aratzps/MCU-C/docs/DECISIONS.md

# MCU-C — Design Decisions

Newest last. Each entry records what was decided, why, and what it constrains.

---

## D001: Fully integrated inverter, not a control board

- **Decision:** Control, gate drive, DC link, precharge and power stage on one assembly.
- **Why:** Project owner's choice, made with the trade-off stated explicitly.
- **Consequence:** DC-link sizing, precharge/discharge, creepage/clearance and thermal become primary constraints on this design rather than the power stage vendor's. This is the harder path — the original project split brain and power stage deliberately.
- **Affects:** Everything. See SPEC.md §1.

## D002: STM32F405VGT6 (LQFP100)

- **Decision:** STM32F405VGT6 in LQFP100.
- **Why:** Same die and firmware target as the VESC reference, so mainline `bldc` firmware applies. 100 pins instead of the 64 on the `RGT6` used by the original PALTA board gives room for all four position-feedback interfaces plus CAN, USB and the supervisor without pin conflicts.
- **Consequence:** No CAN FD is available on any STM32F405 — it has classic bxCAN 2.0B only. VESC's CAN protocol uses classic CAN, so this is not a limitation in practice, but CAN FD must not be specified anywhere.
- **Affects:** SPEC.md §12, firmware target, CAN transceiver selection.

## D003: All four rotor position interfaces supported

- **Decision:** Hall, ABI/quadrature encoder, resolver (AD2S1205) and SinCos/SSI.
- **Why:** Project owner's requirement. Resolver is appropriate at this power level and carries over from the original board.
- **Consequence:** Drives the pin budget and is a main reason for choosing LQFP100 over LQFP64.
- **Note:** Mainline VESC has no resolver driver. The AD2S1205's incremental-encoder emulation outputs (A, B, NM) let the resolver present as a standard ABI encoder that VESC already supports — so no firmware work is needed for basic operation.
- **Affects:** SPEC.md §8.4, MCU package choice, `pcb_design/resolver.sch` reuse.

## D004: 1200 V switch class, six-pack module

- **Decision:** 1200 V devices, in a single six-pack power module rather than discretes.
- **Why:** 450 V bus with switching overshoot and regenerative transients rules out 650 V. A module gives one thermal interface, vendor-controlled stray inductance, an integrated NTC, and removes the paralleling/current-sharing problem entirely.
- **Open:** Si IGBT vs SiC not yet decided — see SPEC.md §14 item 2.
- **Affects:** Gate drive, thermal design, cost, efficiency.

## D005: Current limits are fixed; power scales with bus voltage

- **Decision:** The board enforces current limits, not power limits. 15 kW / 35 kW are defined at 250 V nominal only.
- **Why:** Project owner's clarification. Physically correct — the hardware limits are thermal and current, not power.
- **Consequence:** 2.9 kW / 6.7 kW at 48 V; 27 kW / 49 kW at 450 V by current limit alone. **The board is not rated for 49 kW** — switching losses scale with bus voltage and the thermal design is sized at 250 V. Derating above 250 V is an open item.
- **Affects:** SPEC.md §2.1, §3, thermal design.

## D006: Phase current sized 1.5× above the value at rated power

- **Decision:** 75 A rms continuous, 175 A rms peak, ±300 A sense range.
- **Why:** Phase current at rated power (50 A / 117 A rms) occurs at full modulation, i.e. high speed. At low speed the motor draws the same current for the same torque at much lower voltage, so phase current rather than power is binding. 1.5× allows full torque at low speed.
- **Caveat:** The 1.5× factor is a judgement call made without knowledge of the target motor or duty cycle. It directly sets device count and cost and should be revisited once those are known.
- **Affects:** SPEC.md §3.3, module selection, current sensing, thermal.

## D007: Three isolated phase-current measurements

- **Decision:** Per-phase current sensing, not a single DC-link shunt.
- **Why:** VESC FOC reconstructs the current vector from per-phase samples. A single bus-level shunt cannot provide this.
- **Affects:** SPEC.md §8.1, ADC allocation, isolation count.

## D008: Firmware-independent hardware interlocks, carried over from PALTA

- **Decision:** Overcurrent latch and shoot-through/PWM-overlap elimination in discrete logic, with the aggregated fault driving TIM1_BKIN.
- **Why:** The most valuable feature of the original board (`pcb_design/supervisor.sch`). Routing the fault to the timer break input means an MCU lockup, firmware bug or bad configuration cannot leave the bridge conducting.
- **Affects:** SPEC.md §9.2, pin assignment (PB12), supervisor schematic reuse.

## D009: HV-derived auxiliary supply plus external 12–24 V input

- **Decision:** Isolated flyback from the 48–450 V bus (≥ 900 V primary switch), and a separate 12–24 V auxiliary input.
- **Why:** Control electronics must power up before the DC bus is live in order to sequence precharge, and to permit safe bench work on a de-energised bus. The 9.4:1 input range is the hard part of the flyback design.
- **Affects:** SPEC.md §11, precharge sequencing, bench bring-up.

## D010: Liquid cooling as baseline

- **Decision:** Cold plate. Forced air only at a reduced, characterised continuous rating.
- **Why:** 300–525 W continuous dissipation at 15 kW depending on Si vs SiC. This is a physical consequence of realistic device losses, not a preference.
- **Affects:** SPEC.md §11.4, mechanical concept, enclosure.

## D011: Target motor — EMRAX 188, High Voltage winding

- **Decision:** EMRAX 188 (or similar class), HV winding assumed. Figures verified against EMRAX 188 datasheet v1.6 (2026-07-31): peak 190 A rms / 100 Nm (S2 2 min), continuous 100 A rms, Kt 0.54 Nm/A, Kv 13.61 rpm/V at nominal load, 10 pole pairs, 8000 rpm max, KTY 81/210 stator temperature sensor, resolver/encoder feedback.
- **Why:** Owner's choice of motor. HV winding is the engineering recommendation: at 250 V nominal the HV envelope (100 Nm at ≈ 3400 rpm ≈ 35.6 kW) lands on the board's 35 kW rated point, and its 190/100 A rms currents match a sensible power stage. MV needs 310 A rms peak, LV 390–900 A — both oversize the inverter. The motor's full 60 kW at 6500 rpm needs 660 V and is unreachable on a 450 V bus; accepted.
- **Consequence:** §3.3 re-derived from motor ratings, superseding the 1.5× guess (D006): 100 A rms continuous, 190 A rms peak (10 s), 270 A instantaneous, ±325 A sense, 300 A hardware trip. Module criteria rise to ≥ 150 A continuous / ≥ 270 A peak. DC-link ripple rises to 60/114 A rms. A motor temperature input (KTY 81/210) is added to §8.3.
- **Open:** Winding variant must be confirmed at motor order time; if it changes, §3.3 is re-derived. Duty cycle still unstated — 10 s board peak vs motor's 2 min S2 rating noted in §3.3.
- **Affects:** SPEC.md §2.2, §3.3, §3.4, §4.3, §6, §8.1, §8.3, §9.1, module selection, thermal.

## D012: Peak duration 120 s, matched to the motor's S2 rating

- **Decision:** t_peak = 120 s (was 10 s [SEL]). Owner directive: match the inverter peak time to the motor's S2 2 min rating.
- **Why:** The motor sustains 190 A rms / 100 Nm for 2 min; a 10 s board limit would waste that capability.
- **Consequence:** 120 s is quasi-steady-state for the module baseplate, cold plate and coolant loop (thermal τ of tens of seconds). Cooling must therefore be sized for peak-condition losses — ~700 W (SiC) to ~1225 W (Si) at 35 kW — not the 300–525 W continuous figures. Module continuous-class criterion raised to ≥ 200 A. DC-link ripple duty (114 A rms) must be held for the full 120 s, which drives the capacitor bank rating.
- **Affects:** SPEC.md §2, §3.3, §4.3, §6, §11.4. Strengthens the SiC side of open item 2.

## D013: DC-link capacitance confirmed conditionally on switching frequency

- **Decision:** 400 µF stands **if** f_sw ≥ ~23 kHz (SiC path, 25 kHz baseline). If Si IGBT at ~12 kHz, capacitance must rise to ≥ 750 µF for the same 1.5 % bus ripple.
- **Why:** Derivation in SPEC.md §6.1 — C ≥ I_ph,pk/(8·f_sw·ΔV_pp) with 270 A instantaneous peak and 3.75 V pp permitted at 250 V.
- **Consequence:** Capacitor voltage-ripple sizing is settled; the binding constraint is ripple *current* — a bank rated ≥ 80 A rms @ 70 °C with the 114 A / 120 s repetitive duty verified against the manufacturer's thermal model. Si path also carries a capacitor cost/volume penalty, which enters the Si-vs-SiC comparison.
- **Affects:** SPEC.md §6, §7.1 (precharge energy scales with C), open item 2.

## D014: Auxiliary supply controller — InnoSwitch3-AQ (candidate level)

- **Decision:** Power Integrations InnoSwitch3-AQ INN3990CQ (900 V PowiGaN, integrated FET) as primary candidate; INN3999CQ as alternate; discrete UCC28C42 + 1200 V SiC FET as fallback.
- **Why:** Only family found with a datasheet-guaranteed 30 V DC start covering the full 48–450 V (9.4:1) range at 20–30 W. Every other candidate fails on hard numbers: InnoSwitch3-EP min DC input 90 V and UV/OV pin ratio 4.4:1; LinkSwitch-XT2 11 W ceiling; InnoSwitch4 tops at 750 V; ST VIPer 800 V; onsemi NCP107x 700 V; MPS HFC0500 brown-in ≥ 95 V. Verified in stock (DigiKey, 2026-07-31).
- **Open:** Transformer design; 48 V full-load power is interpolated from the 30/60 V datasheet columns and must be confirmed; 650 V max recommended rail vs our 500 V transient is fine but noted.
- **Affects:** SPEC.md §11.2, §14 item 7, aux_power schematic sheet.

## D015: GaN ruled out for the power stage

- **Decision:** No GaN in the main power stage. GaN stays where it already is: the aux flyback's 900 V PowiGaN InnoSwitch3-AQ (D014).
- **Why:** Verified against shipping products (2026-07-31): no GaN device ≥ 900 V at ≥ 50 A exists in distribution (Transphorm's 900 V line is obsolete, was 34 A max); no GaN six-pack/half-bridge module suits a 450 V bus at 190 A rms; lateral GaN has no avalanche capability, which matters for regen transients; and a 25 kHz FOC drive gains nothing from GaN's switching speed while its dv/dt stresses motor insulation and bearings. The only >400 V-bus GaN path (650 V devices, 3-level topology) doubles switch count for no benefit here.
- **Re-evaluate if:** avalanche-rated vertical GaN or ≥ 900 V / ≥ 200 A-class GaN modules reach distribution.
- **Affects:** SPEC.md §4 (unchanged — Si vs SiC remains the open choice), docs/SI_VS_SIC.md §6.

## D016: SiC power stage

- **Decision:** SiC MOSFET module. Baseline part: Infineon FS02MR12A8MA2B (HybridPACK Drive G2, CoolSiC, 1.9 mΩ, 390 A class, $767 stocked). Right-sized alternative if stock appears: Microchip MSCSM120TAM11CTPAG.
- **Why:** Owner decision, informed by `docs/SI_VS_SIC.md`: at qty 1 SiC costs ~$635 more (~$280 net after DC-link/cooling/battery offsets); at 10 k/yr the net premium falls to ~$70–200/unit. SiC buys inaudible 25 kHz switching, ~½ the peak-condition heat (700 W vs 1225 W for the 120 s peak, which sizes the cold plate per D012), less mass, and better 450 V-bus behaviour.
- **Consequence:** f_sw baseline 25 kHz → DC-link stays 400 µF (D013). Gate drive becomes SiC-class: +15 V / 0…−5 V (per module datasheet, TBV), CMTI ≥ 100 V/ns, SiC-tuned desat. Module overtemp threshold 150 °C. Thermal design point: 300 W continuous / 700 W for 120 s. The HybridPACK G2's pin-fin baseplate means the "cold plate" is a coolant jacket sealing against the module, not a flat plate — this shapes the whole mechanical concept (§14 item 8). The 2SP0115T2A IGBT driver data stays as reference only.
- **Sourcing note:** 51 pcs stocked, 39-week factory lead behind them — buy prototype modules at design commit, not at layout completion.
- **Affects:** SPEC.md §4, §5, §6, §9.1, §11.2, §11.4; gate_drive and power_stage sheets; cold plate concept.

## D017: Gate driver — Infineon 1ED3491MC12M (candidate level); gate levels +18/−5 V

- **Decision:** 1ED3491MC12M (EiceDRIVER X3 Analog) as primary gate driver, six channels. Alternates: TI UCC21755-Q1 (SiC-tuned DESAT, AEC-Q) and UCC21750. Gate levels +18 V / −5 V. Isolated per-channel supplies: discrete push-pull (SN6505B + transformer) baseline, Murata MGJ2 preferred if lead time allows.
- **Why:** Verified against the FS02MR12A8MA2B datasheet: recommended VGS(on) 15–18 V with R_DS,on 1.90 mΩ at 18 V vs 2.40 mΩ at 15 V (+26 % conduction loss — hence +18 V), VGS(off) −5…0 V, Q_G 1.19 µC. The 1ED3491 is reinforced per IEC 60747-17, 200 V/ns CMTI (module dv/dt ≈ 14 V/ns), adjustable DESAT, Miller clamp pre-driver, current-source soft-off, per-channel fault, $6.31 with 2,670 in stock. Infineon's own automotive pairing (1EDI3035AS, used on their EV GB HPD2 SIC board for this exact module) has zero distribution stock — kept as the reference design to copy.
- **Ruled out on verified grounds:** Skyworks Si828x (no VDE 0884 VIORM), ADuM4136 (VIORM 849 V pk basic, no Miller clamp), ACPL-355JC (no stock, not automotive), STGAP1AS (obsolete, 2.5 kV rms, 50 V/ns), NCP51705 (not isolated).
- **Amended same day after full datasheet verification:** ST STGAP3SXS *qualifies* (reinforced VDE 0884-17, 200 V/ns, 10 A, SiC 6 V DESAT, $4.85 — cheapest qualifier) and onsemi NCD57000 qualifies (VIORM 1200 V pk, 100 V/ns min) — both added as alternates 4/5; 1ED3491MC12M remains primary. Murata MGJ2 caveat found: reinforced cert covers only 150 V rms working voltage (5.2 kV is a test voltage) — at 450 V bus the driver IC must be the reinforced barrier and the supply transformer is functional isolation, pending the compliance target (§14 item 4).
- **Also learned from the module datasheet:** temp sensing is a **diode per phase** (TS1–TS3), not an NTC — §8.3 corrected, needs current-source bias; no integrated current sense (external phase sensors stay per §8.1); PressFIT PCB requires the AN-G2-ASSEMBLY mating pattern — a hard mechanical constraint on the power PCB.
- **Affects:** SPEC.md §5, §8.3, §11.2, gate_drive sheet, power PCB mechanical.

## D018: Supervisor ported; dead-time claim in D008 corrected

- **What happened:** The PALTA supervisor was ported into `mcuc_inverter/supervisor.kicad_sch` (ERC 0 errors; 24/24 gate-by-gate netlist checks against the legacy `VESC-controller.net`). During the port, the reconstruction showed the original circuit performs **overlap elimination only** — NAND detects both inputs high, AND gates force both outputs low. It inserts **no dead time**: there is no deliberate turn-on delay anywhere in the discrete logic. D008's "hardware dead-time insertion" claim was wrong about the original board.
- **Resolution:** Dead time is generated by TIM1's silicon dead-time generator (configured by firmware, enforced by hardware, cannot be violated by compare-register values). The firmware-independent protection is (a) the ported overlap eliminator and (b) a turn-on RC delay network per gate-drive input, to be placed in the gate_drive sheet (~250 ns initial, TBV against switching characterisation). Together these mean even a totally misconfigured timer cannot command overlap, and simultaneous edges get a hardware-guaranteed gap.
- **Port deviations (recorded on-sheet):** all-3.3 V logic (the original BOM quietly fitted 5 V SN74ACT08 despite the schematic saying ALVC08 — revisit only if the chosen gate driver needs 5 V inputs; the 1ED3491 does not); single OC_TRIP open-drain input replacing the three wired-OR comparators (comparator lives with current sensing); added boot pullups on FAULT_RESET / DRV_RST_IN.
- **Affects:** SPEC.md §9.2, gate_drive sheet (RC delay network), D008 (corrected, not superseded — the latch and BKIN routing claims were accurate and are now netlist-verified).

## D019: Phase current sensing — LEM HOYS 200-S/SP33 aperture transducers

- **Decision:** Three LEM HOYS 200-S/SP33 (±500 A range, 3.3 V ratiometric, 1.65 V ref) on the phase outputs; 300 A hardware trip via an external window comparator per phase, open-drain wire-OR onto the supervisor's OC_TRIP. Spec bandwidth/latency re-derived for 25 kHz switching: ≥ 150 kHz / < 5 µs.
- **Why:** The shunt path died twice over: 0.75 mΩ (sized for ±250 mV amps) dissipates 27 W at the 120 s peak, and the low-dissipation 0.1 mΩ + ΔΣ route is blocked because the STM32F405 has no DFSDM peripheral (verified, ST AN4821) — the analog AMC1302 fallback was unstocked with 16-week lead. HOYS is the only verified in-stock transducer meeting range + reinforced isolation (IEC 61800-5-1, 5.4 kV rms tested) + native 3.3 V ADC mapping. Precedent: the VESC-based Axiom 100 kW inverter uses LEM aperture transducers for the same reasons.
- **Trade-offs accepted:** 180 kHz / 3 µs (fine at 25 kHz FOC); ±1.25 % @ 25 °C growing to ±4.55 % @ 105 °C (FOC uses relative phase balance; absolute accuracy affects torque calibration, acceptable for this application); the built-in OCD (584 A) is unusable for the 300 A trip — external comparators restore the PALTA per-phase comparator structure.
- **Sourcing note:** only 5 pcs at DigiKey at check — order with the module and drivers at design commit.
- **Affects:** SPEC.md §8.1, §9.1 trip implementation, current_sense sheet, motor phase routing (aperture transducers — busbars pass through), BOM.

## D020: Auxiliary power secondary architecture

- **Decision:** INN3990CQ flyback (DER-948Q 15 V pattern: RCD clamp, Schottky secondary — SR FET optional, FB divider at 1.265 V, Lp < 500 µH) → 15 V main rail; LM5175 buck-boost from the 12–24 V aux input, ideal-diode-OR'd (LM74610-Q1) into the same rail; LMR51430 bucks to 5 V (3 A) and 12 V [TBV]; TLV1117-33 for 3.3 V; four SN6505B push-pull stages **from the 5 V rail** with Würth 750316856 transformers (1:4.67 → 23 V, zener-split to +18/−5 V) for the gate supplies; Murata NXE2S0505MC for isolated CAN 5 V.
- **Why (verified facts that shaped it):** SN6505B is 5 V-only — 15 V-input push-pull needs SN6507 but no stocked transformer reaches +18/−5 from 15 V, while the 5 V-input 750316856 hits 23 V total exactly and is AEC-Q200; a plain boost for the aux input cannot regulate at 24 V in / 15 V out — the LM5175 4-switch buck-boost is the verified correct topology; Mornsun's B0505S CAN module is NRND/unstocked, Murata's NXE2S is stocked with 3 kV isolation.
- **Consequences:** the 5 V rail carries the ~8 W gate-supply load (within LMR51430's 3 A); gate-supply transformer isolation is functional-grade, reinforced barrier stays in the driver ICs (§5, D017 caveat); 12 V rail buck is the one unverified block [TBV].
- **Affects:** SPEC.md §11.2b/§11.3, aux_power sheet, precharge sheet (+12 V rail), BOM.

## D021: Mechanical concept — one PCB on the module; power via laminated busbar

- **Decision:** A single 1.6 mm PCB (the control/driver/aux board) mounts directly onto the FS02MR12A8MA2B via its PressFIT signal pins and the AN-G2-ASSEMBLY screw/heat-stake pattern — the HybridPACK reference architecture. **Power current never flows through the PCB**: the module's screw terminals (P1–P3/N1–N3, U/V/W) connect to a laminated DC busbar carrying the film-cap bank and battery input, and to phase busbars that pass through the HOYS transducer apertures to M6 output studs. Chassis-mounted parts, connectorised to the PCB: precharge relay, precharge resistor (50 W), discharge resistor bank (4× 25 W), coolant-loop NTC. On-PCB HV: the bus-sense divider string, the bleeder string (0.68 W/part), the aux flyback primary side — all inside a dedicated HV zone with §10 creepage.
- **Why:** The module's power terminals are screw-type busbar lugs — Infineon's own architecture separates power (busbar) from signal (PressFIT PCB). Putting 140 A DC / 190 A phase currents on PCB copper would require absurd copper weights; the 114 A rms cap-bank ripple demands the low-ESL laminated busbar that §6 already required.
- **Consequences:** One PCB to lay out (4-layer, 1.6 ±0.16 mm per PressFIT spec, 2 oz outer); the busbar is a documented mechanical part (drawing note, not gerbers); PCB outline and mounting are dictated by the module's Fig. 2–4 pattern; HOYS sensors connect by 5-pin JST PA harnesses.
- **Resolves:** SPEC §14 item 8.
- **Affects:** PCB layout, fabrication package scope, connector count, enclosure.

## D022: Sensing front-end decisions from verified constraints

- **Module TS diodes: provision-only in rev A.** Verified: the FS02MR12A8MA2B gives the TS pins no isolation rating (the module's 4.2 kV "basic" figure is terminal-to-heatsink only), and the only documented readout anywhere in Infineon's material is the HV-side ΔΣ ADC inside the 1EDI3035AS driver (zero distribution stock), referenced to the switch source and sent across the driver's own barrier. A control-GND op-amp front end has no datasheet basis. Rev A routes TS pads in the HV zone, unpopulated; module thermal protection = coldplate NTC (TDK B57861S0103F040, AEC-Q200, stocked) at the baseplate with a conservative threshold + DESAT as fast backstop. Upgrade path: 1EDI3035AS drivers (when stocked) or per-phase isolated amps.
- **Motor temperature: KTY 81/210 is obsolete** (NXP EOL 2020). Front end becomes resistor-selectable (PT1000 / KTY8x / NTC 10k — all VESC-supported); order the motor with PT1000 where offered.
- **Bus sense: AMC1311BDWV** (reinforced, V_IOWM 2120 V DC, 0–2 V input, stocked) behind a 4× 750 kΩ + 12.0 kΩ string (1.992 V at 500 V, 83 mW, 124.5 V/part). Diff-to-SE op-amp stage to the ADC. HV-side 3.3 V from an LDO off the VGD_LS rail [TBV noise review].
- **Resolver: AD2S1205 kept, order-early flag.** Zero DigiKey stock / 20-wk lead (TME residual stock exists). The PALTA circuit is proven and captured; AD2S1210ASTZ ($32, stocked) is the documented fallback but is a 48-LQFP redesign. Buy AD2S1205 at design commit alongside module/drivers/HOYS.
- **Comms: ISO1042DWR** ($5.28, stocked, 5 kV) replaces the legacy ISO1050. Board NTC: NCU18XH103F6SRB (NCP18 is NFND).
- **Affects:** SPEC §8.2/§8.3, temp_sense & bus_sense & comms sheets, §9.1 overtemp derivation, BOM, motor purchase order.

## D023: No phase-voltage sensing in rev A; MCU pin map fixed

- **Decision:** VESC's SENS1/2/3 phase-voltage inputs are not fitted. PA0/PA1/PA2 (ADC123_IN0/1/2 — the exact VESC channels) stay reserved; the custom hw header disables phase-filter/BEMF features that need them. The full pin map (docs/PINOUT.md) is fixed per the verified assignment: I_PH on PC0/1/2 = VESC CURR1/2/3 rank-1 triple-simultaneous channels, V_BUS PC3, temps PA3/PB0/PC4, SinCos PA5/PA6, encoder PC6/7/8 (TIM3), halls PD12/13/14, resolver SPI3 PC10/PC11 + PA15 CS (reset pull-up holds CS high through boot; SWD-only constraint, already true), control GPIOs on PD/PE with boot-safe pulldowns verified per driver, servo/PPM PB6 (TIM4_CH1, VESC convention).
- **Why no phase sensing:** stock VESC boards float at battery potential and divide the phase voltages directly. This board's control domain is isolated (§10); direct dividers are impossible, and isolated sensing costs 3× AMC1311 + per-phase HV supplies for a feature (phase filters / BEMF startup assist) that FOC with 3-phase current sensing + 4 position interfaces does not need. Documented firmware consequence, upgrade path reserved.
- **Affects:** mcu.kicad_sch wiring, custom `hw_mcuc.h` (ADC vector mirrors hw_100_250 minus SENS), docs/PINOUT.md, VESC feature set (phase filters off).

## D024: Two-board partition; off-board component conventions

- **Decision:** The design produces **two PCBs** plus the busbar mechanical assembly:
  1. **Control/driver board** (`mcuc_inverter` project) — everything except the DC-link caps: MCU, supervisor, gate drive, aux power, sensing front ends, precharge relay (its 0.36 A contact path is board-viable; contacts provide the required isolation), discharge FET. HV interfaces via screw/faston terminals: DC_INPUT_P, precharge-resistor loop out/in, DC_BUS_P/N low-current taps (divider, bleeder, flyback, discharge return).
  2. **DC-link capacitor carrier** (`mcuc_dclink` project, heavy-copper 2-layer) — the 5× MKP1848C bank plus M6 terminations to the laminated busbar and module screw terminals. Carries the 114 A rms ripple; the control board never does.
- **Off-board convention in the control-board project:** symbols whose bodies live off-board keep their nets but either carry `exclude_from_board` (C201–C205 → carrier; chassis resistors R401/R421–424; HOYS transducers → busbar-mounted, presenting as JST headers) or footprints that deliberately lack pads for off-board pins (the module's power terminals — its footprint is signal-PressFIT only). Schematic parity warnings from these are documented, not silenced, in the layout record.
- **Why:** MKP1848C are PCB-pin parts, but hanging 114 A rms on control-board copper would be absurd; a dedicated heavy-copper carrier between busbar plates is the standard, manufacturable pattern and honors D021's "power never flows through the control PCB".
- **Affects:** new `mcuc_dclink` project, precharge sheet terminals, footprint assignment pass, fabrication package (two gerber sets), BOM board column.

## D025: Corrections from adversarial review 1

- **Thermal design point corrected.** Module losses computed from the FS02MR12A8MA2B loss tables rather than a technology-class efficiency estimate: **~390 W continuous, ~1040 W at the 250 V peak condition, ~1440 W at 450 V** (η 97.1 % at peak, not 98 %). The module keeps 3–4× junction margin (R_th,j-f 0.121 K/W vs 0.36–0.49 required), so the correction lands entirely on the **coolant loop and heat exchanger**, which must reject ~1.05–1.45 kW. There is no separate cold plate to design — the G2 is direct-cooled and needs a jacket per AN-G2-ASSEMBLY at ≥10 dm³/min, ≤65 °C.
- **500 µF re-derivations.** SPEC had carried 400 µF-based numbers after the bank was selected as 5 × 100 µF. Precharge energy 40.5 J → **50.6 J** (65 J spec including the 500 V case), precharge 2.5 s → **3.13 s** (firmware timeout ≥3.2 s), and the passive bleeder **failed its own <60 s requirement** at 75.4 s → changed to 56 kΩ (4 × 14 kΩ), 56.4 s.
- **Internal ambient specified at ≤70 °C** (§11.5). Its absence made several margins uncheckable; this is now a requirement to verify at bring-up.
- **Contactor coil current is a requirement, not an assumption** — 1.7–2.5 A for a 35 kW-class contactor, which sizes the 12 V rail and mandates a ≥1 A freewheel diode.
- **Active discharge must be hardware-inhibited while the bus is live** — otherwise a commanded discharge dissipates 230 W in a 100 W bank.
- **SPEC open item 5 closed**: the 114 A / 120 s ripple duty is verified against Vishay's thermal model with margin (14.7 K per cap; the block's ~43 min time constant means the 120 s pulse adds ~0.7 K).
- **Affects:** SPEC §7.1, §7.2, §11.2, §11.4, §11.5, §14; cooling system sizing; firmware precharge timeout; schematic fixes tracked in `docs/REVIEW_FINDINGS.md`.

## D026: Gate drive derated to +15 V; fault-clear and trip paths rebuilt

Consequences of adversarial review 3 (`docs/REVIEW_FINDINGS.md`). These are safety-path changes, so the reasoning is recorded in full.

- **V_GS(on) derated +18 V → +15 V.** The module's short-circuit withstand is **t_SC < 1.2 µs at −5/+18 V but < 2 µs at −5/+15 V**. The as-drawn DESAT chain took ~5.8 µs; even optimally configured the 1ED3491 reaches ~2.0 µs, so the 18 V rating was unreachable and the 15 V rating is merely *attainable*. Cost: R_DS,on rises 1.90 → 2.40 mΩ (+26 % conduction loss, ≈ +122 W at the peak condition, absorbed by the module's 3–4× junction margin). Benefit beyond DESAT: it simultaneously removes the +19 V absolute-maximum overstress that review 1 found on the open-loop gate rail.
- **D017 deliberately NOT reopened.** Switching to a SiC-threshold driver (UCC21755-Q1 at 5.0 V, STGAP3SXS at 6.0 V — both qualified in SPEC §5) was considered and rejected: the dominant delays are the *configurable* blanking filter (1575 ns) and soft-off current, not the 9.18 V threshold, so a six-channel driver respin buys little. Instead ADJB is tied to VCC1 (400 ns LEB + 225 ns filter) and ADJA raised to 28.0 kΩ (699 mA soft-off).
- **Residual risk — amended after implementation, and it is worse than I estimated.** With the chain actually configured and every parameter summed, the measured-on-paper result is **1.9 µs typical but 2.6 µs on all-worst-case silicon**, against the 2 µs withstand. My original "~2.0 µs" understated it. So: *typical parts pass; worst-case parts do not.* The dominant term is the soft turn-off itself (1.15–1.43 µs to discharge the gate at the family-maximum 699 mA) — and that slowness is deliberate, because a hard turn-off into a short produces the overvoltage spike soft-off exists to prevent. This is not a value that can simply be tightened.
- **One physical factor works in our favour and must be measured, not assumed:** the module's t_SC is specified at **V_DD = 750 V**, while this design's maximum bus is 450 V and its nominal is 250 V. Short-circuit current, and therefore the rate of die heating, fall steeply with bus voltage, so the true withstand at our operating point is longer than the datasheet figure. That is a sound argument but an unquantified one — it is a reason to expect the validation to pass, not a substitute for running it.
- **Consequences, recorded rather than rounded away:** the exposure is a hard external short (phase-to-phase or phase-to-ground) on worst-case silicon at maximum junction temperature. The *internal* shoot-through case — the more likely one — is prevented upstream by the overlap eliminator, which is firmware-independent. **The double-pulse short-circuit validation is a gate on production release.** If it fails: (a) characterise a faster soft-off and accept the turn-off overvoltage it produces, which requires double-pulse measurement of the resulting spike against the 1200 V rating, or (b) reduce the peak current rating, which lengthens the withstand, or (c) reopen D017. None of these is a value tweak.
- **CR-1 — the fault-clear loop is broken by design and must be rebuilt.** `DRV_RST_OUT = DRV_RST_IN AND FAULT_BKIN AND OC_LATCH_N` could never produce the rising RDYC edge the driver needs, because RDYC could only rise once FLT_N was already high. FAULT_BKIN is removed from that chain, and a power-on-reset network guarantees one clear pulse without firmware. Nothing is lost: the FLT_N wire-OR already provides hardware fault-off to all six drivers.
- **MJ-1 — the overcurrent trip now actually reaches TIM1_BKIN.** It previously terminated at a supervisor gate and a status GPIO, so SPEC §9.2's central claim was false as built and the trip's only effect hung on a single resistor. `OC_LATCH_N` is wire-OR'd into `FAULT_BKIN` so an overcurrent latch tri-states the PWM in silicon, as the specification always claimed.
- **Affects:** SPEC §5, §9.1, §9.2, §11.4 (loss figures rise again with the +15 V derate); gate_drive and supervisor sheets; gate-supply rail design; bring-up plan.

## D027: 88S1P dual-chemistry pack; operating window 220–370 V

- **Decision:** The pack is 88S1P Desten 10135170 pouch in two chemistry SKUs sharing one fixture: LFP 22 Ah "Life" (281.6 V nominal, 220–321 V, 6.2 kWh) and NMC 32 Ah "Range" (325.6 V nominal, 264–370 V, 10.4 kWh), both 6C-charge rated per datasheet. Bus OVP moves 490 → 400 V and UVLO 45 → 200 V. The 48–450 V envelope is retained as hardware capability.
- **Why:** DCFC compatibility decided the bus class — CCS floors at 150/200 V, every production DCFC motorcycle sits at ≥ 300 V, and a sub-window pack simply cannot charge. 88S clears both defects of 80S (peak C-rate stays inside the cell's 132 A rating; 220 V empty clears the legacy 200 V floor) and saves ~137 mm of stack against 100S.
- **What it costs to adopt, as of 2026-08-14:** nothing in hardware. §8.2's bus sense is analog-only into the ADC, so OVP/UVLO are firmware thresholds and its 0–500 V range already spans both new ones. The D014 aux supply (INN3990CQ) covers 220–370 V with margin; the D016 module, the DC-link bank and every creepage rule were sized against the retained 450 V envelope and are unaffected. §3's currents come from the motor (D011/D012), not the bus, so they do not move. The EMRAX 188 HV winding reaches ≈ 3830 rpm at the LFP nominal and ≈ 4430 rpm at the NMC nominal, both above the 3400 rpm of the 250 V rated point.
- **Caveats:** LFP SKU peak ≈ 33–34 kW through the shared winding (−4 %), tapering below ~20 % SoC; the 15–45 °C rapid-charge window makes pack pre-heating a launch requirement; the LFP datasheet's 160 Wh/kg headline is unreconciled — use 142.
- **Evidence:** OrekaVault `01-knowledge/engineering/ARCHITECTURE-2026-07-30-dual-sku.md` and the bus-voltage A/B study. **Not verified in this repository** — this record carries the decision, not its derivation.
- **Affects:** SPEC §2, §2.1, §2.2, §9.1, §11.1; firmware OVP/UVLO thresholds; a charge-port section still to be written (§13). Optional, not required: rescaling the §8.2 divider from 0–500 V to 0–400 V to buy ADC resolution.

---

## Superseded

The documents generated on 2026-07-30 by an autonomous copperhead run (`SPEC.md`, `BOM.md`, `PINOUT.md`, and the first `DECISIONS.md`/`CHANGELOG.md`) were removed rather than corrected. They contained fabricated part numbers, a non-existent MOSFET as the central BOM item, an unusable pinout, and several component selections that would have destroyed hardware on power-up. Verification never ran on them because no schematic existed, so copperhead's ERC/DRC gate was inert. Recorded here so the reasoning is not rediscovered later.
