aratzps/MCU-C/mcuc_inverter/phaseA2_exports/top_render.png

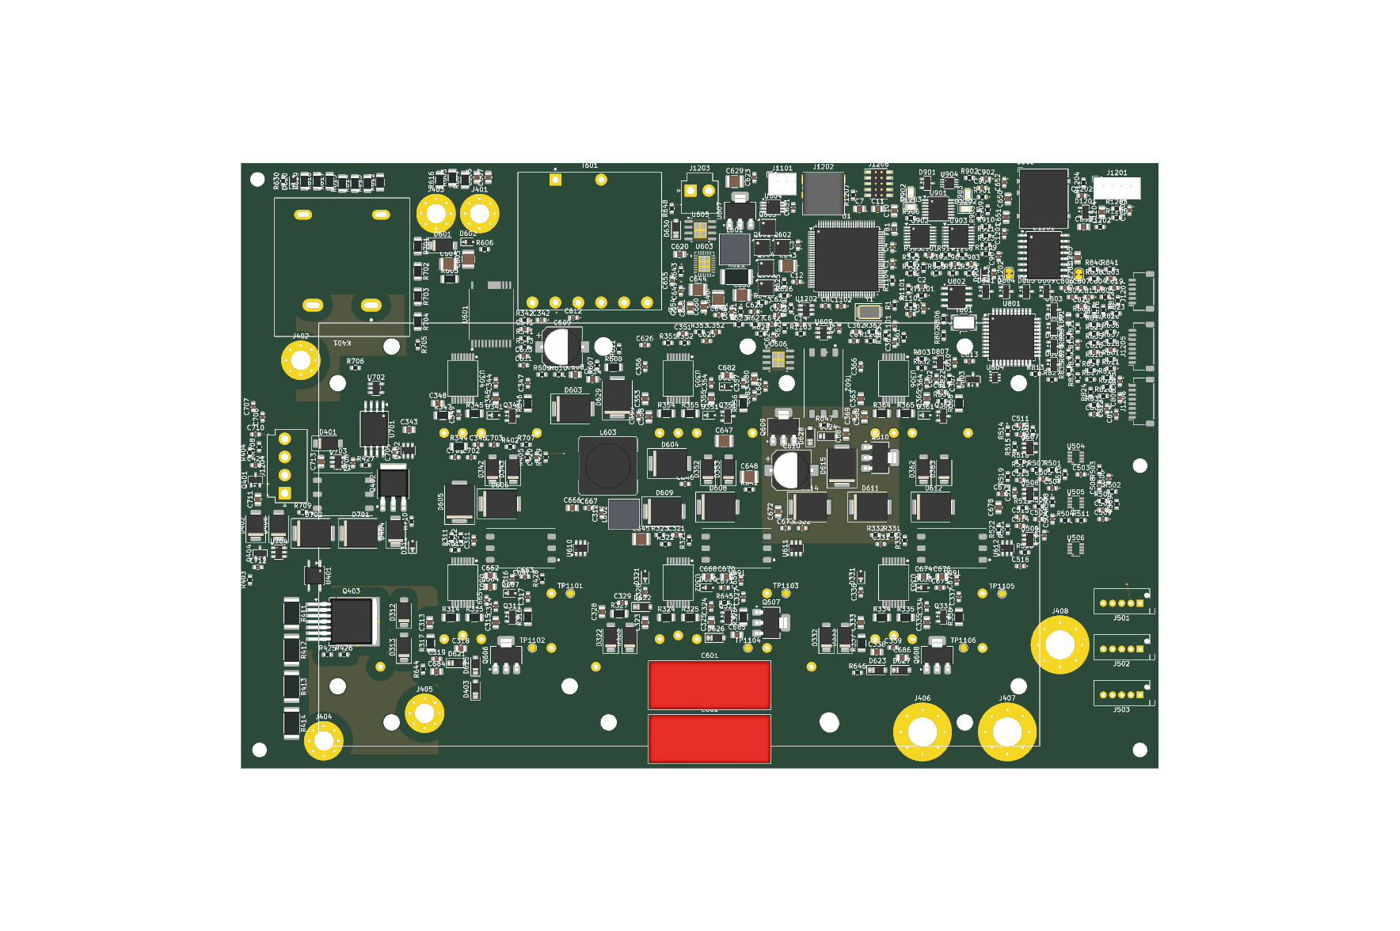
mcuc_inverter/phaseA2_exports/top_render.png
