aratzps/MCU-C/mcuc_inverter/phaseA_exports/render_top.png

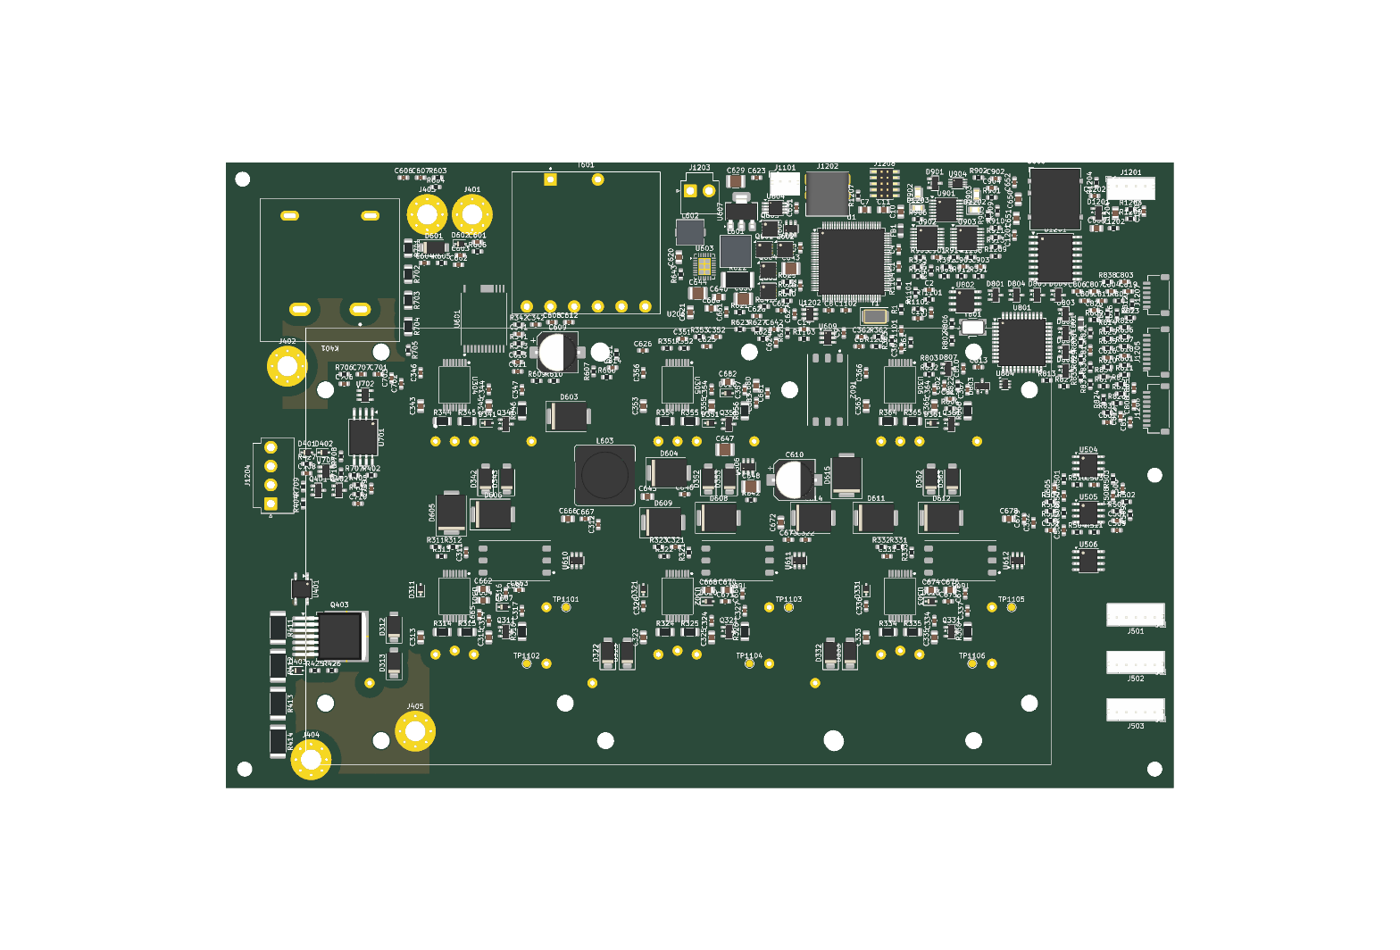
mcuc_inverter/phaseA_exports/render_top.png
