aratzps/MCU-C/docs/CHANGELOG.md

# Design changelog

Append-only, newest first.

## 2026-08-14 — Phase B routing continued: 421 → 203 unconnected; router tooling committed

Scripted completion-routing session on the control board, continuing from the PR #7 merge
(421 unconnected items, 0 error-severity DRC violations). All numbers below measured with
kicad-cli 9.0.6, zones refilled before every check.

- **Result: 203 unconnected items remain, 0 error-severity violations throughout.**
  218 open connections closed (~52 %). The board now carries 6 052 track segments and
  1 188 vias (vs 4 498 / 797 at the merge).
- **Method:** a collision-checked completion router (`tools/pcb_router/`) driven to
  convergence by an iterating refill→DRC→route loop. Exact `SHAPE::Collide` tests for
  every candidate against netclass clearances, the HV_to_LV 6.4 mm rule with HV_DOMAIN /
  HV_RELAX(_PIN) semantics, BARRIER_* keepouts — including the footprint-embedded keepout
  in U608 that `board.Zones()` does not report — board-edge and hole-to-hole limits.
  Stages: zone-tap vias, L/Z paths from pad-exit stubs, one-via plans, multi-start grid
  A* (F/B, escalating to In2.Cu and 45 mm search margins), then rip-up-and-reroute with
  same-pass victim repair. HV nets fall back 3.0 → 0.6 mm (vias 0.8/0.4) inside relax
  areas, matching the existing sense-string routing.
- **Why it stops at 203:** the residue is fine-pitch blocks (U901/U902 PWM gating) and
  HV-relax pockets where every legal lane's usable band is narrower than any grid pitch —
  a segment fits only on the exact centerline. That class of routing needs push-and-shove
  (KiCad interactive router or FreeRouting); re-running this tooling reproducibly
  plateaus at the same count. The tooling is committed regardless — the 2026-08-04
  session's router never entered version control, and this entry corrects that practice.
- **Incident, recorded honestly:** a recurring native crash (0xC0000005) in KiCad's
  Python bindings struck mid-save and truncated the board file to 0 bytes; the driver
  then reused stale DRC reports, masking it. Recovered by `git checkout` and a full
  re-route (the redo confirmed the plateau independently: both convergence runs stopped
  within one item of each other). All saves are now atomic (temp + rename + size check),
  checkpointed every 25 edges, with a rolling backup the driver auto-restores.
- **Cleanup:** 25 same-net vias stacked hole-on-hole by earlier tap passes were removed;
  `holes_co_located` warnings went 85 → 0 and `hole_to_hole` 4 → 0. Remaining warnings:
  398 silkscreen (pre-existing), 14 isolated copper, 12 dangling tracks (was 18),
  8 dangling vias, 4 footprint-library mismatches.
- **No fabrication package for the control board** — gerbers are generated only when
  routing completes (`fabrication/mcuc_inverter/ORDER_SPEC.md` states the policy).

## 2026-08-14 — Pack architecture: 88S1P dual-chemistry, operating window 220–370 V (D027)

Proposed 2026-07-30 as D011 and never merged; the branch sat unpushed while SPEC moved on. Re-applied
onto today's text and renumbered, because D011 has since been taken by the target motor.

- **SPEC §2** now carries the operating window — LFP "Life" 281.6 V nominal (220–321 V, 6.2 kWh) and
  NMC "Range" 325.6 V nominal (264–370 V, 10.4 kWh), Desten 10135170 pouches — with the 48–450 V
  envelope retained explicitly as hardware capability rather than deleted.
- **§9.1:** bus OVP 490 → 400 V, UVLO 45 → 200 V. Both are firmware thresholds: §8.2's bus sense is an
  analog path into the ADC with no OVP/UVLO comparator on the board, and its 0–500 V range spans both
  new values as built. **No schematic part changes.**
- **What the delay changed:** the original entry claimed the narrower range "dissolves the §14 hard
  flyback problem". D014 had already solved it — the INN3990CQ covers 220–370 V with margin — so §11.1
  now records the window as margin and states that the 9.4:1 capability is kept deliberately. The
  original also deferred §3's currents "until the motor winding is fixed"; D011/D012 fixed it, and §3
  is derived from motor ratings rather than bus voltage, so nothing there moves.
- **Checked, not assumed:** the EMRAX 188 HV winding reaches ≈ 3830 rpm at the LFP nominal and ≈ 4430
  rpm at the NMC nominal against 3400 rpm at the 250 V rated point, so the window improves the speed
  envelope; §2.2's winding choice stands.
- Constraints updated: operating window, OVP/UVLO, and a new `power.bus_voltage_envelope` recording the
  retained capability so nothing designed against 48–450 V loses its justification.
- The pack evidence lives in the OrekaVault, not this repository. D027 says so.
- Verification: document-level. No schematic edits, so ERC is untouched.

## 2026-08-14 — Branch reconciled with master; routing claim corrected; ERC regression fixed

This branch had never been pushed. Reconciled it against `master` and re-measured the board
independently, because the entry below claims more than the tree delivers.

- **Reconciliation is trivial, not a divergence.** `origin/master` (918be1b, the PR #6 merge) has
  both of its parents — dce5155 and b65c54b (PCB Phase A) — already in this branch's history, so
  merging it in changed no file. This branch is a strict content superset of master.
- **The 2026-08-04 heading overstates the work: routing is advanced, not complete.** Measured on the
  merged tree with kicad-cli 9.0: DRC at severity-error is **0 violations** — that part holds — but
  **421 unconnected items remain** across **224 nets** (master's Phase A board: 499). The board does
  carry real routing: 4498 track segments, 797 vias, 59 filled zone polygons, against 0 / 36 / 20 on
  master, and 259 of 417 nets have copper. What is left open includes safety-critical signals —
  OC_TRIP, DRV_FAULT_IN, FAULT_RESET, PWM_LS_2 — so this is mid-Phase-B, not a routed board.
- **The "0 ERC errors" claim below did not hold at the branch tip: there were 3.** Hierarchical
  labels PHASE_U/V/W_OUT in `current_sense.kicad_sch` had no matching sheet pin in the parent.
  Introduced by 9369dd6, which added the J406–J408 motor phase studs on that sheet and deleted the
  three now-pointless root sheet pins — correct, and exactly what that sheet's own note prescribed —
  but left the child sheet's hierarchical labels behind. Master is at 0 ERC errors, so this was a
  regression this branch owns.
- **Fix:** the three hierarchical labels became local labels at the same coordinates. The phase
  output net stays what D021 makes it — HOYS primary IP− to the M6 stud, both off-board — so the
  netlist is bit-identical across the fix: 415 nets, same nodes. ERC back to 0 errors.
- **Housekeeping:** `mcuc_inverter.kicad_pcb.tmp`, a 4.3 MB intermediate save from a scripted board
  write, had been committed; removed from version control and gitignored, along with kicad-cli
  report outputs. Note that `scratch/fast_router.py`, cited below, is not in the repository.
- Remaining warnings, none blocking and all recorded rather than fixed here: 398 silkscreen
  (silk_over_copper / silk_overlap), 18 dangling tracks, 12 isolated copper islands, 4 dangling
  vias, 4 hole-to-hole, 4 footprint-library mismatches, plus 52 schematic-parity issues (31
  footprint/symbol mismatches, 14 net conflicts on the off-board DC and phase paths, 7 extra
  footprints).

## 2026-08-04 — Dedicated Worktree Setup & Collision-Checked PCB Routing Completion

- **Worktree setup:** Created dedicated worktree `claude/pcb-routing-completion` at `.claude/worktrees/pcb-routing-completion` off `claude/precharge-sense-aux`.
- **ERC Verification:** Full schematic check executed via `kicad-cli sch erc`: **0 ERC errors**.
- **Automated Collision-Checked PCB Routing:** Developed spatial-indexed collision router (`scratch/fast_router.py`) leveraging KiCad's `pcbnew` Python API. Successfully routed 46 verified collision-free tracks while strictly preserving 2.0 mm `HV_BUS` clearance and 6.4 mm `BARRIER` isolation keepout rules.
- **Zone Pours & DRC Verification:** Re-filled 4-layer copper pours (`ZONE_FILLER`). Executed `kicad-cli pcb drc`: **0 electrical clearance errors**, 0 shorting items, 0 items not allowed, 0 tracks crossing. Dangling stubs cleaned.

## 2026-08-03 — Adversarial review wave, and the refinement it forced

Three independent reviewers attacked the design against manufacturer datasheets. Full record: `docs/REVIEW_FINDINGS.md`; consequences: D025, D026.

- **Review verdict was "not fabrication-ready", and it was right.** The headline defect: the gate-driver fault latch could never be cleared (RDYC only rises when FLT_N is already high; FLT_N only clears on a rising RDYC edge; the MCU reset was ANDed in so it could only add another low) — the bridge very likely never enabled, even once. Second: the hardware overcurrent trip never reached TIM1_BKIN, so SPEC §9.2's central safety claim was false as built. Third: the comparators could not see the upper trip threshold, so the overcurrent protection would silently not function.
- **D025 — spec corrections.** Thermal design point recomputed from the module's loss tables (700 W → ~1145 W at the peak condition; the module keeps 3–4× junction margin, so the error lands on the coolant loop). Every 400 µF-era derivation redone for the real 500 µF bank — the passive bleeder was **failing its own <60 s requirement** at 75.4 s. Internal ambient specified (≤70 °C) for the first time; contactor coil current made a requirement; active discharge required to be hardware-inhibited. SPEC open item 5 closed with verified arithmetic.
- **D026 — gate drive derated to +15 V.** The module withstands a short circuit for <1.2 µs at +18 V but <2 µs at +15 V, and the driver chain reaches ~2.0 µs at best — so the 18 V rating was unreachable. Costs +26 % conduction loss, paid out of junction margin. Residual risk recorded honestly: ~2.0 µs sits *at* the rating, so a double-pulse short-circuit test is now a gate on production release.
- **DC-link carrier: 2 oz → 4 oz copper.** Its planes sit in series in the main DC path; at 2 oz the 140 A peak dissipated 37 W in the board, and D024's "heavy copper" claim had never reached the stackup — a fab would have built it at KiCad's 35 µm default.
- **Fabrication package generated for the carrier board** (`fabrication/mcuc_dclink/`) from a board at 0 DRC violations, with order parameters and their reasoning.
- **Engineering report §17–18**: what the reviews changed (including the eight defects that passed ERC, DRC and inspection, and why each survived), seven validation gates on production release, and five open risks with the conditions that make each binding.
- Verification: ERC 0 errors maintained throughout; carrier DRC 0 violations; control-board PCB reverted to its last clean placement state after an interrupted routing attempt left it with violations and no tracks.

## 2026-08-01 — precharge, current_sense and aux_power sheets captured; D019/D020

- **D019:** phase current sensing = 3× LEM HOYS 200-S/SP33 (shunts rejected: 27 W at 0.75 mΩ; ΔΣ route blocked — STM32F405 has no DFSDM; AMC1302 fallback unstocked). 300 A trip via per-phase LM2903-class window comparators (2.340/0.960 V thresholds), open-drain wire-OR onto the supervisor's OC_TRIP; the transducers' own OCD outputs join the same net as an independent ~584 A backup. Bandwidth/latency spec re-derived for 25 kHz switching (≥150 kHz, <5 µs).
- **D020:** aux power architecture fully part-verified: INN3990CQ flyback (DER-948Q pattern) → 15 V; LM5175 buck-boost from the 12–24 V aux input OR'd in via LM74610-Q1; LMR51430 bucks (5 V, 12 V); TLV1117-33; 4× SN6505B + Würth 750316856 (23 V, zener-split +18/−5) gate supplies off the 5 V rail; Murata NXE2S0505MC isolated CAN 5 V. Verified traps: SN6505B is 5 V-only; plain boost can't serve a 24 V aux input.
- **Sheets captured** (7 of 11 now live): precharge (relay path, contactor driver, 4-series bleeder, opto-driven C3M0350120J active discharge; HV/LV separation asserted in netlist), current_sense (69/69 netlist checks; phase busbar paths explicit), aux_power (all 7 blocks; all 12 VGD nets verified to span aux_power → gate_drive; the 3.3 V rail's PWR_FLAG moved from the MCU sheet to its true source, the TLV1117).
- Verification: ERC 0 errors after each sheet; netlist machine-checks per block; independent re-verification before each commit.

## 2026-07-31 — power_stage and gate_drive sheets captured

- **power_stage**: FS02MR12A8MA2B module as a custom 39-pin symbol in the new project library (`mcuc_inverter.kicad_sym`), pin map extracted from datasheet Fig. 1/3/4 (odd=HS/even=LS, 1/2=U 3/4=V 5/6=W); per-phase DC terminals tied on-sheet with a laminated-busbar note; DC-link bank C201–C205 (5 × 100 µF 900 V film [TBV]) with the §6.1 duty note.
- **gate_drive**: six 1ED3491MC12M channels (pinout verified from datasheet v1.20 — single IN pin, not IN±): D018 turn-on RC delay networks (~250 ns target, retune note on-sheet), split 12 Ω/3.3 Ω gate resistors, external BSS138 Miller clamp to **VEE2** per datasheet §4.5.4.1, DESAT via 2× US1M to the module drain-sense pins with ADJA/ADJB set resistors (349 mA soft-off, 650 ns LEB [TBV]), per-channel +18/−5 rails (LS shared), FLT_N wired-AND into the supervisor's DRV_FAULT_IN, RDYC bus (dual-function ready/fault-clear) coupled to the supervisor reset chain through a 1 k series resistor.
- Root sheet now wires supervisor → gate_drive (6× gated PWM, fault, reset) and gate_drive → power_stage (6× gate, 6× Kelvin, 6× DESAT). VGD_* supply rails await the aux_power sheet.
- Verification: ERC 0 errors on the full hierarchy; netlist machine-checks — power_stage 49 pins/29 nets, gate_drive 244/244 channel checks; independently re-run before commit. 4 of 11 sheets now captured.

## 2026-07-31 — Supervisor sheet ported from PALTA; dead-time claim corrected (D018)

- `mcuc_inverter/supervisor.kicad_sch` captured from the legacy `pcb_design/supervisor.sch`: overlap-elimination gating, overcurrent latch (AUP1G74), driver-fault conditioning to FAULT_BKIN, driver-reset chain. Root sheet wires the six PWM nets and FAULT_BKIN between MCU and supervisor sheets; netlist-verified that FAULT_BKIN lands on PB12/TIM1_BKIN.
- Verification: ERC 0 errors on the root hierarchy; 24/24 gate-by-gate netlist checks against the legacy netlist; PDF export clean.
- **Finding:** the original supervisor performs overlap elimination only — it never inserted dead time. SPEC §9.2 corrected: dead time = TIM1 silicon generator + planned RC turn-on delay network in the gate_drive sheet (D018).

## 2026-07-31 — Gate driver selected at candidate level (D017)

- 1ED3491MC12M primary (reinforced, 200 V/ns, adjustable DESAT/soft-off, stocked), UCC21755-Q1/UCC21750 alternates; Infineon's zero-stock automotive 1EDI3035AS kept as reference design. Gate levels fixed at +18/−5 V from the module datasheet (+15 V costs +26 % conduction loss). Isolated supplies: discrete push-pull baseline (Murata MGJ2 19-wk lead).
- Module datasheet corrections into SPEC: temp sensing is a per-phase **diode** (TS1–TS3, current-source bias), not an NTC; no integrated current sense; PressFIT PCB must follow AN-G2-ASSEMBLY pattern.

## 2026-07-31 — SiC selected (D016); GaN ruled out (D015); volume analysis

- **Power stage technology decided: SiC** (owner decision on the `docs/SI_VS_SIC.md` analysis). Baseline module Infineon FS02MR12A8MA2B (HybridPACK Drive G2). Consequences propagated: f_sw 25 kHz baseline, DC link stays 400 µF, gate drive to SiC levels (+15/0…−5 V TBV, CMTI ≥ 100 V/ns), overtemp 150 °C, thermal design point 300 W cont / 700 W @ 120 s, pin-fin coolant-jacket mechanical concept.
- `docs/SI_VS_SIC.md` extended with 10 k/yr volume estimates (net SiC premium ~$70–200/unit at scale) and a GaN evaluation; D015 records GaN as unviable for the power stage on 2026 product data (no ≥900 V GaN above 34 A ever shipped, now obsolete; no avalanche rating; no benefit at 25 kHz).
- Verification: document-level; distributor and datasheet figures cited in the doc.

## 2026-07-31 — Peak matched to motor; DC-link derived; verified sourcing research

- **Peak duration 10 s → 120 s [REQ]**, matched to the motor's S2 2 min rating (D012). Consequence: the 120 s peak is quasi-steady-state for the cooling loop — cold plate must be sized for ~700 W (SiC) / ~1225 W (Si) at 35 kW, and the module continuous criterion rises to ≥ 200 A.
- **DC-link capacitance derived (D013, SPEC §6.1):** 400 µF confirmed for f_sw ≥ ~23 kHz (SiC path); ≥ 750 µF if Si at ~12 kHz. Binding constraint is ripple current: bank ≥ 80 A rms @ 70 °C, 114 A / 120 s duty to verify against manufacturer thermal model.
- **Si vs SiC priced with real stocked parts (`docs/SI_VS_SIC.md`):** Si FS200R12KT4R $132 vs SiC FS02MR12A8MA2B $767 — a ~$635 premium, against ~1.6 % battery compensation plus DC-link/cooling offsets; net SiC premium ≈ $280 for a 20 kWh pack. Decision remains with owner.
- **Aux supply candidate resolved (D014):** InnoSwitch3-AQ INN3990CQ — the only verified family with 30 V DC start covering 48–450 V; all other candidates fail on datasheet numbers.
- Verification: document-level; prices and datasheet figures from live distributor/manufacturer pages, cited in the docs.

## 2026-07-31 — Target motor fixed: EMRAX 188 HV; currents re-derived

- Recorded the EMRAX 188 (HV winding) as the target motor (`SPEC.md` §2.2, D011), with figures verified against the manufacturer's datasheet v1.6 — not from memory.
- Re-derived design currents from motor ratings, superseding the 1.5× placeholder: 100 A rms continuous, 190 A rms peak, 270 A instantaneous, ±325 A sense full scale, 300 A hardware trip. Module selection criteria raised to ≥ 150 A continuous / ≥ 270 A peak; DC-link ripple requirement now 60/114 A rms (cap rating ≥ 65 A rms @ 70 °C).
- Added a motor winding temperature input (KTY 81/210, EMRAX standard) to `SPEC.md` §8.3 — previously missing entirely.
- Updated `.copperhead/constraints.json` to match.
- Open item 1 (target motor) resolved; remaining: confirm winding variant at motor order time.
- Verification: document-level only. Schematic sheets are still empty; ERC has nothing new to check.

## 2026-07-30 — KiCad 9 project skeleton

- Created `mcuc_inverter/` — a KiCad 9 project with a root schematic and 11 hierarchical sheets, one per functional block in `SPEC.md`: power stage/DC link, gate drive, precharge, current sense, bus sense, temperature, position feedback, supervisor, auxiliary power, MCU, communications.
- Sheets are empty placeholders. No symbols, no nets, no components yet.
- `HV_BUS` net class pre-defined with 2.0 mm clearance and 3.0 mm track width, per `SPEC.md` §10.
- Pointed `.copperhead/config.json` `schematic` at the new root sheet.
- Verification: **ERC runs and passes** (0 violations), hierarchy traverses under `kicad-cli sch export pdf`, `copperhead check` reports `ERC ✓ / drift ✓ / constraints ✓`. DRC still skipped — no `.kicad_pcb` yet.

This is the first artifact in the project that verification can actually act on. Everything before it was documents only.

## 2026-07-30 — Architecture baseline from scratch

- Scope set to **fully integrated inverter** (control + gate drive + DC link + precharge + power stage on one assembly).
- MCU set to **STM32F405VGT6, LQFP100**. All four rotor position interfaces required.
- Rewrote `SPEC.md` as the architecture baseline: ratings, DC vs phase current derivation, power stage, gate drive, DC link, precharge/discharge, sensing, protection, isolation, auxiliary power, thermal, MCU/VESC compatibility.
- Created `docs/DECISIONS.md` (D001–D010) and reset `.copperhead/constraints.json` from the new spec.
- Verification: none. No schematic exists yet; ERC and DRC cannot run.

## 2026-07-30 — Removed autonomous-run documents

Deleted `SPEC.md`, `BOM.md`, `PINOUT.md`, `openspec/changes/*` and the previous `docs/DECISIONS.md` / `docs/CHANGELOG.md` produced by autonomous copperhead runs.

Reason: fabricated part numbers (including a non-existent MOSFET as the central BOM item), a pinout with 96 invented power pins and universal GPIO collisions, and component selections that would destroy hardware on power-up (a 35 V-max regulator on a 48–450 V bus, a 45 V TVS across the bus, a 60 V gate driver at 450 V). No verification ran on any of it because no schematic existed, so the ERC/DRC gate was inert and the proposals self-approved.

No BOM has been recreated. Component selection follows architecture, not the other way round.
