aratzps/MCU-C/mcuc_inverter/phaseA_exports/placement_overview.pdf

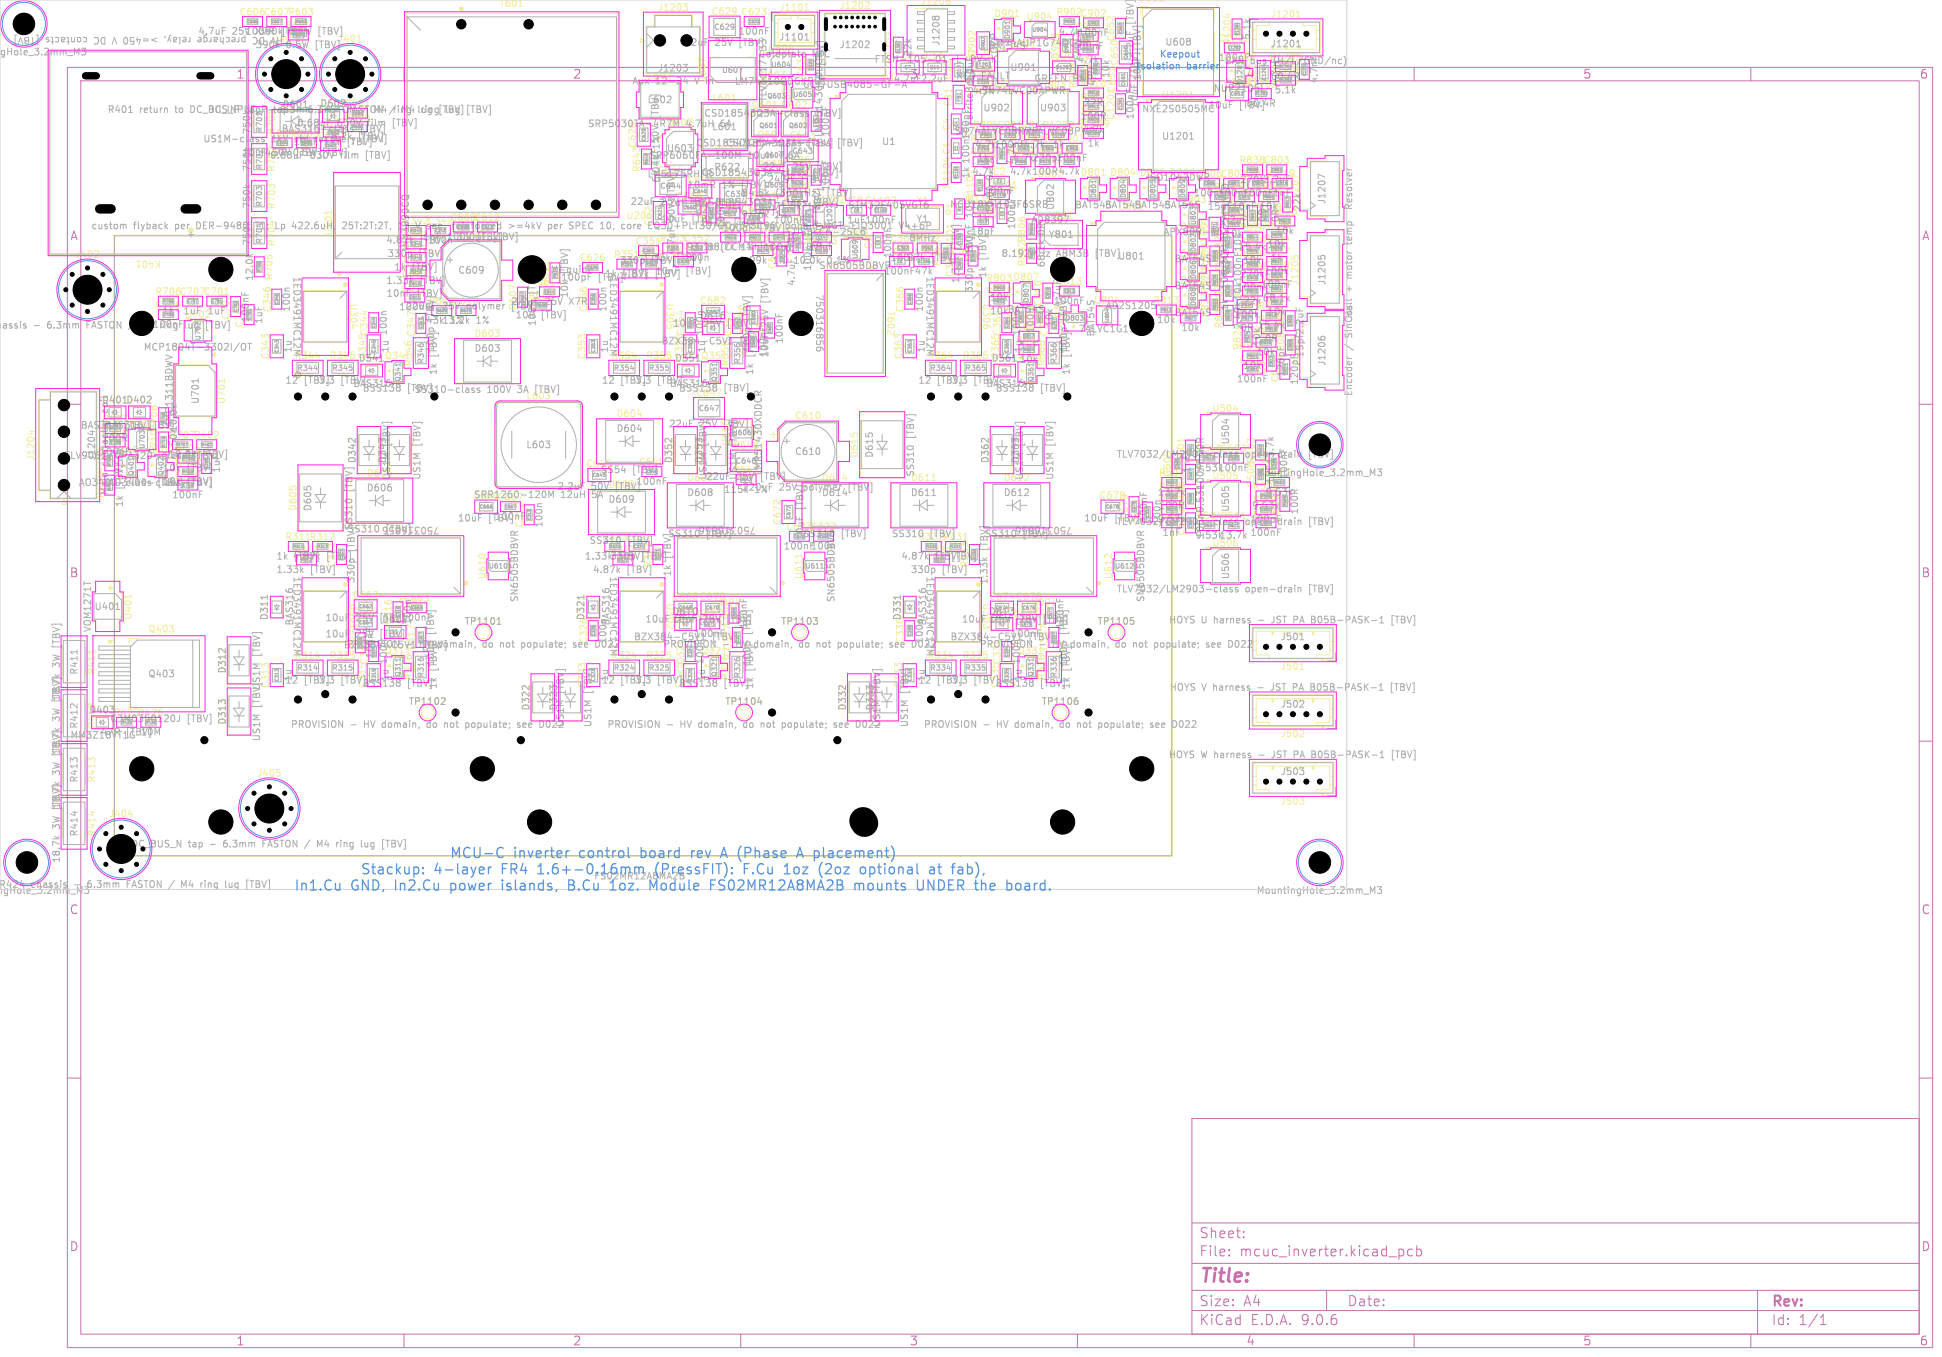
[picture p3: page 1]

to R401 chassis - 6.3mm FASTON / M4 ring lug [TBV] J402
