aratzps/MCU-C/mcuc_dclink/exports/mcuc_dclink_pcb.pdf

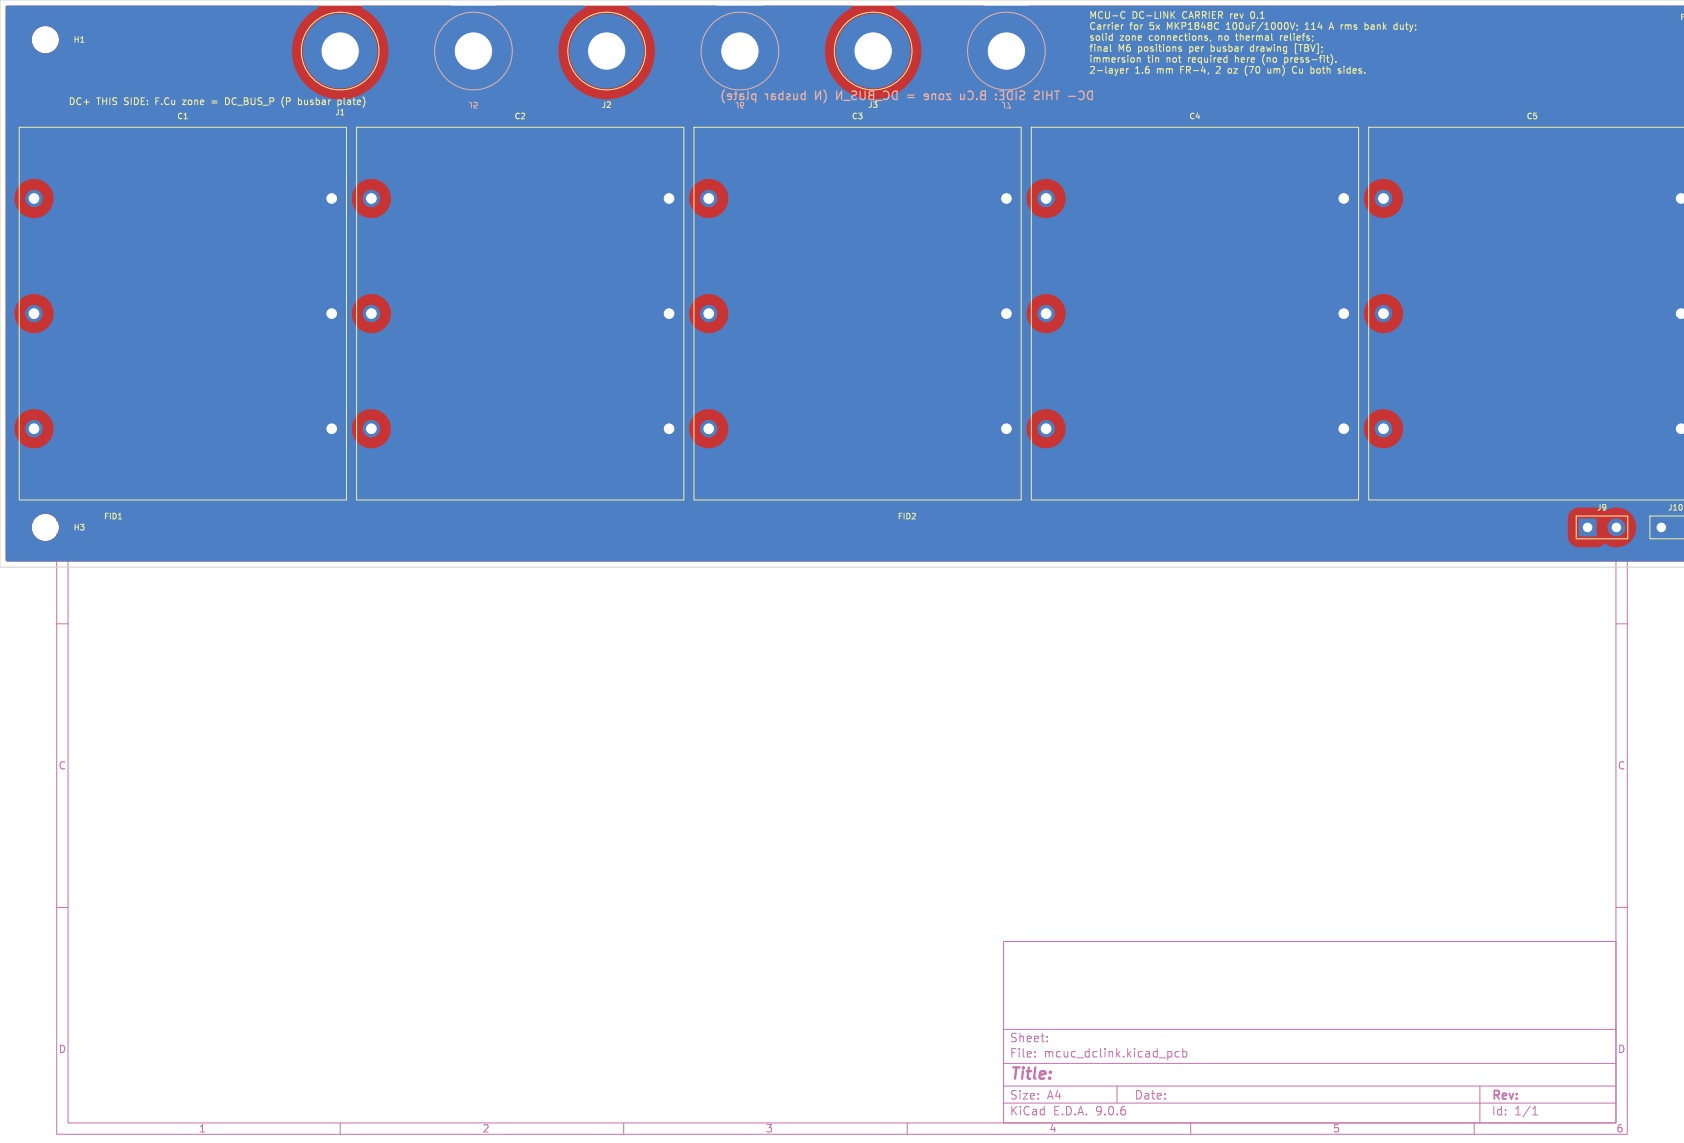
[picture p4: page 1]

Id: 1/1 Title: File: mcuc_dclink.kicad_pcb Sheet:
