aratzps/MCU-C/mcuc_dclink/exports/mcuc_dclink_sch.pdf

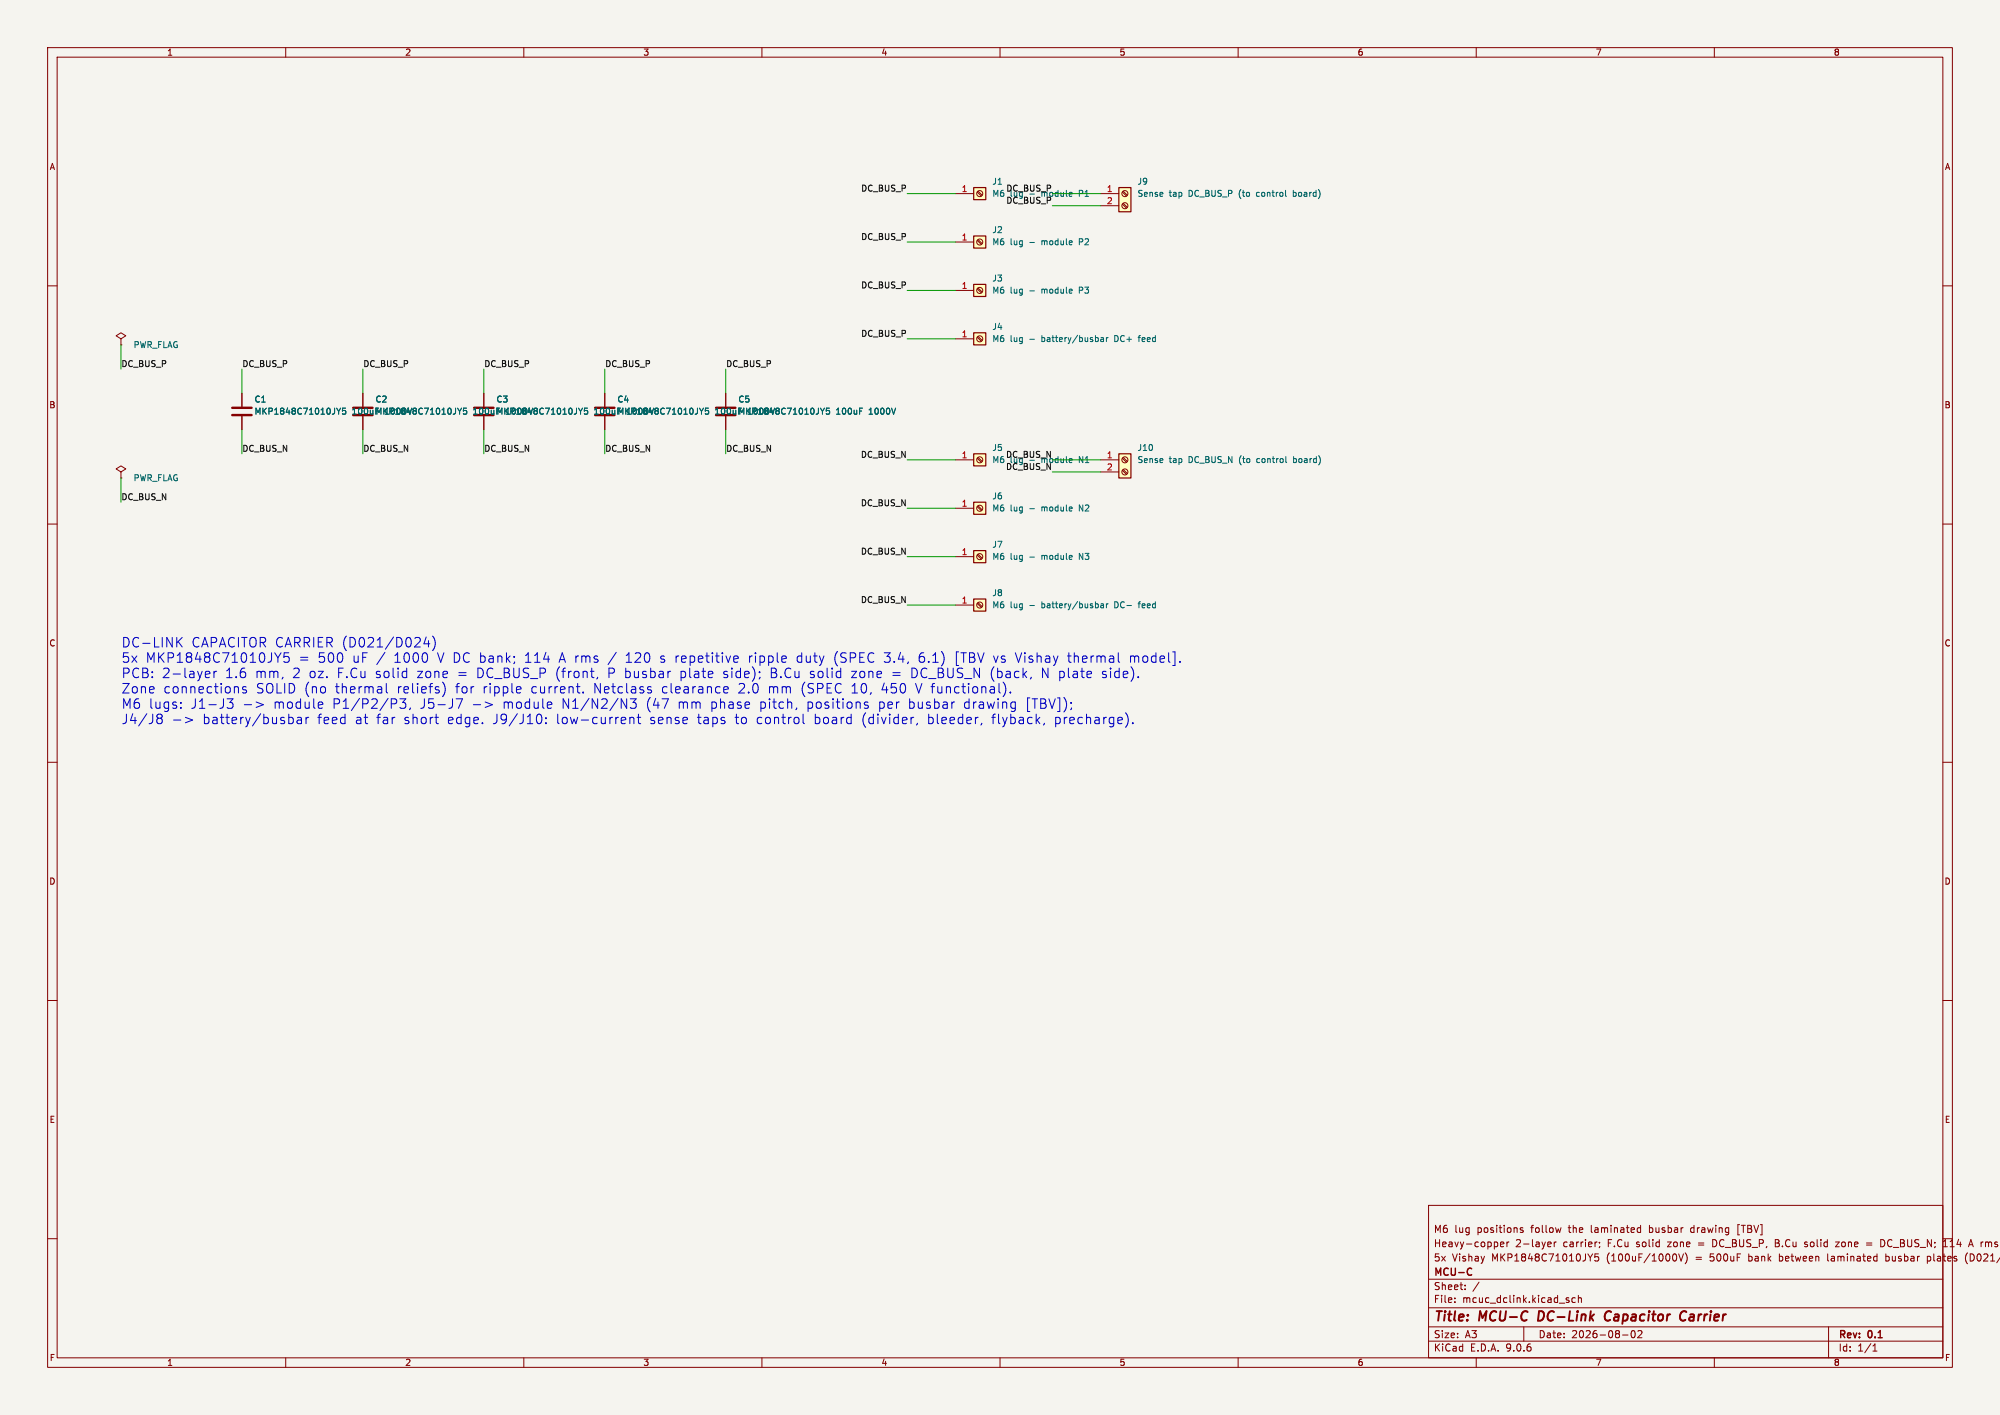
[picture p5: page 1]

DC_BUS_N DC-LINK CAPACITOR CARRIER (D021/D024)

Id: 1/1 Title: MCU-C DC-Link Capacitor Carrier File: mcuc_dclink.kicad_sch Sheet: / MCU-C
