aratzps/MCU-C/mcuc_inverter/mcuc_inverter.kicad_pcb

## KiCad design mcuc_inverter/mcuc_inverter.kicad_pcb (2026-08-14)

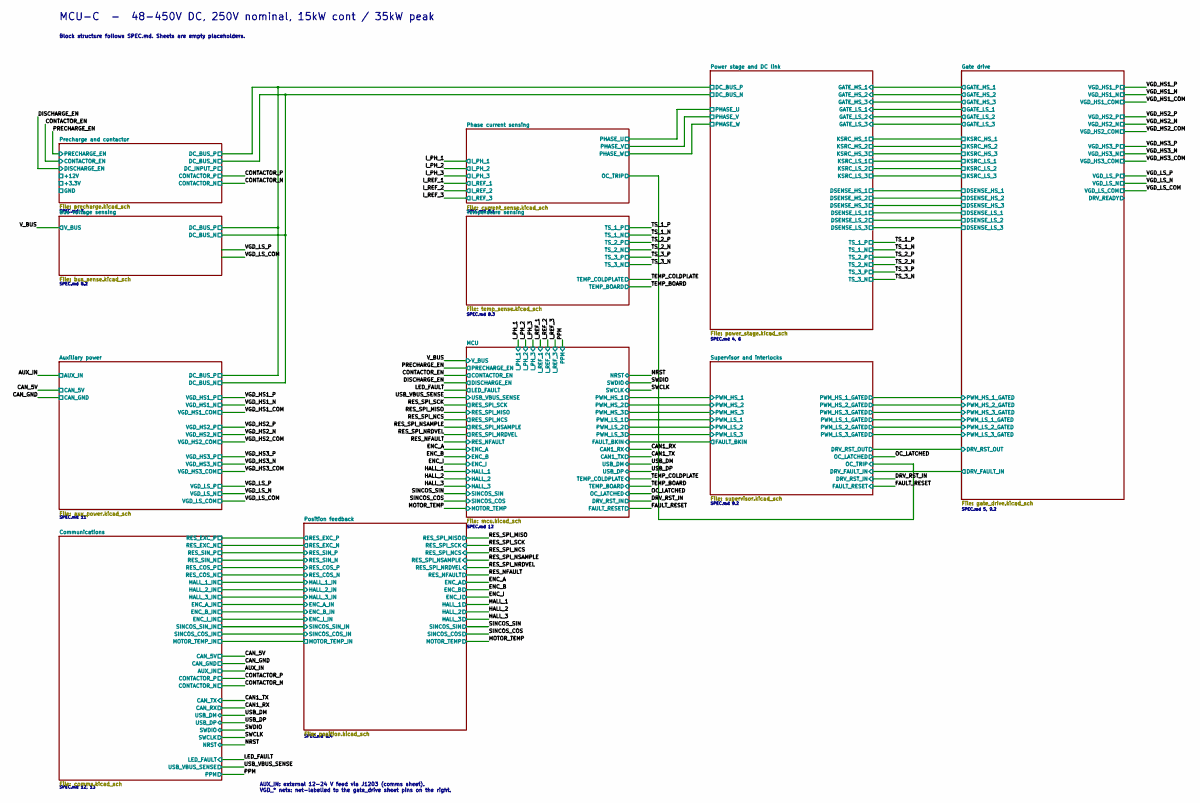
[picture p6: schematic mcuc_inverter.kicad_sch, MCU-C Integrated Inverter]

Notes on the sheet:
MCU-C - 48-450V DC, 250V nominal, 15kW cont / 35kW peak
Block structure follows SPEC.md. Sheets are empty placeholders.
SPEC.md 4, 6
SPEC.md 5, 9.2
SPEC.md 7
SPEC.md 8.1
SPEC.md 8.2
SPEC.md 8.3
SPEC.md 8.4
SPEC.md 9.2
SPEC.md 11
SPEC.md 12
SPEC.md 12, 13
AUX_IN: external 12-24 V feed via J1203 (comms sheet). VGD_* nets: net-labelled to the gate_drive sheet pins on the right.

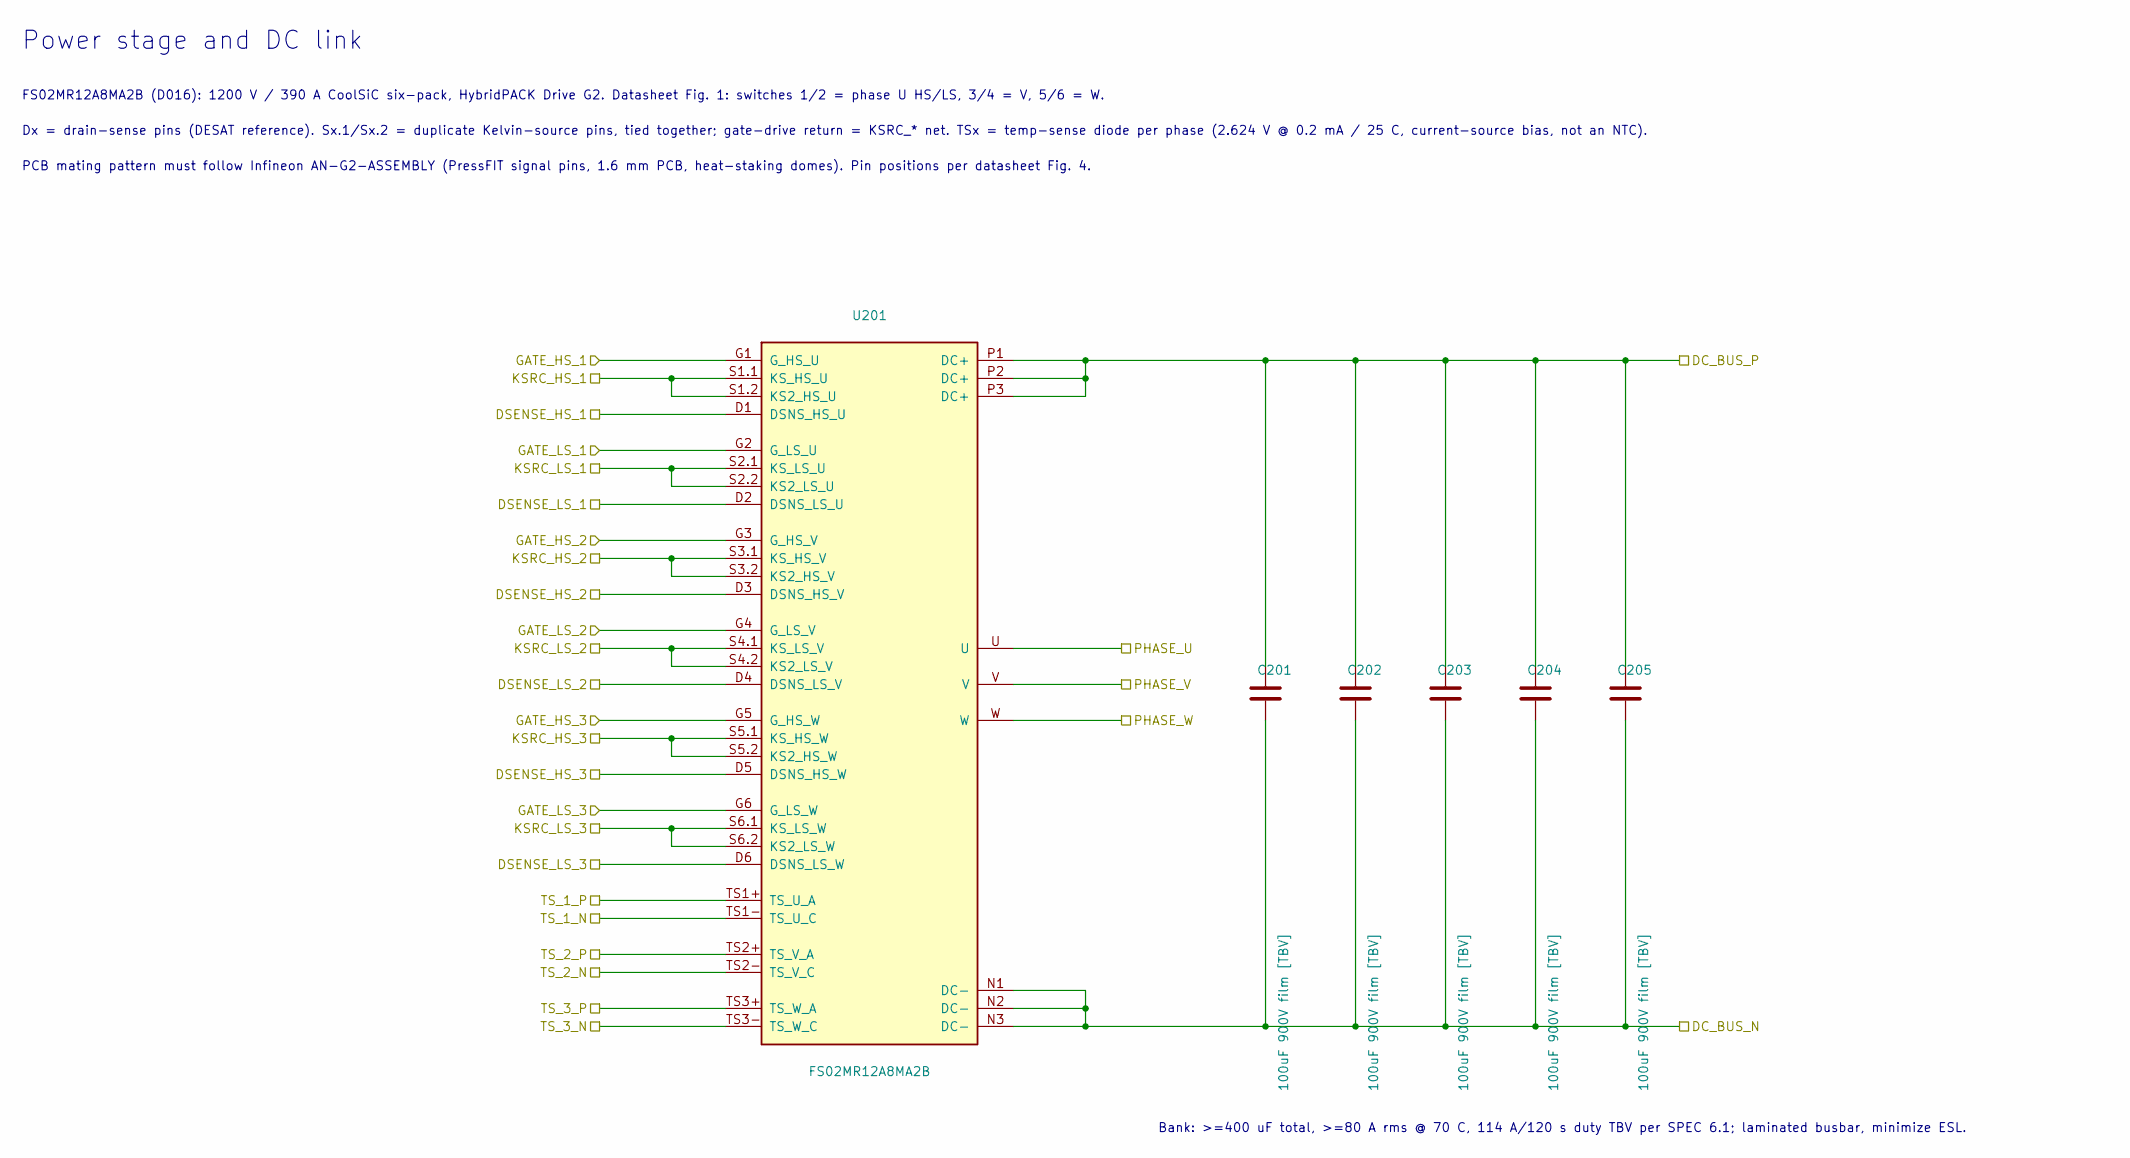
[picture p7: schematic power_stage.kicad_sch, MCU-C Integrated Inverter]

Parts:
C201, C202, C203, C204, C205: 100uF 900V film [TBV]; MKP1848C_6pin_52.5x20.3
U201: FS02MR12A8MA2B; FS02MR12A8MA2B_PressFIT

Connections:
/Gate drive/DSENSE_HS_1: U201.D1 (DSNS_HS_U); also elsewhere on the board
/Gate drive/DSENSE_HS_2: U201.D3 (DSNS_HS_V); also elsewhere on the board
/Gate drive/DSENSE_HS_3: U201.D5 (DSNS_HS_W); also elsewhere on the board
/Gate drive/DSENSE_LS_1: U201.D2 (DSNS_LS_U); also elsewhere on the board
/Gate drive/DSENSE_LS_2: U201.D4 (DSNS_LS_V); also elsewhere on the board
/Gate drive/DSENSE_LS_3: U201.D6 (DSNS_LS_W); also elsewhere on the board
/Gate drive/GATE_HS_1: U201.G1 (G_HS_U); also elsewhere on the board
/Gate drive/GATE_HS_2: U201.G3 (G_HS_V); also elsewhere on the board
/Gate drive/GATE_HS_3: U201.G5 (G_HS_W); also elsewhere on the board
/Gate drive/GATE_LS_1: U201.G2 (G_LS_U); also elsewhere on the board
/Gate drive/GATE_LS_2: U201.G4 (G_LS_V); also elsewhere on the board
/Gate drive/GATE_LS_3: U201.G6 (G_LS_W); also elsewhere on the board
/TS_1_N: U201.TS1- (TS_U_C); also elsewhere on the board
/TS_1_P: U201.TS1+ (TS_U_A); also elsewhere on the board
/TS_2_N: U201.TS2- (TS_V_C); also elsewhere on the board
/TS_2_P: U201.TS2+ (TS_V_A); also elsewhere on the board
/TS_3_N: U201.TS3- (TS_W_C); also elsewhere on the board
/TS_3_P: U201.TS3+ (TS_W_A); also elsewhere on the board
/VGD_HS1_COM: U201.S1.1 (KS_HS_U), U201.S1.2 (KS2_HS_U); also elsewhere on the board
/VGD_HS2_COM: U201.S3.1 (KS_HS_V), U201.S3.2 (KS2_HS_V); also elsewhere on the board
/VGD_HS3_COM: U201.S5.1 (KS_HS_W), U201.S5.2 (KS2_HS_W); also elsewhere on the board
/VGD_LS_COM: U201.S2.1 (KS_LS_U), U201.S2.2 (KS2_LS_U), U201.S4.1 (KS_LS_V), U201.S4.2 (KS2_LS_V), U201.S6.1 (KS_LS_W), U201.S6.2 (KS2_LS_W); also elsewhere on the board
unnamed: C201.1, C202.1, C203.1, C204.1, C205.1, U201.P1 (DC+), U201.P2 (DC+), U201.P3 (DC+)
unnamed: C201.2, C202.2, C203.2, C204.2, C205.2, U201.N1 (DC-), U201.N2 (DC-), U201.N3 (DC-)

Notes on the sheet:
Power stage and DC link
FS02MR12A8MA2B (D016): 1200 V / 390 A CoolSiC six-pack, HybridPACK Drive G2. Datasheet Fig. 1: switches 1/2 = phase U HS/LS, 3/4 = V, 5/6 = W.
Dx = drain-sense pins (DESAT reference). Sx.1/Sx.2 = duplicate Kelvin-source pins, tied together; gate-drive return = KSRC_* net. TSx = temp-sense diode per phase (2.624 V @ 0.2 mA / 25 C, current-source bias, not an NTC).
PCB mating pattern must follow Infineon AN-G2-ASSEMBLY (PressFIT signal pins, 1.6 mm PCB, heat-staking domes). Pin positions per datasheet Fig. 4.
Bank: >=400 uF total, >=80 A rms @ 70 C, 114 A/120 s duty TBV per SPEC 6.1; laminated busbar, minimize ESL.

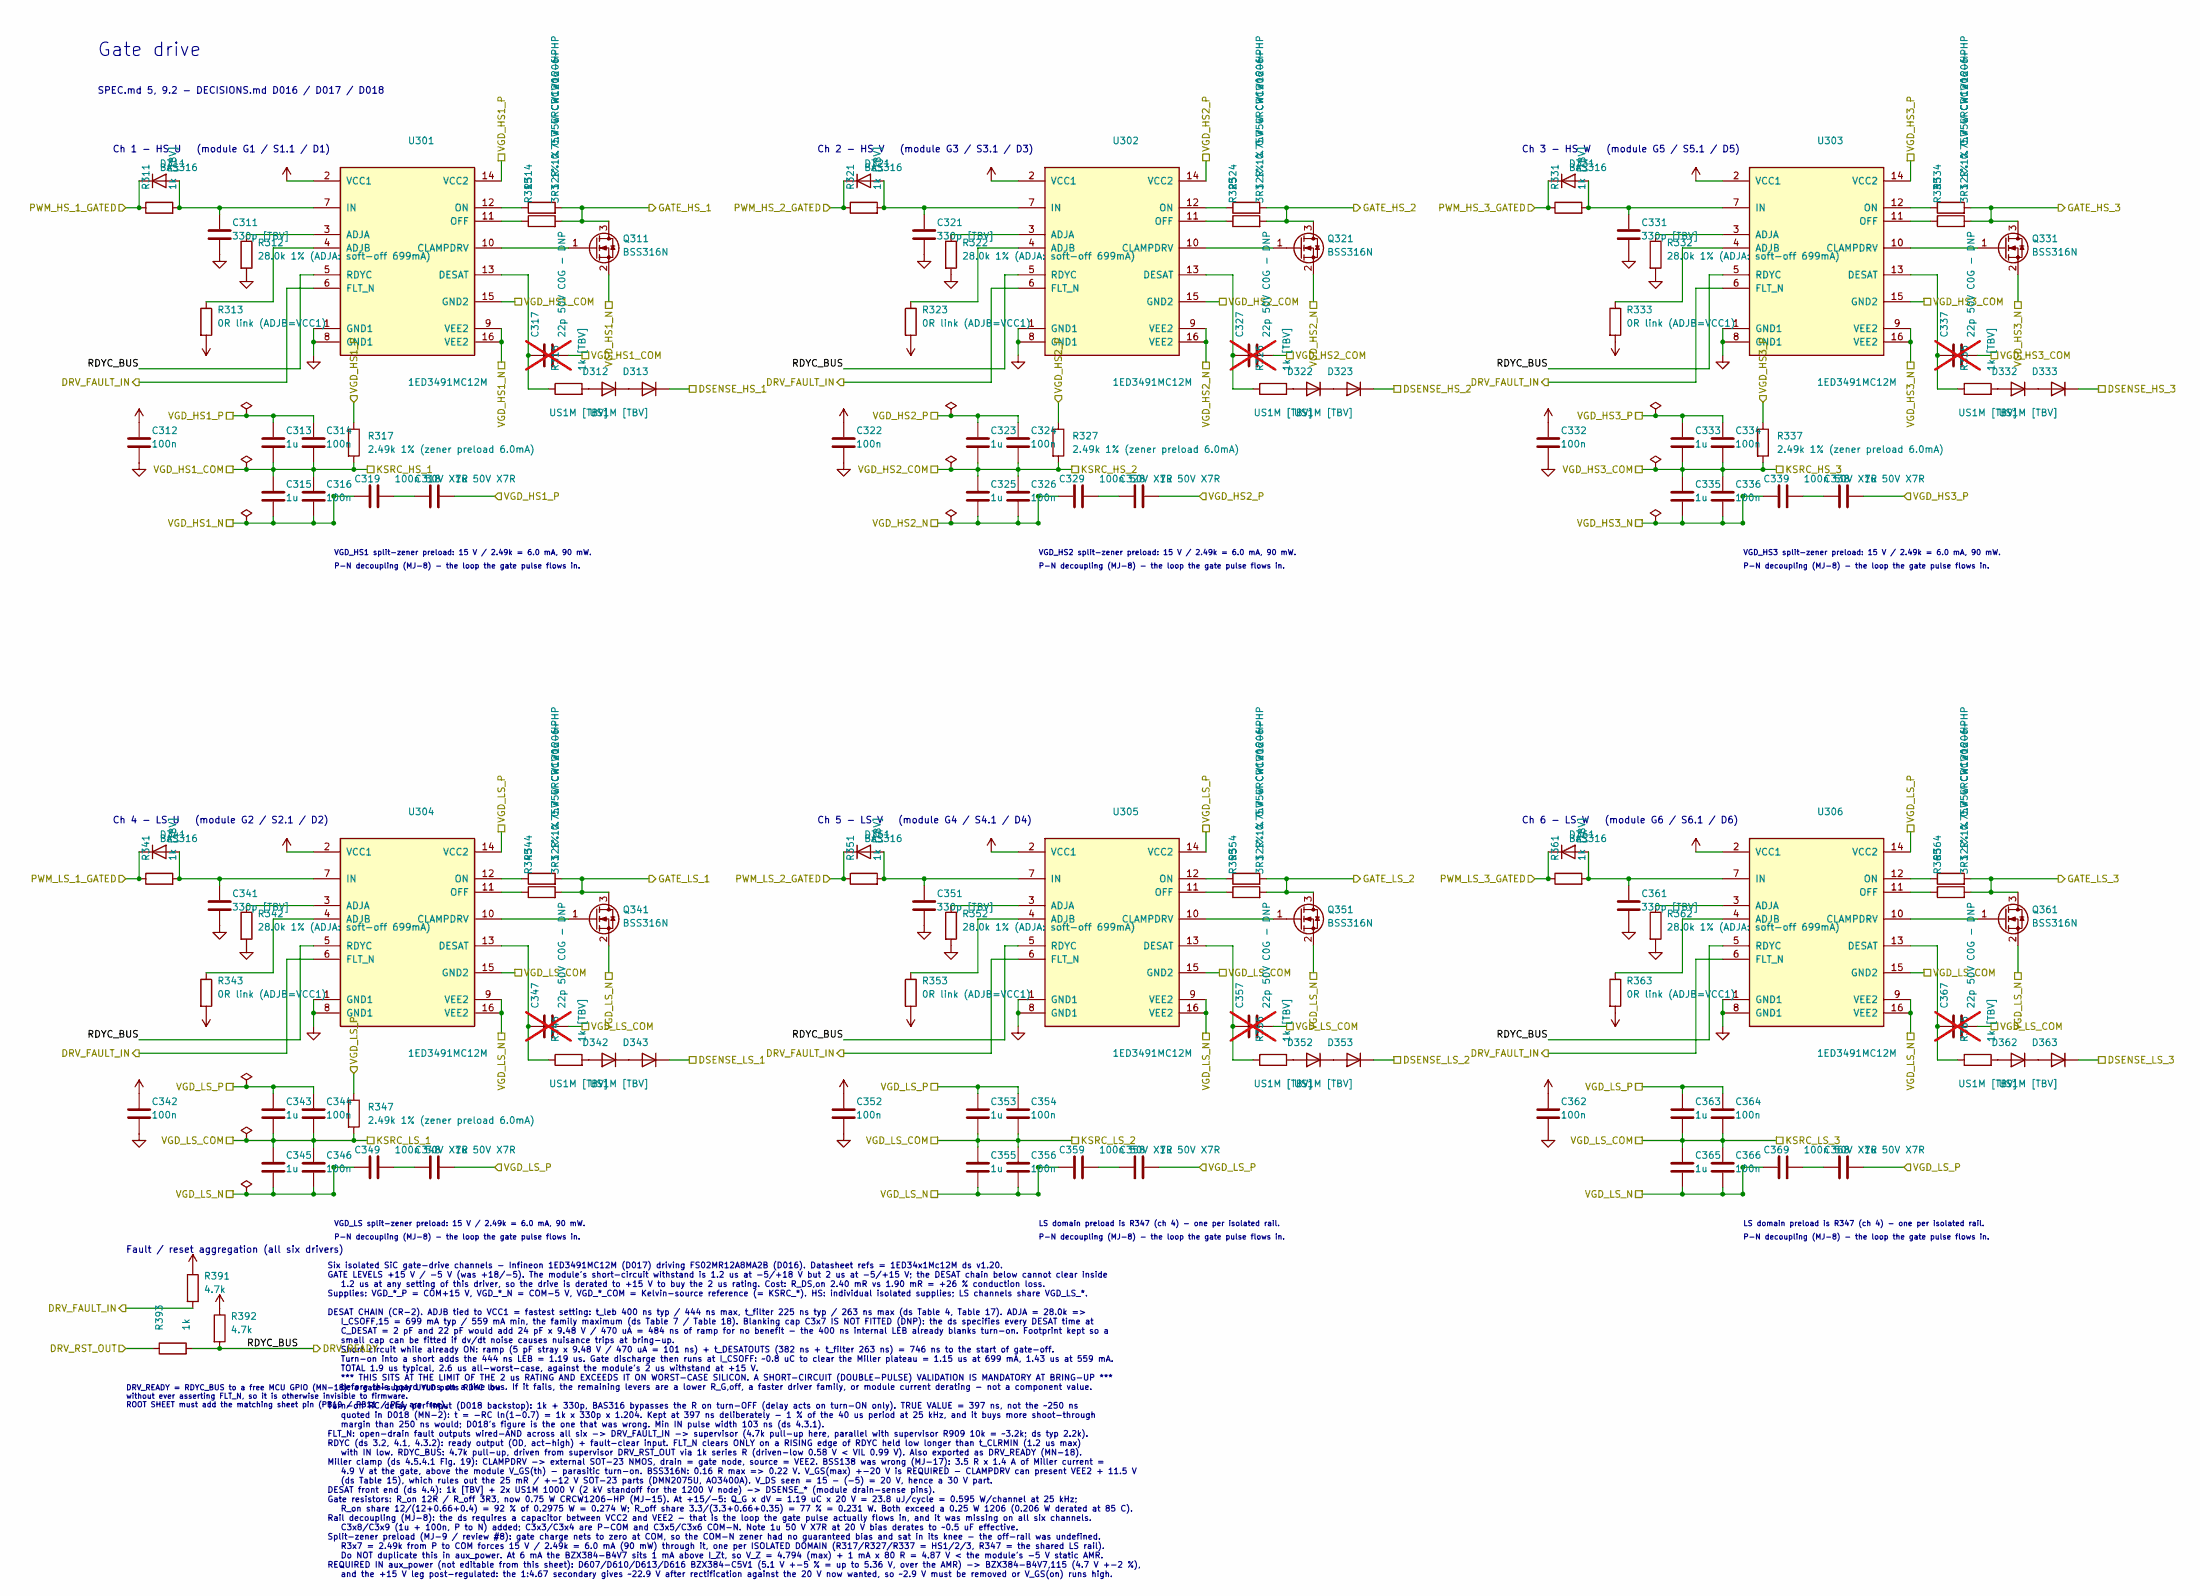
[picture p8: schematic gate_drive.kicad_sch, MCU-C Integrated Inverter]

Parts:
C311, C321, C331, C341, C351, C361: 330p [TBV]; C_0603_1608Metric
C312, C314, C316, C322, C324, C326, C332, C334, C336, C342, C344, C346, C352, C354, C356, C362, C364, C366: 100n; C_0603_1608Metric
C313, C315, C323, C325, C333, C335, C343, C345, C353, C355, C363, C365: 1u; C_0805_2012Metric
C317, C327, C337, C347, C357, C367: 22p 50V C0G - DNP; C_0603_1608Metric; not fitted
C318, C328, C338, C348, C358, C368: 1u 50V X7R; C_0805_2012Metric
C319, C329, C339, C349, C359, C369: 100n 50V X7R; C_0603_1608Metric
D311, D321, D331, D341, D351, D361: BAS316; D_SOD-323
D312, D313, D322, D323, D332, D333, D342, D343, D352, D353, D362, D363: US1M [TBV]; D_SMA
Q311, Q321, Q331, Q341, Q351, Q361: BSS316N; SOT-23
R311, R321, R331, R341, R351, R361: 1k [TBV]; R_0603_1608Metric
R312, R322, R332, R342, R352, R362: 28.0k 1% (ADJA: soft-off 699mA); R_0603_1608Metric
R313, R323, R333, R343, R353, R363: 0R link (ADJB=VCC1); R_0603_1608Metric
R314, R324, R334, R344, R354, R364: 12R 1% 0.75W CRCW1206-HP; R_1206_3216Metric
R315, R325, R335, R345, R355, R365: 3R3 1% 0.75W CRCW1206-HP; R_1206_3216Metric
R316, R326, R336, R346, R356, R366: 1k [TBV]; R_1206_3216Metric
R317, R327, R337, R347: 2.49k 1% (zener preload 6.0mA); R_1206_3216Metric
R391, R392: 4.7k; R_0603_1608Metric
R393: 1k; R_0603_1608Metric
U301, U302, U303, U304, U305, U306: 1ED3491MC12M; PG-DSO-16-28

Connections:
+3.3V: C312.1, C322.1, C332.1, C342.1, C352.1, C362.1, R313.2, R323.2, R333.2, R343.2, R353.2, R363.2, R391.1, R392.1, U301.2 (VCC1), U302.2 (VCC1), U303.2 (VCC1), U304.2 (VCC1), U305.2 (VCC1), U306.2 (VCC1); also elsewhere on the board
/Gate drive/DRV_RST_OUT: R393.1; also elsewhere on the board
/Gate drive/DSENSE_HS_1: D313.1 (K); also elsewhere on the board
/Gate drive/DSENSE_HS_2: D323.1 (K); also elsewhere on the board
/Gate drive/DSENSE_HS_3: D333.1 (K); also elsewhere on the board
/Gate drive/DSENSE_LS_1: D343.1 (K); also elsewhere on the board
/Gate drive/DSENSE_LS_2: D353.1 (K); also elsewhere on the board
/Gate drive/DSENSE_LS_3: D363.1 (K); also elsewhere on the board
/Gate drive/GATE_HS_1: Q311.3 (D), R314.2, R315.2; also elsewhere on the board
/Gate drive/GATE_HS_2: Q321.3 (D), R324.2, R325.2; also elsewhere on the board
/Gate drive/GATE_HS_3: Q331.3 (D), R334.2, R335.2; also elsewhere on the board
/Gate drive/GATE_LS_1: Q341.3 (D), R344.2, R345.2; also elsewhere on the board
/Gate drive/GATE_LS_2: Q351.3 (D), R354.2, R355.2; also elsewhere on the board
/Gate drive/GATE_LS_3: Q361.3 (D), R364.2, R365.2; also elsewhere on the board
/Gate drive/PWM_HS_1_GATED: D311.1 (K), R311.1; also elsewhere on the board
/Gate drive/PWM_HS_2_GATED: D321.1 (K), R321.1; also elsewhere on the board
/Gate drive/PWM_HS_3_GATED: D331.1 (K), R331.1; also elsewhere on the board
/Gate drive/PWM_LS_1_GATED: D341.1 (K), R341.1; also elsewhere on the board
/Gate drive/PWM_LS_2_GATED: D351.1 (K), R351.1; also elsewhere on the board
/Gate drive/PWM_LS_3_GATED: D361.1 (K), R361.1; also elsewhere on the board
/Gate drive/RDYC_BUS: R392.2, R393.2, U301.5 (RDYC), U302.5 (RDYC), U303.5 (RDYC), U304.5 (RDYC), U305.5 (RDYC), U306.5 (RDYC)
/Supervisor and interlocks/DRV_FAULT_IN: R391.2, U301.6 (FLT_N), U302.6 (FLT_N), U303.6 (FLT_N), U304.6 (FLT_N), U305.6 (FLT_N), U306.6 (FLT_N); also elsewhere on the board
/VGD_HS1_COM: C313.2, C314.2, C315.1, C316.1, C317.2, R317.2, U301.15 (GND2); also elsewhere on the board
/VGD_HS1_N: C315.2, C316.2, C319.1, Q311.2 (S), U301.9 (VEE2), U301.16 (VEE2); also elsewhere on the board
/VGD_HS1_P: C313.1, C314.1, C318.2, R317.1, U301.14 (VCC2); also elsewhere on the board
/VGD_HS2_COM: C323.2, C324.2, C325.1, C326.1, C327.2, R327.2, U302.15 (GND2); also elsewhere on the board
/VGD_HS2_N: C325.2, C326.2, C329.1, Q321.2 (S), U302.9 (VEE2), U302.16 (VEE2); also elsewhere on the board
/VGD_HS2_P: C323.1, C324.1, C328.2, R327.1, U302.14 (VCC2); also elsewhere on the board
/VGD_HS3_COM: C333.2, C334.2, C335.1, C336.1, C337.2, R337.2, U303.15 (GND2); also elsewhere on the board
/VGD_HS3_N: C335.2, C336.2, C339.1, Q331.2 (S), U303.9 (VEE2), U303.16 (VEE2); also elsewhere on the board
/VGD_HS3_P: C333.1, C334.1, C338.2, R337.1, U303.14 (VCC2); also elsewhere on the board
/VGD_LS_COM: C343.2, C344.2, C345.1, C346.1, C347.2, C353.2, C354.2, C355.1, C356.1, C357.2, C363.2, C364.2, C365.1, C366.1, C367.2, R347.2, U304.15 (GND2), U305.15 (GND2), U306.15 (GND2); also elsewhere on the board
/VGD_LS_N: C345.2, C346.2, C349.1, C355.2, C356.2, C359.1, C365.2, C366.2, C369.1, Q341.2 (S), Q351.2 (S), Q361.2 (S), U304.9 (VEE2), U304.16 (VEE2), U305.9 (VEE2), U305.16 (VEE2), U306.9 (VEE2), U306.16 (VEE2); also elsewhere on the board
/VGD_LS_P: C343.1, C344.1, C348.2, C353.1, C354.1, C358.2, C363.1, C364.1, C368.2, R347.1, U304.14 (VCC2), U305.14 (VCC2), U306.14 (VCC2); also elsewhere on the board
GND: C311.2, C312.2, C321.2, C322.2, C331.2, C332.2, C341.2, C342.2, C351.2, C352.2, C361.2, C362.2, R312.2, R322.2, R332.2, R342.2, R352.2, R362.2, U301.1 (GND1), U301.8 (GND1), U302.1 (GND1), U302.8 (GND1), U303.1 (GND1), U303.8 (GND1), U304.1 (GND1), U304.8 (GND1), U305.1 (GND1), U305.8 (GND1), U306.1 (GND1), U306.8 (GND1); also elsewhere on the board
unnamed: C318.1, C319.2
unnamed: C328.1, C329.2
unnamed: C338.1, C339.2
unnamed: C348.1, C349.2
unnamed: C358.1, C359.2
unnamed: C368.1, C369.2
unnamed: C311.1, D311.2 (A), R311.2, U301.7 (IN)
unnamed: D312.2 (A), R316.2
unnamed: D312.1 (K), D313.2 (A)
unnamed: C321.1, D321.2 (A), R321.2, U302.7 (IN)
unnamed: D322.2 (A), R326.2
unnamed: D322.1 (K), D323.2 (A)
unnamed: C331.1, D331.2 (A), R331.2, U303.7 (IN)
unnamed: D332.2 (A), R336.2
unnamed: D332.1 (K), D333.2 (A)
unnamed: C341.1, D341.2 (A), R341.2, U304.7 (IN)
unnamed: D342.2 (A), R346.2
unnamed: D342.1 (K), D343.2 (A)
unnamed: C351.1, D351.2 (A), R351.2, U305.7 (IN)
unnamed: D352.2 (A), R356.2
unnamed: D352.1 (K), D353.2 (A)
unnamed: C361.1, D361.2 (A), R361.2, U306.7 (IN)
unnamed: D362.2 (A), R366.2
unnamed: D362.1 (K), D363.2 (A)
unnamed: Q311.1 (G), U301.10 (CLAMPDRV)
unnamed: Q321.1 (G), U302.10 (CLAMPDRV)
unnamed: Q331.1 (G), U303.10 (CLAMPDRV)
unnamed: Q341.1 (G), U304.10 (CLAMPDRV)
unnamed: Q351.1 (G), U305.10 (CLAMPDRV)
unnamed: Q361.1 (G), U306.10 (CLAMPDRV)
unnamed: R312.1, U301.3 (ADJA)
unnamed: R313.1, U301.4 (ADJB)
unnamed: C317.1, R316.1, U301.13 (DESAT)
unnamed: R315.1, U301.11 (OFF)
unnamed: R314.1, U301.12 (ON)
unnamed: R322.1, U302.3 (ADJA)
unnamed: R323.1, U302.4 (ADJB)
unnamed: C327.1, R326.1, U302.13 (DESAT)
unnamed: R325.1, U302.11 (OFF)
unnamed: R324.1, U302.12 (ON)
unnamed: R332.1, U303.3 (ADJA)
unnamed: R333.1, U303.4 (ADJB)
unnamed: C337.1, R336.1, U303.13 (DESAT)
unnamed: R335.1, U303.11 (OFF)
unnamed: R334.1, U303.12 (ON)
unnamed: R342.1, U304.3 (ADJA)
unnamed: R343.1, U304.4 (ADJB)
unnamed: C347.1, R346.1, U304.13 (DESAT)
unnamed: R345.1, U304.11 (OFF)
unnamed: R344.1, U304.12 (ON)
unnamed: R352.1, U305.3 (ADJA)
unnamed: R353.1, U305.4 (ADJB)
unnamed: C357.1, R356.1, U305.13 (DESAT)
unnamed: R355.1, U305.11 (OFF)
unnamed: R354.1, U305.12 (ON)
unnamed: R362.1, U306.3 (ADJA)
unnamed: R363.1, U306.4 (ADJB)
unnamed: C367.1, R366.1, U306.13 (DESAT)
unnamed: R365.1, U306.11 (OFF)
unnamed: R364.1, U306.12 (ON)

Notes on the sheet:
Gate drive
SPEC.md 5, 9.2 - DECISIONS.md D016 / D017 / D018
Six isolated SiC gate-drive channels - Infineon 1ED3491MC12M (D017) driving FS02MR12A8MA2B (D016). Datasheet refs = 1ED34x1Mc12M ds v1.20. GATE LEVELS +15 V / -5 V (was +18/-5). The module's short-circuit withstand is 1.2 us at -5/+18 V but 2 us at -5/+15 V; the DESAT chain below cannot clear insid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
Ch 1 - HS U (module G1 / S1.1 / D1)
Ch 2 - HS V (module G3 / S3.1 / D3)
Ch 3 - HS W (module G5 / S5.1 / D5)
Ch 4 - LS U (module G2 / S2.1 / D2)
Ch 5 - LS V (module G4 / S4.1 / D4)
Ch 6 - LS W (module G6 / S6.1 / D6)
Fault / reset aggregation (all six drivers)
VGD_HS1 split-zener preload: 15 V / 2.49k = 6.0 mA, 90 mW.
P-N decoupling (MJ-8) - the loop the gate pulse flows in.
VGD_HS2 split-zener preload: 15 V / 2.49k = 6.0 mA, 90 mW.
VGD_HS3 split-zener preload: 15 V / 2.49k = 6.0 mA, 90 mW.
VGD_LS split-zener preload: 15 V / 2.49k = 6.0 mA, 90 mW.
LS domain preload is R347 (ch 4) - one per isolated rail.
DRV_READY = RDYC_BUS to a free MCU GPIO (MN-18): a gate-supply UVLO pulls RDYC low without ever asserting FLT_N, so it is otherwise invisible to firmware. ROOT SHEET must add the matching sheet pin (PB10 / PB11 / PE1 are free).

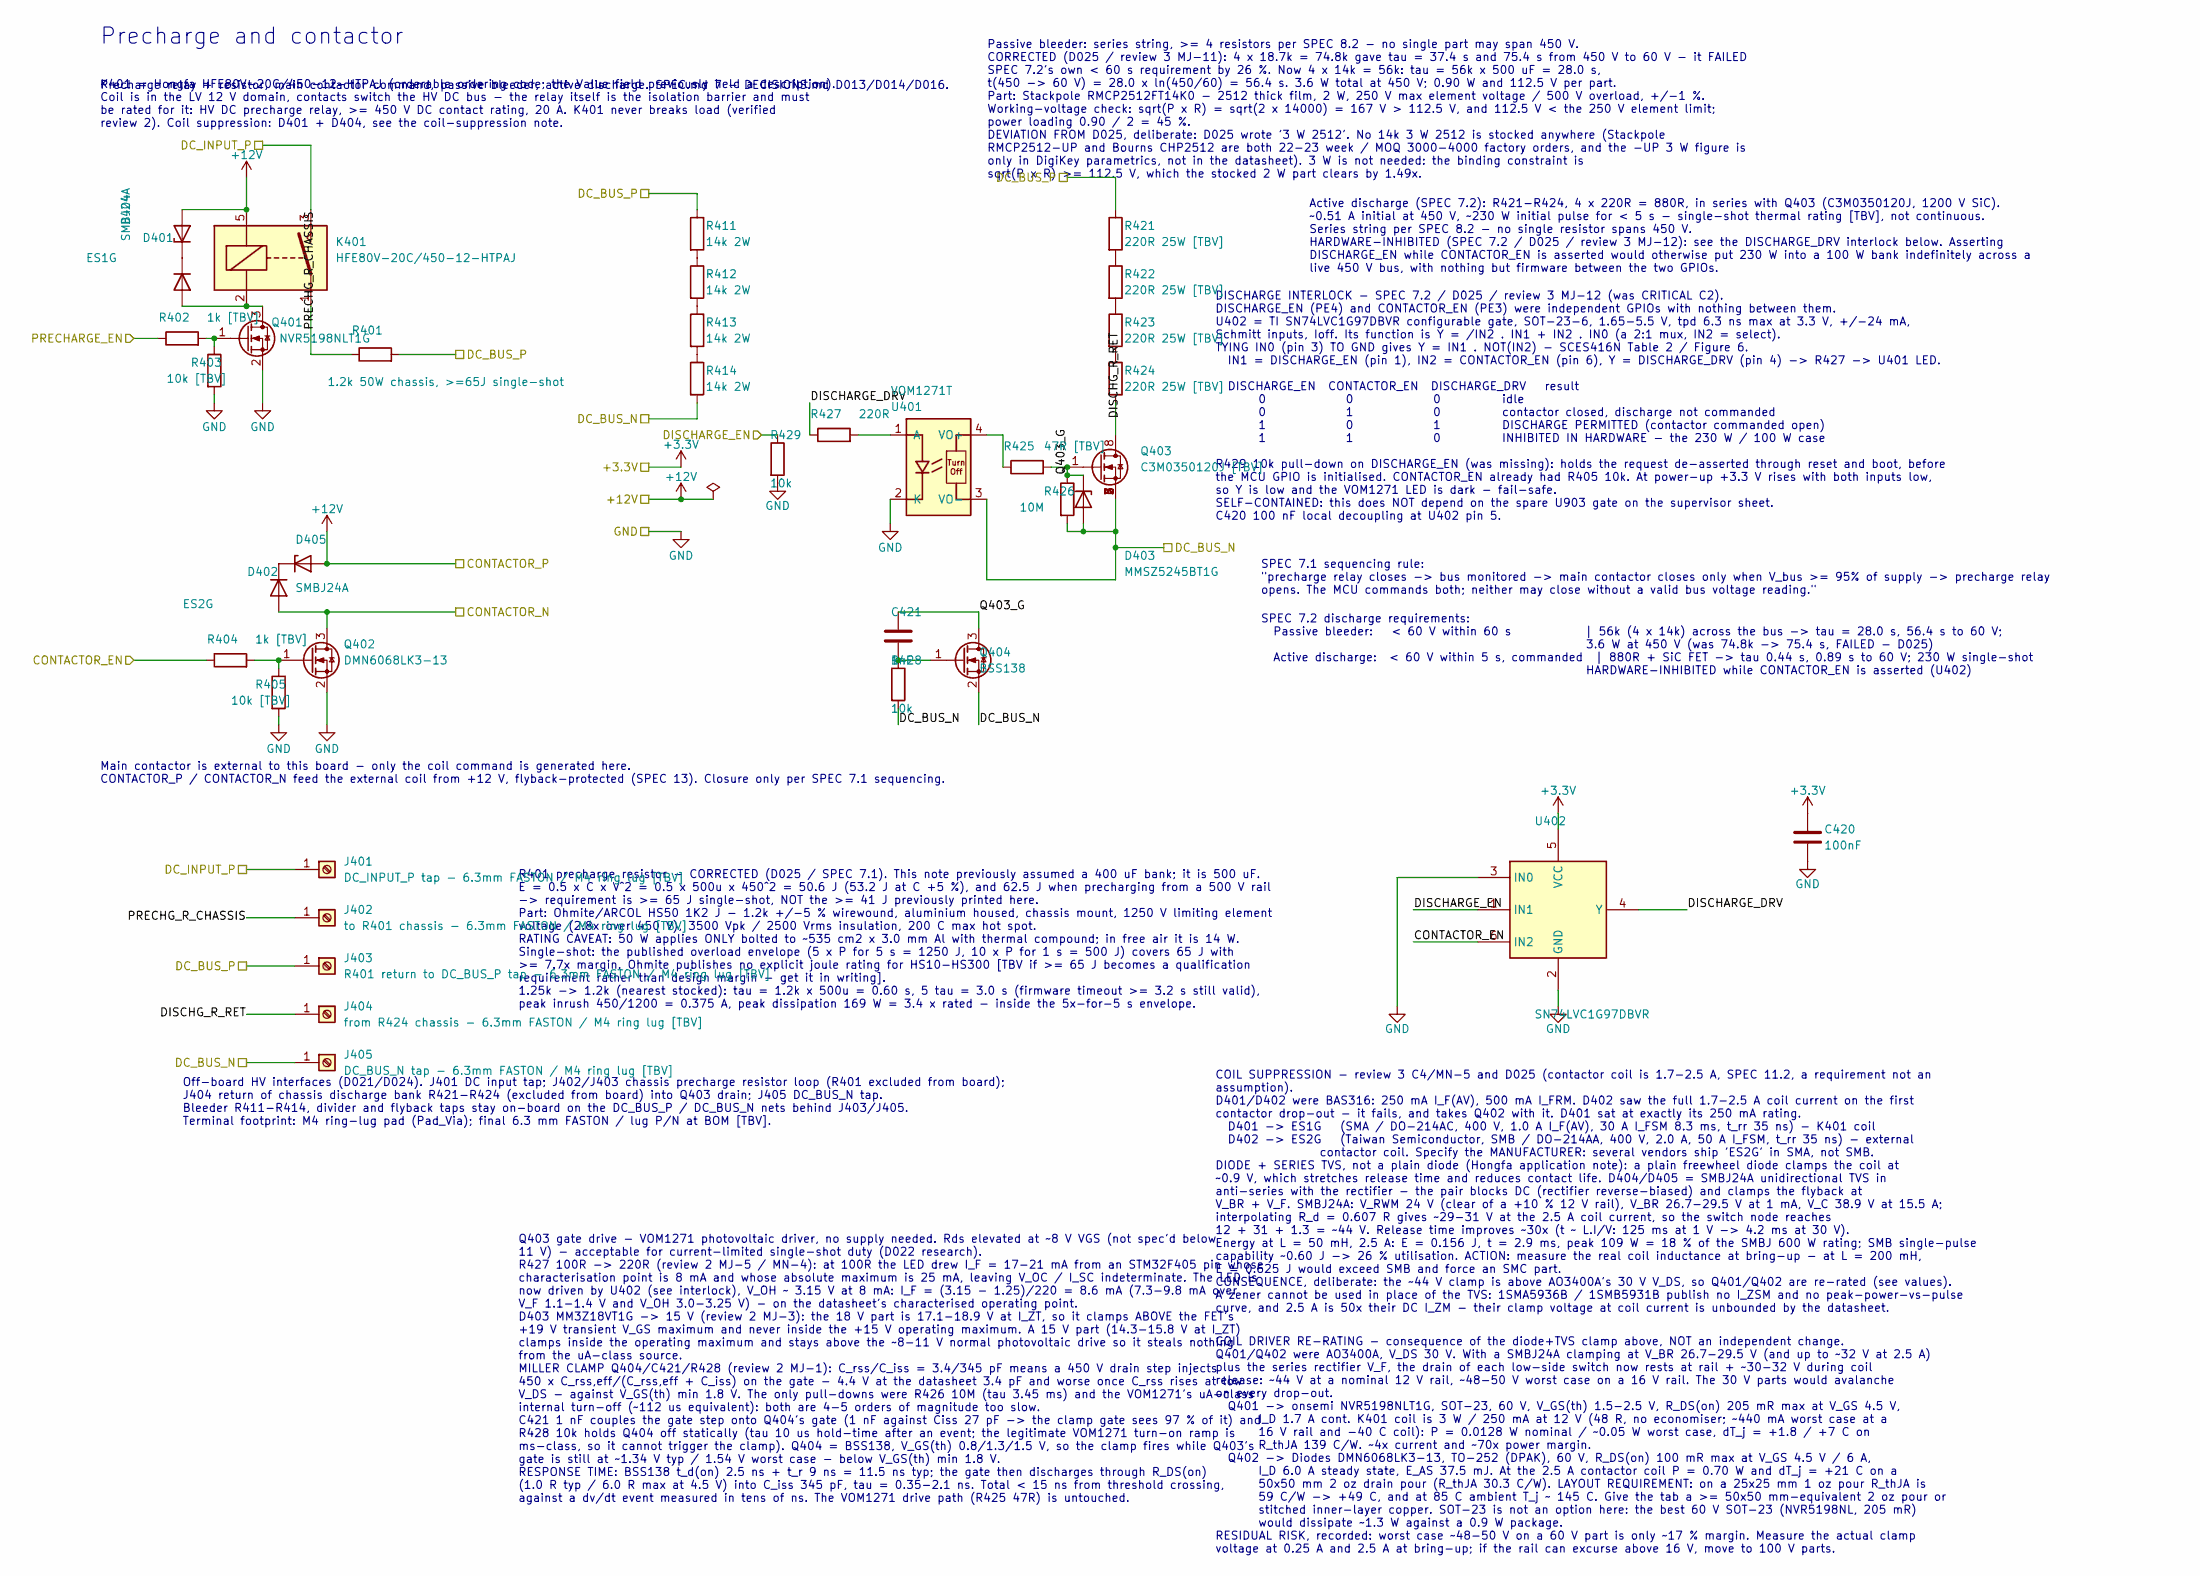
[picture p9: schematic precharge.kicad_sch, MCU-C Integrated Inverter]

Parts:
C420: 100nF; C_0603_1608Metric
C421: 1nF; C_0603_1608Metric
D401: ES1G; D_SMA
D402: ES2G; D_SMB
D403: MMSZ5245BT1G; D_SOD-123
D404, D405: SMBJ24A; D_SMB
J401: DC_INPUT_P tap - 6.3mm FASTON / M4 ring lug [TBV]; MountingHole_4.3mm_M4_Pad_Via
J402: to R401 chassis - 6.3mm FASTON / M4 ring lug [TBV]; MountingHole_4.3mm_M4_Pad_Via
J403: R401 return to DC_BUS_P tap - 6.3mm FASTON / M4 r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; MountingHole_4.3mm_M4_Pad_Via
J404: from R424 chassis - 6.3mm FASTON / M4 ring lug [T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; MountingHole_4.3mm_M4_Pad_Via
J405: DC_BUS_N tap - 6.3mm FASTON / M4 ring lug [TBV]; MountingHole_4.3mm_M4_Pad_Via
K401: HFE80V-20C/450-12-HTPAJ; HFE80V_HTPAJ
Q401: NVR5198NLT1G; SOT-23
Q402: DMN6068LK3-13; TO-252-3_TabPin2
Q403: C3M0350120J [TBV]; TO-263-7_TabPin8
Q404: BSS138; SOT-23
R401: 1.2k 50W chassis, >=65J single-shot
R402, R404: 1k [TBV]; R_0603_1608Metric
R403, R405: 10k [TBV]; R_0603_1608Metric
R411, R412, R413, R414: 14k 2W; R_2512_6332Metric
R421, R422, R423, R424: 220R 25W [TBV]
R425: 47R [TBV]; R_0603_1608Metric
R426: 10M; R_0603_1608Metric
R427: 220R; R_0603_1608Metric
R428, R429: 10k; R_0603_1608Metric
U401: VOM1271T; SOP-4_3.8x4.1mm_P2.54mm
U402: SN74LVC1G97DBVR; SOT-23-6

Connections:
+3.3V: C420.1, U402.5 (VCC); also elsewhere on the board
+12V: D404.2 (A), D405.2 (A), K401.5; also elsewhere on the board
/Auxiliary power/DC_BUS_P: J403.1, R401.2, R411.1, R421.1; also elsewhere on the board
/CONTACTOR_EN: R404.1, U402.6 (IN2); also elsewhere on the board
/CONTACTOR_N: D402.2 (A), Q402.3 (D); also elsewhere on the board
/DISCHARGE_EN: R429.1, U402.1 (IN1); also elsewhere on the board
/PRECHARGE_EN: R402.1; also elsewhere on the board
/Precharge and contactor/DC_BUS_N: D403.2 (A), J405.1, Q403.2 (S), Q403.3 (S), Q403.4 (S), Q403.5 (S), Q403.6 (S), Q403.7 (S), Q404.2 (S), R414.2, R426.2, R428.2, U401.3 (VO-); also elsewhere on the board
/Precharge and contactor/DC_INPUT_P: J401.1, K401.3
/Precharge and contactor/DISCHARGE_DRV: R427.1, U402.4 (Y)
/Precharge and contactor/DISCHG_R_RET: J404.1, Q403.8 (D), R424.2
/Precharge and contactor/PRECHG_R_CHASSIS: J402.1, K401.1, R401.1
/Precharge and contactor/Q403_G: C421.1, D403.1 (K), Q403.1 (G), Q404.3 (D), R425.2, R426.1
GND: C420.2, Q401.2 (S), Q402.2 (S), R403.2, R405.2, R429.2, U401.2 (K), U402.2 (GND), U402.3 (IN0); also elsewhere on the board
unnamed: D401.2 (A), K401.2, Q401.3 (D)
unnamed: D401.1 (K), D404.1 (K)
unnamed: D402.1 (K), D405.1 (K)
unnamed: Q401.1 (G), R402.2, R403.1
unnamed: Q402.1 (G), R404.2, R405.1
unnamed: C421.2, Q404.1 (G), R428.1
unnamed: R411.2, R412.1
unnamed: R412.2, R413.1
unnamed: R413.2, R414.1
unnamed: R421.2, R422.1
unnamed: R422.2, R423.1
unnamed: R423.2, R424.1
unnamed: R427.2, U401.1 (A)
unnamed: R425.1, U401.4 (VO+)

Notes on the sheet:
Precharge and contactor
Precharge relay + resistor, main contactor command, passive bleeder, active discharge. SPEC.md 7 - DECISIONS.md D013/D014/D016.
K401 = Hongfa HFE80V-20C/450-12-HTPAJ (orderable ordering code; the Value field previously held a description). Coil is in the LV 12 V domain, contacts switch the HV DC bus - the relay itself is the isolation barrier and must be rated for it: HV DC precharge relay, >= 450 V DC contact rating, 20 A.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
R401 precharge resistor - CORRECTED (D025 / SPEC 7.1). This note previously assumed a 400 uF bank; it is 500 uF. E = 0.5 x C x V^2 = 0.5 x 500u x 450^2 = 50.6 J (53.2 J at C +5 %), and 62.5 J when precharging from a 500 V rail -> requirement is >= 65 J single-shot, NOT the >= 41 J previously printe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
Main contactor is external to this board - only the coil command is generated here. CONTACTOR_P / CONTACTOR_N feed the external coil from +12 V, flyback-protected (SPEC 13). Closure only per SPEC 7.1 sequencing.
Passive bleeder: series string, >= 4 resistors per SPEC 8.2 - no single part may span 450 V. CORRECTED (D025 / review 3 MJ-11): 4 x 18.7k = 74.8k gave tau = 37.4 s and 75.4 s from 450 V to 60 V - it FAILED SPEC 7.2's own < 60 s requirement by 26 %. Now 4 x 14k = 56k: tau = 56k x 500 uF = 28.0 s, t(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
Active discharge (SPEC 7.2): R421-R424, 4 x 220R = 880R, in series with Q403 (C3M0350120J, 1200 V SiC). ~0.51 A initial at 450 V, ~230 W initial pulse for < 5 s - single-shot thermal rating [TBV], not continuous. Series string per SPEC 8.2 - no single resistor spans 450 V. HARDWARE-INHIBITED (SPEC 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
Q403 gate drive - VOM1271 photovoltaic driver, no supply needed. Rds elevated at ~8 V VGS (not spec'd below 11 V) - acceptable for current-limited single-shot duty (D022 research). R427 100R -> 220R (review 2 MJ-5 / MN-4): at 100R the LED drew I_F = 17-21 mA from an STM32F405 pin whose characterisa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
SPEC 7.1 sequencing rule: "precharge relay closes -> bus monitored -> main contactor closes only when V_bus >= 95% of supply -> precharge relay opens. The MCU commands both; neither may close without a valid bus voltage reading."
SPEC 7.2 discharge requirements: Passive bleeder: < 60 V within 60 s | 56k (4 x 14k) across the bus -> tau = 28.0 s, 56.4 s to 60 V; 3.6 W at 450 V (was 74.8k -> 75.4 s, FAILED - D025) Active discharge: < 60 V within 5 s, commanded | 880R + SiC FET -> tau 0.44 s, 0.89 s to 60 V; 230 W single-shot H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
Off-board HV interfaces (D021/D024). J401 DC input tap; J402/J403 chassis precharge resistor loop (R401 excluded from board); J404 return of chassis discharge bank R421-R424 (excluded from board) into Q403 drain; J405 DC_BUS_N tap. Bleeder R411-R414, divider and flyback taps stay on-board on the DC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
DISCHARGE INTERLOCK - SPEC 7.2 / D025 / review 3 MJ-12 (was CRITICAL C2). DISCHARGE_EN (PE4) and CONTACTOR_EN (PE3) were independent GPIOs with nothing between them. U402 = TI SN74LVC1G97DBVR configurable gate, SOT-23-6, 1.65-5.5 V, tpd 6.3 ns max at 3.3 V, +/-24 mA, Schmitt inputs, Ioff. Its funct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
COIL SUPPRESSION - review 3 C4/MN-5 and D025 (contactor coil is 1.7-2.5 A, SPEC 11.2, a requirement not an assumption). D401/D402 were BAS316: 250 mA I_F(AV), 500 mA I_FRM. D402 saw the full 1.7-2.5 A coil current on the first contactor drop-out - it fails, and takes Q402 with it. D401 sat at exact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
COIL DRIVER RE-RATING - consequence of the diode+TVS clamp above, NOT an independent change. Q401/Q402 were AO3400A, V_DS 30 V. With a SMBJ24A clamping at V_BR 26.7-29.5 V (and up to ~32 V at 2.5 A) plus the series rectifier V_F, the drain of each low-side switch now rests at rail + ~30-32 V during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
