aratzps/MCU-C/mcuc_inverter/mcuc_inverter.kicad_pcb

## KiCad design mcuc_inverter/mcuc_inverter.kicad_pcb (continued)

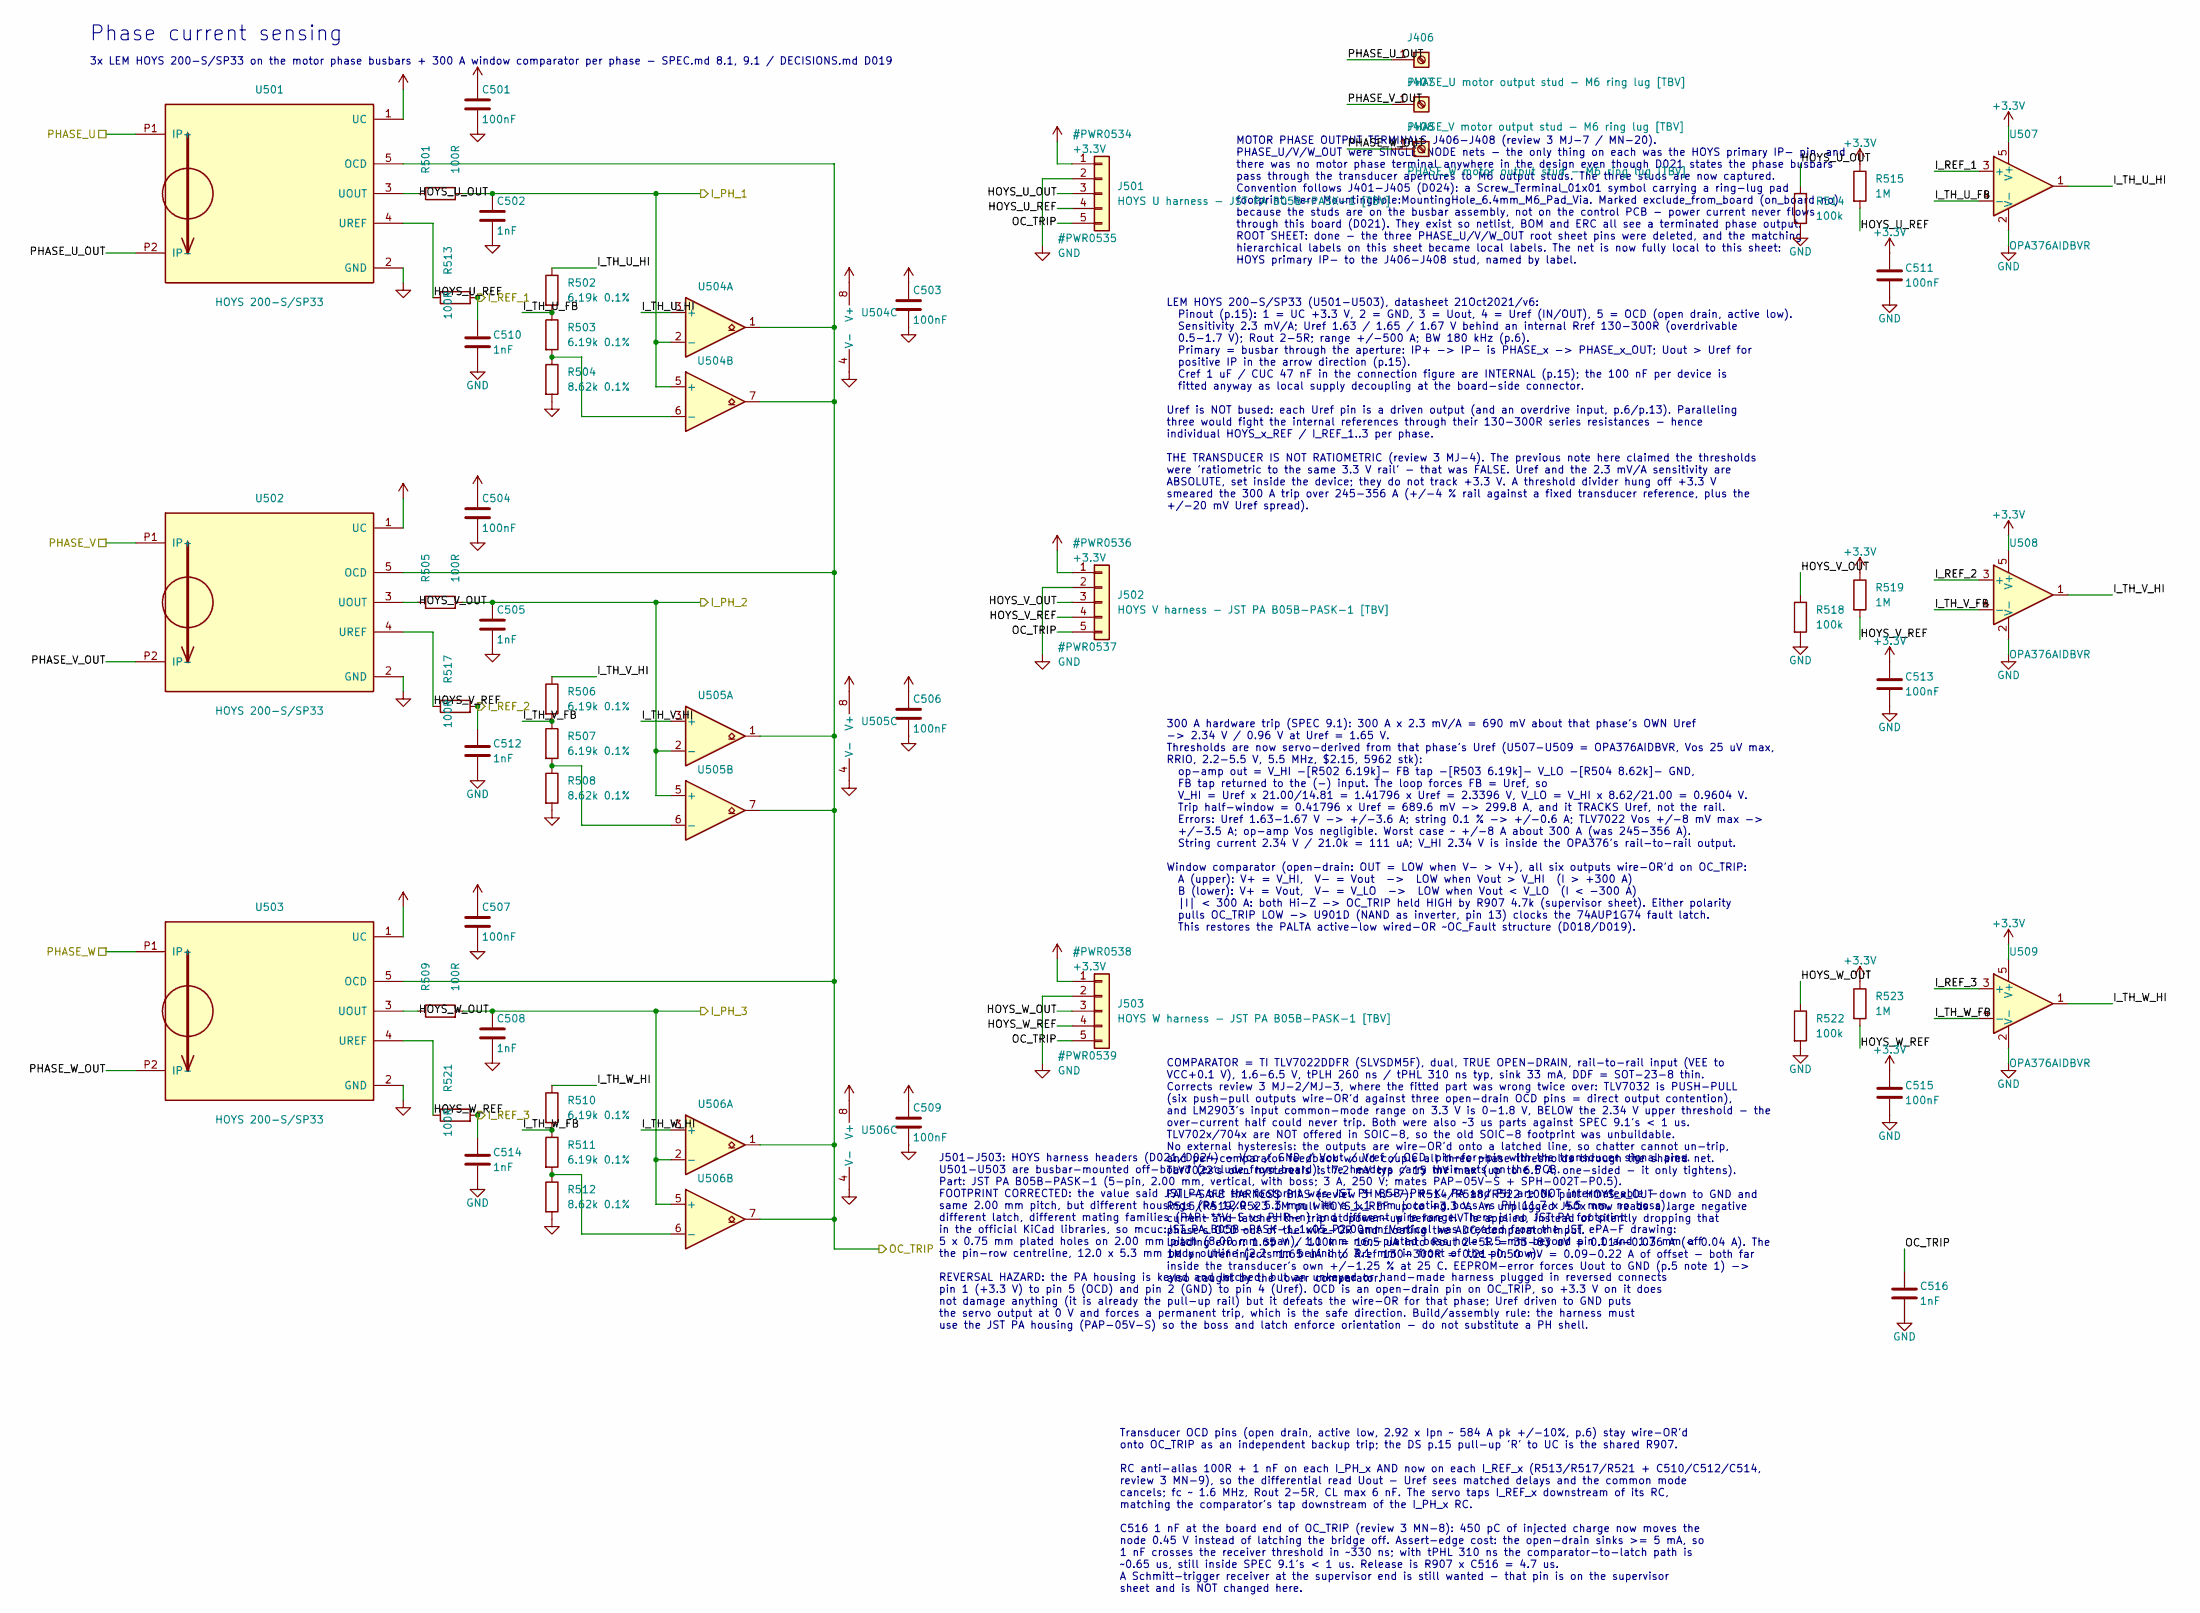
[picture p10: schematic current_sense.kicad_sch, MCU-C Integrated Inverter]

Parts:
C501, C503, C504, C506, C507, C509, C511, C513, C515: 100nF; C_0603_1608Metric
C502, C505, C508, C510, C512, C514, C516: 1nF; C_0603_1608Metric
J406: PHASE_U motor output stud - M6 ring lug [TBV]; MountingHole_6.4mm_M6_Pad_Via
J407: PHASE_V motor output stud - M6 ring lug [TBV]; MountingHole_6.4mm_M6_Pad_Via
J408: PHASE_W motor output stud - M6 ring lug [TBV]; MountingHole_6.4mm_M6_Pad_Via
J501: HOYS U harness - JST PA B05B-PASK-1 [TBV]; JST_PA_B05B-PASK-1_1x05_P2.00mm_Vertical
J502: HOYS V harness - JST PA B05B-PASK-1 [TBV]; JST_PA_B05B-PASK-1_1x05_P2.00mm_Vertical
J503: HOYS W harness - JST PA B05B-PASK-1 [TBV]; JST_PA_B05B-PASK-1_1x05_P2.00mm_Vertical
R501, R505, R509, R513, R517, R521: 100R; R_0603_1608Metric
R502, R503, R506, R507, R510, R511: 6.19k 0.1%; R_0603_1608Metric
R504, R508, R512: 8.62k 0.1%; R_0603_1608Metric
R514, R518, R522: 100k; R_0603_1608Metric
R515, R519, R523: 1M; R_0603_1608Metric
U501, U502, U503: HOYS 200-S/SP33
U504, U505, U506: TLV7022DDFR; Texas_DDF0008A_SOT-8_1.6x2.9mm_P0.65mm
U507, U508, U509: OPA376AIDBVR; SOT-23-5

Connections:
+3.3V: C501.1, C503.1, C504.1, C506.1, C507.1, C509.1, C511.1, C513.1, C515.1, J501.1, J502.1, J503.1, R515.1, R519.1, R523.1, U501.1 (UC), U502.1 (UC), U503.1 (UC), U504.8 (V+), U505.8 (V+), U506.8 (V+), U507.5 (V+), U508.5 (V+), U509.5 (V+); also elsewhere on the board
/I_PH_1: C502.1, R501.2, U504.2 (-), U504.5 (+); also elsewhere on the board
/I_PH_2: C505.1, R505.2, U505.2 (-), U505.5 (+); also elsewhere on the board
/I_PH_3: C508.1, R509.2, U506.2 (-), U506.5 (+); also elsewhere on the board
/I_REF_1: C510.1, R513.2, U507.3 (+); also elsewhere on the board
/I_REF_2: C512.1, R517.2, U508.3 (+); also elsewhere on the board
/I_REF_3: C514.1, R521.2, U509.3 (+); also elsewhere on the board
/Phase current sensing/HOYS_U_OUT: J501.3, R501.1, R514.1, U501.3 (UOUT)
/Phase current sensing/HOYS_U_REF: J501.4, R513.1, R515.2, U501.4 (UREF)
/Phase current sensing/HOYS_V_OUT: J502.3, R505.1, R518.1, U502.3 (UOUT)
/Phase current sensing/HOYS_V_REF: J502.4, R517.1, R519.2, U502.4 (UREF)
/Phase current sensing/HOYS_W_OUT: J503.3, R509.1, R522.1, U503.3 (UOUT)
/Phase current sensing/HOYS_W_REF: J503.4, R521.1, R523.2, U503.4 (UREF)
/Phase current sensing/I_TH_U_FB: R502.2, R503.1, U507.4 (-)
/Phase current sensing/I_TH_U_HI: R502.1, U504.3 (+), U507.1
/Phase current sensing/I_TH_V_FB: R506.2, R507.1, U508.4 (-)
/Phase current sensing/I_TH_V_HI: R506.1, U505.3 (+), U508.1
/Phase current sensing/I_TH_W_FB: R510.2, R511.1, U509.4 (-)
/Phase current sensing/I_TH_W_HI: R510.1, U506.3 (+), U509.1
/Phase current sensing/OC_TRIP: C516.1, J501.5, J502.5, J503.5, U501.5 (OCD), U502.5 (OCD), U503.5 (OCD), U504.1, U504.7, U505.1, U505.7, U506.1, U506.7; also elsewhere on the board
/Phase current sensing/PHASE_U_OUT: J406.1, U501.P2 (IP-)
/Phase current sensing/PHASE_V_OUT: J407.1, U502.P2 (IP-)
/Phase current sensing/PHASE_W_OUT: J408.1, U503.P2 (IP-)
GND: C501.2, C502.2, C503.2, C504.2, C505.2, C506.2, C507.2, C508.2, C509.2, C510.2, C511.2, C512.2, C513.2, C514.2, C515.2, C516.2, J501.2, J502.2, J503.2, R504.2, R508.2, R512.2, R514.2, R518.2, R522.2, U501.2 (GND), U502.2 (GND), U503.2 (GND), U504.4 (V-), U505.4 (V-), U506.4 (V-), U507.2 (V-), U508.2 (V-), U509.2 (V-); also elsewhere on the board
unnamed: R503.2, R504.1, U504.6 (-)
unnamed: R507.2, R508.1, U505.6 (-)
unnamed: R511.2, R512.1, U506.6 (-)

Notes on the sheet:
Phase current sensing
3x LEM HOYS 200-S/SP33 on the motor phase busbars + 300 A window comparator per phase - SPEC.md 8.1, 9.1 / DECISIONS.md D019
J501-J503: HOYS harness headers (D021/D024) - Vcc / GND / Vout / Vref / OCD, pin-for-pin with the transducer signal pins. U501-U503 are busbar-mounted off-board (exclude_from_board); the headers carry their nets on the PCB. Part: JST PA B05B-PASK-1 (5-pin, 2.00 mm, vertical, with boss; 3 A, 250 V; 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
LEM HOYS 200-S/SP33 (U501-U503), datasheet 21Oct2021/v6: Pinout (p.15): 1 = UC +3.3 V, 2 = GND, 3 = Uout, 4 = Uref (IN/OUT), 5 = OCD (open drain, active low). Sensitivity 2.3 mV/A; Uref 1.63 / 1.65 / 1.67 V behind an internal Rref 130-300R (overdrivable 0.5-1.7 V); Rout 2-5R; range +/-500 A; BW 180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
300 A hardware trip (SPEC 9.1): 300 A x 2.3 mV/A = 690 mV about that phase's OWN Uref -> 2.34 V / 0.96 V at Uref = 1.65 V. Thresholds are now servo-derived from that phase's Uref (U507-U509 = OPA376AIDBVR, Vos 25 uV max, RRIO, 2.2-5.5 V, 5.5 MHz, $2.15, 5962 stk): op-amp out = V_HI -[R502 6.19k]- F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
COMPARATOR = TI TLV7022DDFR (SLVSDM5F), dual, TRUE OPEN-DRAIN, rail-to-rail input (VEE to VCC+0.1 V), 1.6-6.5 V, tPLH 260 ns / tPHL 310 ns typ, sink 33 mA, DDF = SOT-23-8 thin. Corrects review 3 MJ-2/MJ-3, where the fitted part was wrong twice over: TLV7032 is PUSH-PULL (six push-pull outputs wire-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
Transducer OCD pins (open drain, active low, 2.92 x Ipn ~ 584 A pk +/-10%, p.6) stay wire-OR'd onto OC_TRIP as an independent backup trip; the DS p.15 pull-up 'R' to UC is the shared R907. RC anti-alias 100R + 1 nF on each I_PH_x AND now on each I_REF_x (R513/R517/R521 + C510/C512/C514, review 3 MN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
MOTOR PHASE OUTPUT TERMINALS J406-J408 (review 3 MJ-7 / MN-20). PHASE_U/V/W_OUT were SINGLE-NODE nets - the only thing on each was the HOYS primary IP- pin, and there was no motor phase terminal anywhere in the design even though D021 states the phase busbars pass through the transducer apertures t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

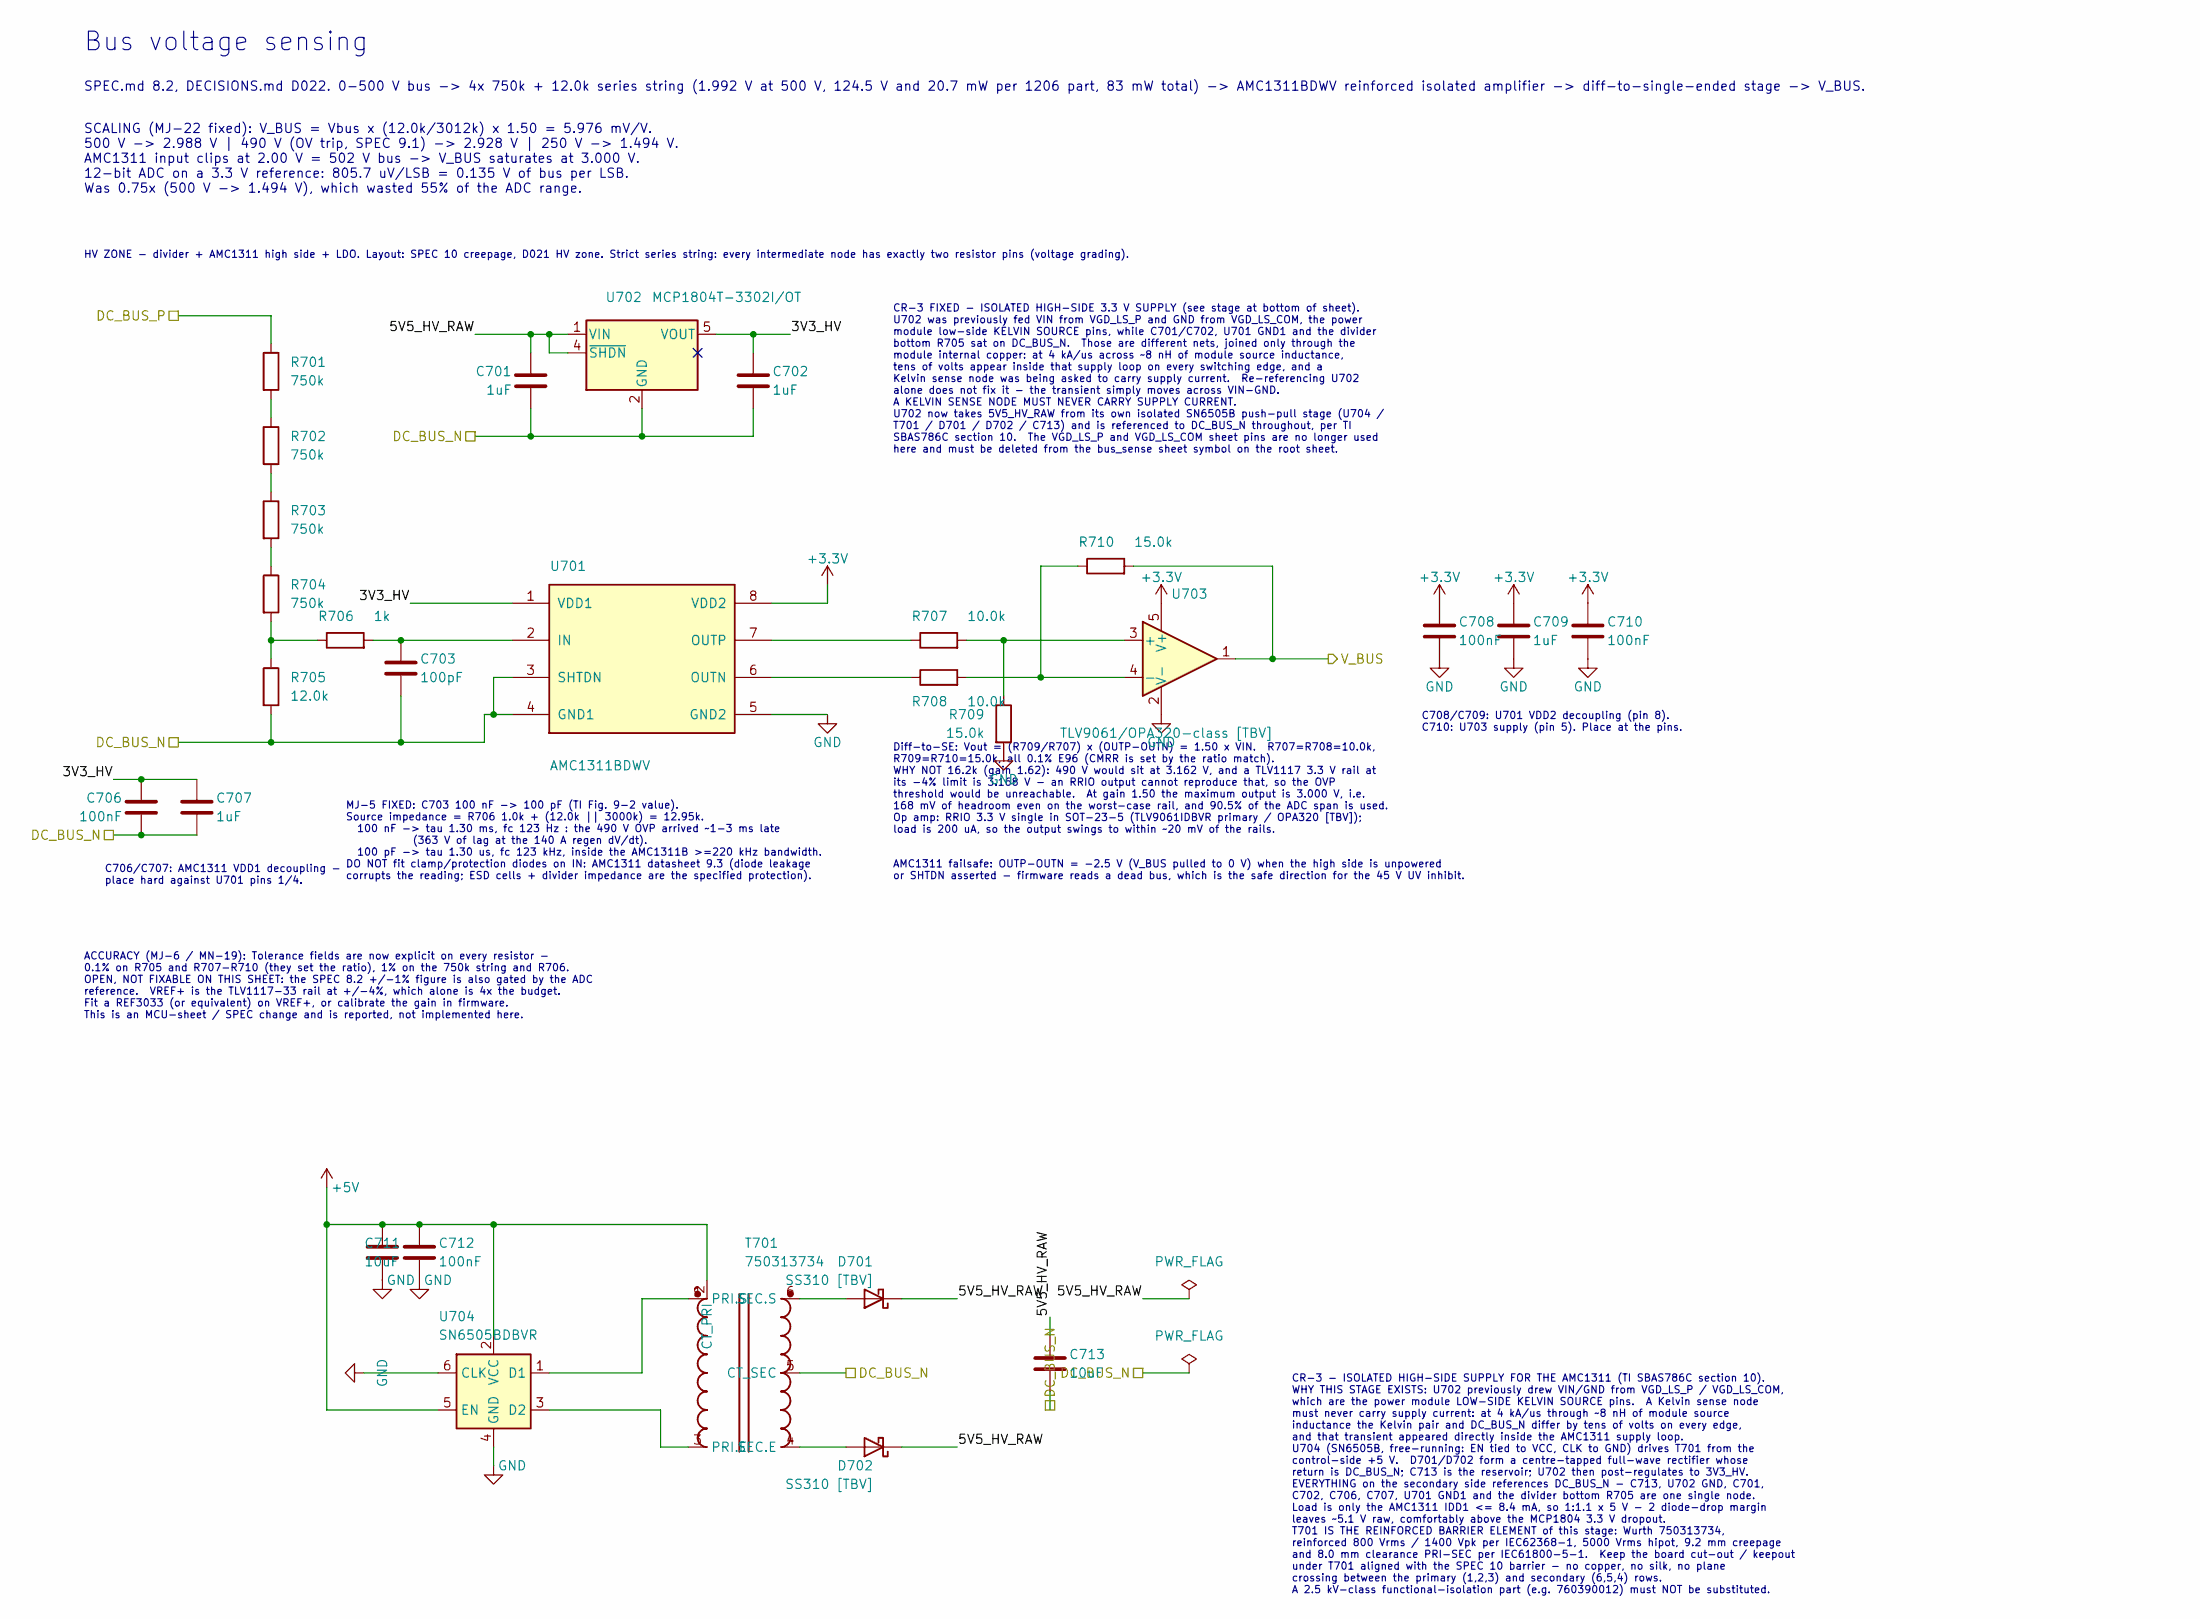
[picture p11: schematic bus_sense.kicad_sch, MCU-C Integrated Inverter]

Parts:
C701, C702, C707, C709: 1uF; C_0603_1608Metric
C703: 100pF; C_0603_1608Metric
C706, C708, C710, C712: 100nF; C_0603_1608Metric
C711, C713: 10uF; C_0805_2012Metric
D701, D702: SS310 [TBV]; D_SMC
R701, R702, R703, R704: 750k; R_1206_3216Metric; Tolerance 1%
R705: 12.0k; R_0603_1608Metric; Tolerance 0.1%
R706: 1k; R_0603_1608Metric; Tolerance 1%
R707, R708: 10.0k; R_0603_1608Metric; Tolerance 0.1%
R709, R710: 15.0k; R_0603_1608Metric; Tolerance 0.1%
T701: 750313734; WE_750313734; MPN 750313734
U701: AMC1311BDWV; SOIC-8_7.5x5.85mm_P1.27mm
U702: MCP1804T-3302I/OT; SOT-23-5
U703: TLV9061/OPA320-class [TBV]; SOT-23-5
U704: SN6505BDBVR; SOT-23-6

Connections:
+3.3V: C708.1, C709.1, C710.1, U701.8 (VDD2), U703.5 (V+); also elsewhere on the board
+5V: C711.1, C712.1, T701.2 (CT_PRI), U704.2 (VCC), U704.5 (EN); also elsewhere on the board
/Auxiliary power/DC_BUS_P: R701.1; also elsewhere on the board
/Bus voltage sensing/3V3_HV: C702.1, C706.1, C707.1, U701.1 (VDD1), U702.5 (VOUT)
/Bus voltage sensing/5V5_HV_RAW: C701.1, C713.1, D701.1 (K), D702.1 (K), U702.1 (VIN), U702.4 (~SHDN)
/Precharge and contactor/DC_BUS_N: C701.2, C702.2, C703.2, C706.2, C707.2, C713.2, R705.2, T701.5 (CT_SEC), U701.3 (SHTDN), U701.4 (GND1), U702.2 (GND); also elsewhere on the board
/V_BUS: R710.2, U703.1; also elsewhere on the board
GND: C708.2, C709.2, C710.2, C711.2, C712.2, R709.2, U701.5 (GND2), U703.2 (V-), U704.4 (GND), U704.6 (CLK); also elsewhere on the board
unnamed: D701.2 (A), T701.6 (SEC.S)
unnamed: D702.2 (A), T701.4 (SEC.E)
unnamed: R701.2, R702.1
unnamed: R702.2, R703.1
unnamed: R703.2, R704.1
unnamed: R704.2, R705.1, R706.1
unnamed: T701.3 (PRI.E), U704.3 (D2)
unnamed: T701.1 (PRI.S), U704.1 (D1)
unnamed: C703.1, R706.2, U701.2 (IN)
unnamed: R708.1, U701.6 (OUTN)
unnamed: R707.1, U701.7 (OUTP)
unnamed: R707.2, R709.1, U703.3 (+)
unnamed: R708.2, R710.1, U703.4 (-)

Notes on the sheet:
Bus voltage sensing
SPEC.md 8.2, DECISIONS.md D022. 0-500 V bus -> 4x 750k + 12.0k series string (1.992 V at 500 V, 124.5 V and 20.7 mW per 1206 part, 83 mW total) -> AMC1311BDWV reinforced isolated amplifier -> diff-to-single-ended stage -> V_BUS.
HV ZONE - divider + AMC1311 high side + LDO. Layout: SPEC 10 creepage, D021 HV zone. Strict series string: every intermediate node has exactly two resistor pins (voltage grading).
C706/C707: AMC1311 VDD1 decoupling - place hard against U701 pins 1/4.
C708/C709: U701 VDD2 decoupling (pin 8). C710: U703 supply (pin 5). Place at the pins.
AMC1311 failsafe: OUTP-OUTN = -2.5 V (V_BUS pulled to 0 V) when the high side is unpowered or SHTDN asserted - firmware reads a dead bus, which is the safe direction for the 45 V UV inhibit.
SCALING (MJ-22 fixed): V_BUS = Vbus x (12.0k/3012k) x 1.50 = 5.976 mV/V. 500 V -> 2.988 V | 490 V (OV trip, SPEC 9.1) -> 2.928 V | 250 V -> 1.494 V. AMC1311 input clips at 2.00 V = 502 V bus -> V_BUS saturates at 3.000 V. 12-bit ADC on a 3.3 V reference: 805.7 uV/LSB = 0.135 V of bus per LSB. Was 0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
MJ-5 FIXED: C703 100 nF -> 100 pF (TI Fig. 9-2 value). Source impedance = R706 1.0k + (12.0k || 3000k) = 12.95k. 100 nF -> tau 1.30 ms, fc 123 Hz : the 490 V OVP arrived ~1-3 ms late (363 V of lag at the 140 A regen dV/dt). 100 pF -> tau 1.30 us, fc 123 kHz, inside the AMC1311B >=220 kHz bandwidth.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
Diff-to-SE: Vout = (R709/R707) x (OUTP-OUTN) = 1.50 x VIN. R707=R708=10.0k, R709=R710=15.0k, all 0.1% E96 (CMRR is set by the ratio match). WHY NOT 16.2k (gain 1.62): 490 V would sit at 3.162 V, and a TLV1117 3.3 V rail at its -4% limit is 3.168 V - an RRIO output cannot reproduce that, so the OVP 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
ACCURACY (MJ-6 / MN-19): Tolerance fields are now explicit on every resistor - 0.1% on R705 and R707-R710 (they set the ratio), 1% on the 750k string and R706. OPEN, NOT FIXABLE ON THIS SHEET: the SPEC 8.2 +/-1% figure is also gated by the ADC reference. VREF+ is the TLV1117-33 rail at +/-4%, which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
CR-3 FIXED - ISOLATED HIGH-SIDE 3.3 V SUPPLY (see stage at bottom of sheet). U702 was previously fed VIN from VGD_LS_P and GND from VGD_LS_COM, the power module low-side KELVIN SOURCE pins, while C701/C702, U701 GND1 and the divider bottom R705 sat on DC_BUS_N. Those are different nets, joined only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
CR-3 - ISOLATED HIGH-SIDE SUPPLY FOR THE AMC1311 (TI SBAS786C section 10). WHY THIS STAGE EXISTS: U702 previously drew VIN/GND from VGD_LS_P / VGD_LS_COM, which are the power module LOW-SIDE KELVIN SOURCE pins. A Kelvin sense node must never carry supply current: at 4 kA/us through ~8 nH of module 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

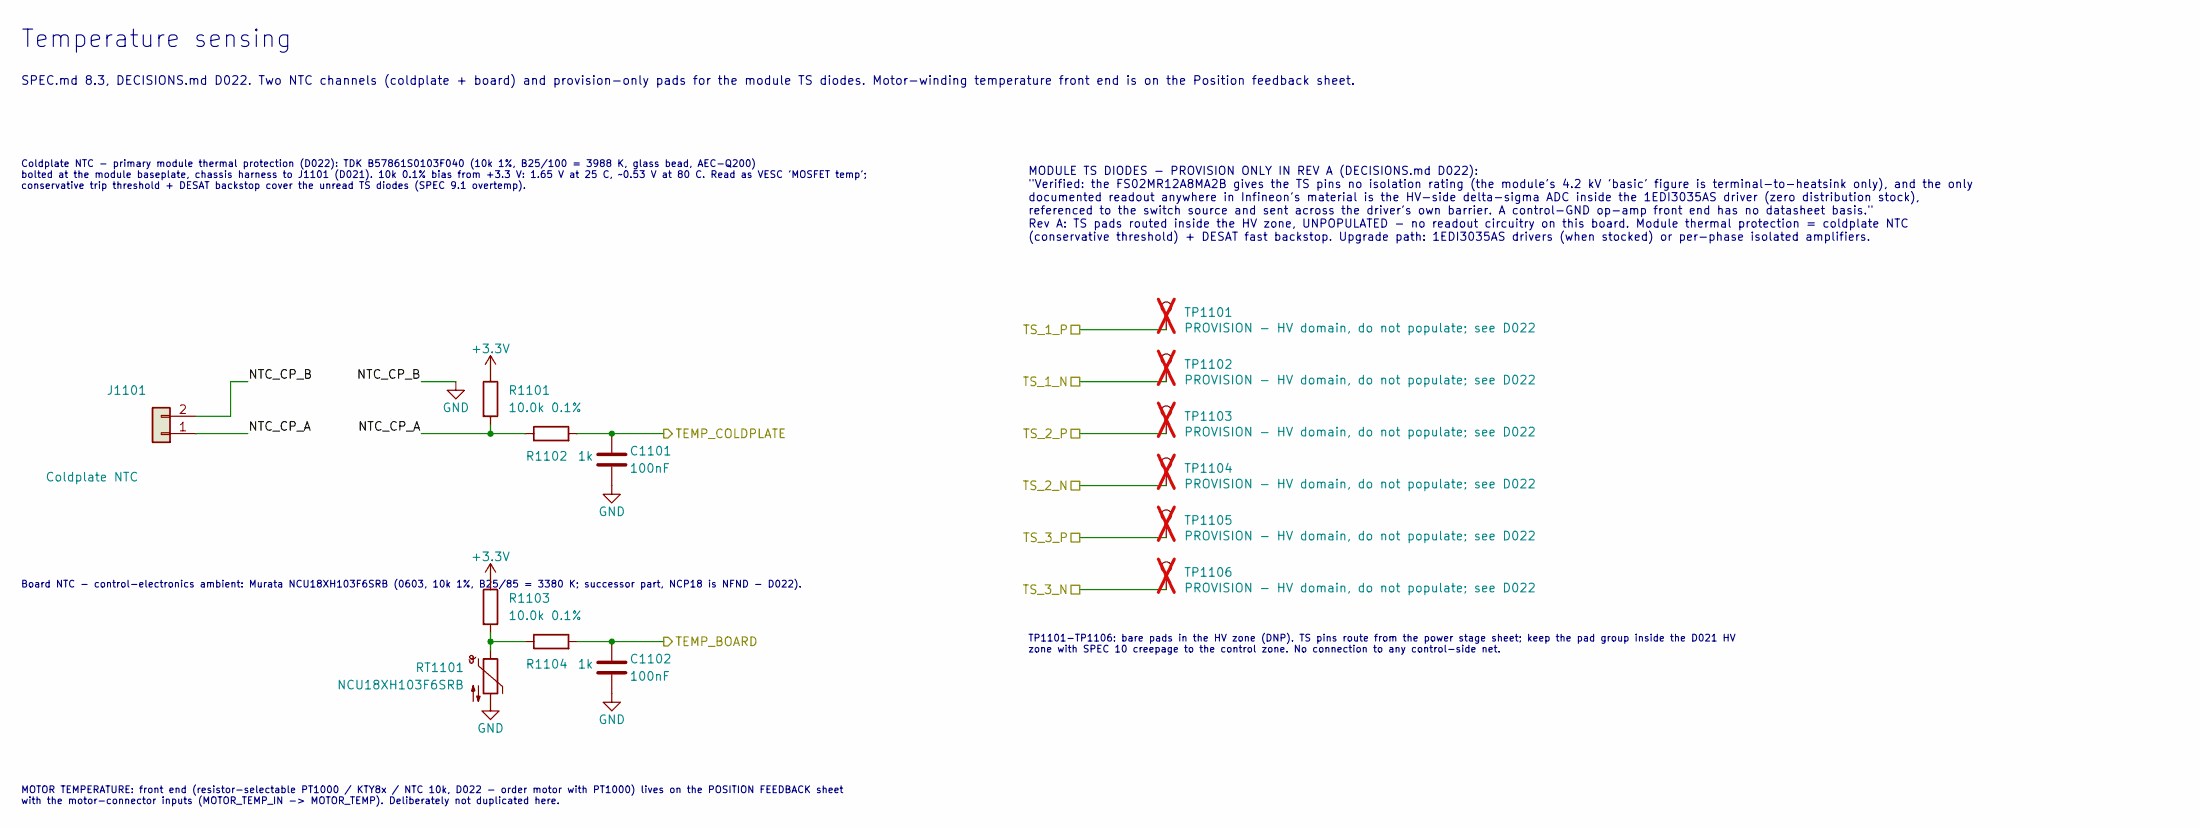
[picture p12: schematic temp_sense.kicad_sch, MCU-C Integrated Inverter]

Parts:
C1101, C1102: 100nF; C_0603_1608Metric
J1101: Coldplate NTC; JST_PH_B2B-PH-K_1x02_P2.00mm_Vertical
R1101, R1103: 10.0k 0.1%; R_0603_1608Metric
R1102, R1104: 1k; R_0603_1608Metric
RT1101: NCU18XH103F6SRB; R_0603_1608Metric
TP1101, TP1102, TP1103, TP1104, TP1105, TP1106: PROVISION - HV domain, do not populate; see D022; TestPoint_Pad_D1.5mm; not fitted

Connections:
+3.3V: R1101.1, R1103.1; also elsewhere on the board
/TEMP_BOARD: C1102.1, R1104.2; also elsewhere on the board
/TEMP_COLDPLATE: C1101.1, R1102.2; also elsewhere on the board
/TS_1_N: TP1102.1; also elsewhere on the board
/TS_1_P: TP1101.1; also elsewhere on the board
/TS_2_N: TP1104.1; also elsewhere on the board
/TS_2_P: TP1103.1; also elsewhere on the board
/TS_3_N: TP1106.1; also elsewhere on the board
/TS_3_P: TP1105.1; also elsewhere on the board
/Temperature sensing/NTC_CP_A: J1101.1, R1101.2, R1102.1
GND: C1101.2, C1102.2, J1101.2, RT1101.2; also elsewhere on the board
unnamed: R1103.2, R1104.1, RT1101.1

Notes on the sheet:
Temperature sensing
SPEC.md 8.3, DECISIONS.md D022. Two NTC channels (coldplate + board) and provision-only pads for the module TS diodes. Motor-winding temperature front end is on the Position feedback sheet.
Coldplate NTC - primary module thermal protection (D022): TDK B57861S0103F040 (10k 1%, B25/100 = 3988 K, glass bead, AEC-Q200) bolted at the module baseplate, chassis harness to J1101 (D021). 10k 0.1% bias from +3.3 V: 1.65 V at 25 C, ~0.53 V at 80 C. Read as VESC 'MOSFET temp'; conservative trip t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
Board NTC - control-electronics ambient: Murata NCU18XH103F6SRB (0603, 10k 1%, B25/85 = 3380 K; successor part, NCP18 is NFND - D022).
MODULE TS DIODES - PROVISION ONLY IN REV A (DECISIONS.md D022): "Verified: the FS02MR12A8MA2B gives the TS pins no isolation rating (the module's 4.2 kV 'basic' figure is terminal-to-heatsink only), and the only documented readout anywhere in Infineon's material is the HV-side delta-sigma ADC insid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
TP1101-TP1106: bare pads in the HV zone (DNP). TS pins route from the power stage sheet; keep the pad group inside the D021 HV zone with SPEC 10 creepage to the control zone. No connection to any control-side net.
MOTOR TEMPERATURE: front end (resistor-selectable PT1000 / KTY8x / NTC 10k, D022 - order motor with PT1000) lives on the POSITION FEEDBACK sheet with the motor-connector inputs (MOTOR_TEMP_IN -> MOTOR_TEMP). Deliberately not duplicated here.

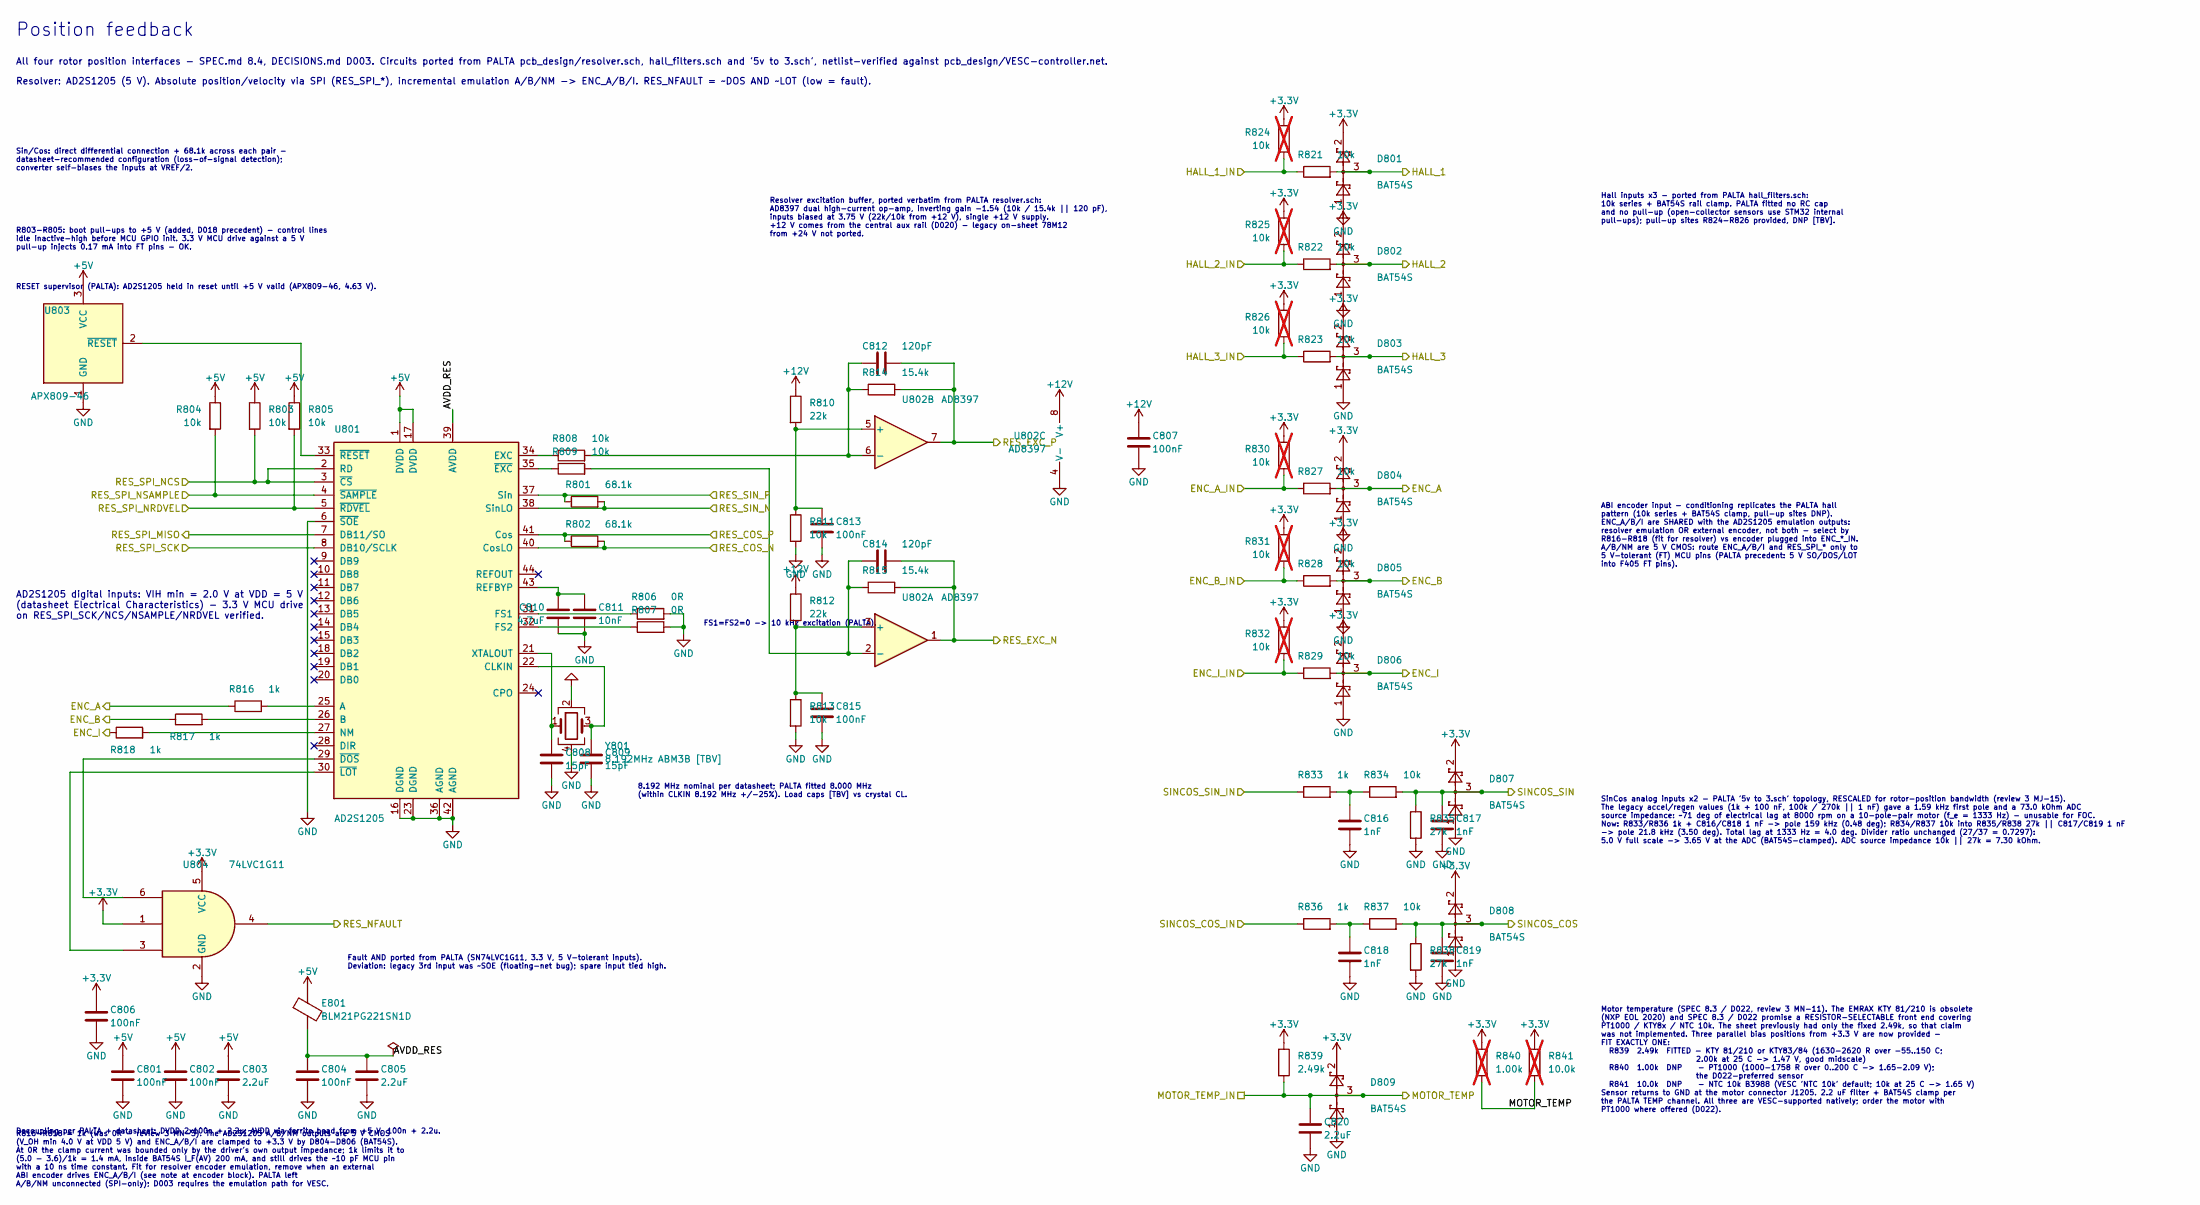
[picture p13: schematic position.kicad_sch, MCU-C Integrated Inverter]

Parts:
C801, C802, C804, C806, C807, C813, C815: 100nF; C_0603_1608Metric
C803, C805, C820: 2.2uF; C_0603_1608Metric
C808, C809: 15pF; C_0603_1608Metric
C810: 4.7uF; C_0603_1608Metric
C811: 10nF; C_0603_1608Metric
C812, C814: 120pF; C_0603_1608Metric
C816, C817, C818, C819: 1nF; C_0603_1608Metric
D801, D802, D803, D804, D805, D806, D807, D808, D809: BAT54S; SOT-23
E801: BLM21PG221SN1D; L_0805_2012Metric
R801, R802: 68.1k; R_0603_1608Metric
R803, R804, R805, R808, R809, R811, R813, R821, R822, R823, R827, R828, R829, R834, R837: 10k; R_0603_1608Metric
R806, R807: 0R; R_0603_1608Metric
R810, R812: 22k; R_0603_1608Metric
R814, R815: 15.4k; R_0603_1608Metric
R816, R817, R818, R833, R836: 1k; R_0603_1608Metric
R824, R825, R826, R830, R831, R832: 10k; R_0603_1608Metric; not fitted
R835, R838: 27k; R_0603_1608Metric
R839: 2.49k; R_0603_1608Metric
R840: 1.00k; R_0603_1608Metric; not fitted
R841: 10.0k; R_0603_1608Metric; not fitted
U801: AD2S1205; LQFP-44_10x10mm_P0.8mm
U802: AD8397; SOIC-8-1EP_3.9x4.9mm_P1.27mm_EP2.29x3mm
U803: APX809-46; SOT-23
U804: 74LVC1G11; SOT-363_SC-70-6
Y801: 8.192MHz ABM3B [TBV]; Crystal_SMD_Abracon_ABM3B-4Pin_5.0x3.2mm

Connections:
+3.3V: C806.1, D801.2 (K), D802.2 (K), D803.2 (K), D804.2 (K), D805.2 (K), D806.2 (K), D807.2 (K), D808.2 (K), D809.2 (K), R824.1, R825.1, R826.1, R830.1, R831.1, R832.1, R839.1, R840.1, R841.1, U804.1, U804.5 (VCC); also elsewhere on the board
+5V: C801.1, C802.1, C803.1, E801.1, R803.1, R804.1, R805.1, U801.1 (DVDD), U801.17 (DVDD), U803.3 (VCC); also elsewhere on the board
+12V: C807.1, R810.1, R812.1, U802.8 (V+); also elsewhere on the board
/Communications/ENC_A_IN: R827.1, R830.2; also elsewhere on the board
/Communications/ENC_B_IN: R828.1, R831.2; also elsewhere on the board
/Communications/ENC_I_IN: R829.1, R832.2; also elsewhere on the board
/Communications/HALL_1_IN: R821.1, R824.2; also elsewhere on the board
/Communications/HALL_2_IN: R822.1, R825.2; also elsewhere on the board
/Communications/HALL_3_IN: R823.1, R826.2; also elsewhere on the board
/Communications/RES_COS_N: R802.2, U801.40 (CosLO); also elsewhere on the board
/Communications/RES_COS_P: R802.1, U801.41 (Cos); also elsewhere on the board
/Communications/RES_EXC_N: C814.2, R815.2, U802.1; also elsewhere on the board
/Communications/RES_EXC_P: C812.2, R814.2, U802.7; also elsewhere on the board
/Communications/RES_SIN_N: R801.2, U801.38 (SinLO); also elsewhere on the board
/Communications/RES_SIN_P: R801.1, U801.37 (Sin); also elsewhere on the board
/Communications/SINCOS_COS_IN: R836.1; also elsewhere on the board
/Communications/SINCOS_SIN_IN: R833.1; also elsewhere on the board
/ENC_A: D804.3 (COM), R816.1, R827.2; also elsewhere on the board
/ENC_B: D805.3 (COM), R817.1, R828.2; also elsewhere on the board
/ENC_I: D806.3 (COM), R818.1, R829.2; also elsewhere on the board
/HALL_1: D801.3 (COM), R821.2; also elsewhere on the board
/HALL_2: D802.3 (COM), R822.2; also elsewhere on the board
/HALL_3: D803.3 (COM), R823.2; also elsewhere on the board
/MOTOR_TEMP: C820.1, D809.3 (COM), R839.2, R840.2, R841.2; also elsewhere on the board
/Position feedback/AVDD_RES: C804.1, C805.1, E801.2, U801.39 (AVDD)
/RES_NFAULT: U804.4; also elsewhere on the board
/RES_SPI_MISO: U801.7 (DB11/SO); also elsewhere on the board
/RES_SPI_NCS: R803.2, U801.2 (RD), U801.3 (~CS); also elsewhere on the board
/RES_SPI_NRDVEL: R805.2, U801.5 (~RDVEL); also elsewhere on the board
/RES_SPI_NSAMPLE: R804.2, U801.4 (~SAMPLE); also elsewhere on the board
/RES_SPI_SCK: U801.8 (DB10/SCLK); also elsewhere on the board
/SINCOS_COS: C819.1, D808.3 (COM), R837.2, R838.1; also elsewhere on the board
/SINCOS_SIN: C817.1, D807.3 (COM), R834.2, R835.1; also elsewhere on the board
GND: C801.2, C802.2, C803.2, C804.2, C805.2, C806.2, C807.2, C808.2, C809.2, C810.2, C811.2, C813.2, C815.2, C816.2, C817.2, C818.2, C819.2, C820.2, D801.1 (A), D802.1 (A), D803.1 (A), D804.1 (A), D805.1 (A), D806.1 (A), D807.1 (A), D808.1 (A), D809.1 (A), R806.2, R807.2, R811.2, R813.2, R835.2, R838.2, U801.6 (~SOE), U801.16 (DGND), U801.23 (DGND), U801.36 (AGND), U801.42 (AGND), U802.4 (V-), U803.1 (GND), U804.2 (GND), Y801.2, Y801.4; also elsewhere on the board
unnamed: C816.1, R833.2, R834.1
unnamed: C818.1, R836.2, R837.1
unnamed: R816.2, U801.25 (A)
unnamed: R817.2, U801.26 (B)
unnamed: C809.1, U801.22 (CLKIN), Y801.3
unnamed: R808.1, U801.34 (EXC)
unnamed: R806.1, U801.31 (FS1)
unnamed: R807.1, U801.32 (FS2)
unnamed: R818.2, U801.27 (NM)
unnamed: C810.1, C811.1, U801.43 (REFBYP)
unnamed: C808.1, U801.21 (XTALOUT), Y801.1
unnamed: U801.29 (~DOS), U804.6
unnamed: R809.1, U801.35 (~EXC)
unnamed: U801.30 (~LOT), U804.3
unnamed: U801.33 (~RESET), U803.2 (~RESET)
unnamed: C815.1, R812.2, R813.1, U802.3 (+)
unnamed: C814.1, R809.2, R815.1, U802.2 (-)
unnamed: C813.1, R810.2, R811.1, U802.5 (+)
unnamed: C812.1, R808.2, R814.1, U802.6 (-)

Notes on the sheet:
Position feedback
All four rotor position interfaces - SPEC.md 8.4, DECISIONS.md D003. Circuits ported from PALTA pcb_design/resolver.sch, hall_filters.sch and '5v to 3.sch', netlist-verified against pcb_design/VESC-controller.net.
Resolver: AD2S1205 (5 V). Absolute position/velocity via SPI (RES_SPI_*), incremental emulation A/B/NM -> ENC_A/B/I. RES_NFAULT = ~DOS AND ~LOT (low = fault).
RESET supervisor (PALTA): AD2S1205 held in reset until +5 V valid (APX809-46, 4.63 V).
R803-R805: boot pull-ups to +5 V (added, D018 precedent) - control lines idle inactive-high before MCU GPIO init. 3.3 V MCU drive against a 5 V pull-up injects 0.17 mA into FT pins - OK.
R816-R818 = 1k (was 0R - review 3 MN-3). The AD2S1205 A/B/NM outputs are 5 V CMOS (V_OH min 4.0 V at VDD 5 V) and ENC_A/B/I are clamped to +3.3 V by D804-D806 (BAT54S). At 0R the clamp current was bounded only by the driver's own output impedance; 1k limits it to (5.0 - 3.6)/1k = 1.4 mA, inside BAT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
Fault AND ported from PALTA (SN74LVC1G11, 3.3 V, 5 V-tolerant inputs). Deviation: legacy 3rd input was ~SOE (floating-net bug); spare input tied high.
Decoupling per PALTA + datasheet: DVDD 2x100n + 2.2u; AVDD via ferrite bead from +5 V, 100n + 2.2u.
Sin/Cos: direct differential connection + 68.1k across each pair - datasheet-recommended configuration (loss-of-signal detection); converter self-biases the inputs at VREF/2.
FS1=FS2=0 -> 10 kHz excitation (PALTA).
8.192 MHz nominal per datasheet; PALTA fitted 8.000 MHz (within CLKIN 8.192 MHz +/-25%). Load caps [TBV] vs crystal CL.
Resolver excitation buffer, ported verbatim from PALTA resolver.sch: AD8397 dual high-current op-amp, inverting gain -1.54 (10k / 15.4k || 120 pF), inputs biased at 3.75 V (22k/10k from +12 V), single +12 V supply. +12 V comes from the central aux rail (D020) - legacy on-sheet 78M12 from +24 V not 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
Hall inputs x3 - ported from PALTA hall_filters.sch: 10k series + BAT54S rail clamp. PALTA fitted no RC cap and no pull-up (open-collector sensors use STM32 internal pull-ups); pull-up sites R824-R826 provided, DNP [TBV].
ABI encoder input - conditioning replicates the PALTA hall pattern (10k series + BAT54S clamp, pull-up sites DNP). ENC_A/B/I are SHARED with the AD2S1205 emulation outputs: resolver emulation OR external encoder, not both - select by R816-R818 (fit for resolver) vs encoder plugged into ENC_*_IN. A/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
SinCos analog inputs x2 - PALTA '5v to 3.sch' topology, RESCALED for rotor-position bandwidth (review 3 MJ-15). The legacy accel/regen values (1k + 100 nF, 100k / 270k || 1 nF) gave a 1.59 kHz first pole and a 73.0 kOhm ADC source impedance: ~71 deg of electrical lag at 8000 rpm on a 10-pole-pair m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
Motor temperature (SPEC 8.3 / D022, review 3 MN-11). The EMRAX KTY 81/210 is obsolete (NXP EOL 2020) and SPEC 8.3 / D022 promise a RESISTOR-SELECTABLE front end covering PT1000 / KTY8x / NTC 10k. The sheet previously had only the fixed 2.49k, so that claim was not implemented. Three parallel bias p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
AD2S1205 digital inputs: VIH min = 2.0 V at VDD = 5 V (datasheet Electrical Characteristics) - 3.3 V MCU drive on RES_SPI_SCK/NCS/NSAMPLE/NRDVEL verified.
