aratzps/MCU-C/mcuc_inverter/mcuc_inverter.kicad_pcb

## KiCad design mcuc_inverter/mcuc_inverter.kicad_pcb (continued)

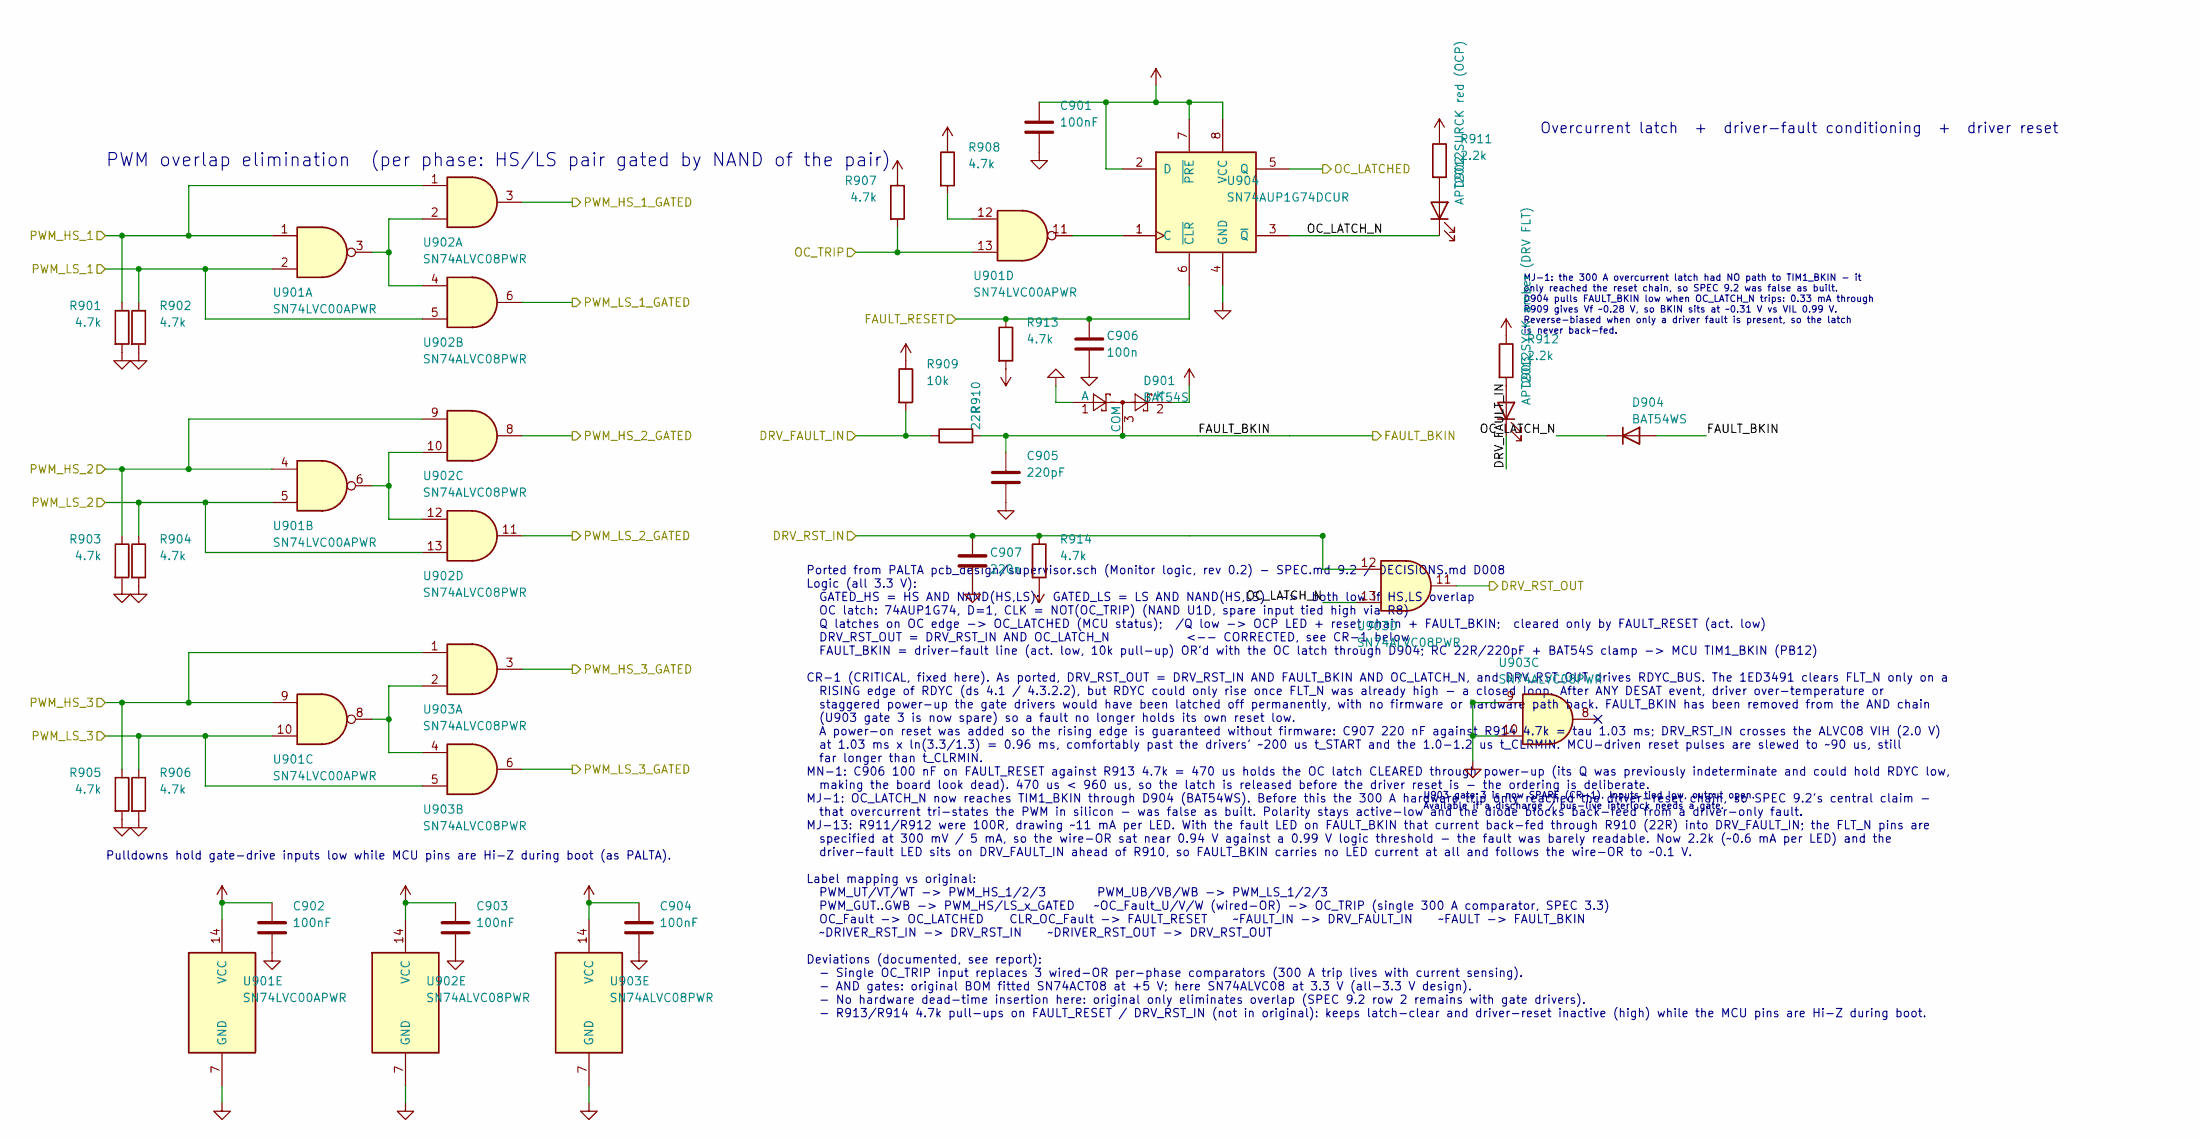
[picture p14: schematic supervisor.kicad_sch, MCU-C Integrated Inverter]

Parts:
C901, C902, C903, C904: 100nF; C_0603_1608Metric
C905: 220pF; C_0603_1608Metric
C906: 100n; C_0603_1608Metric
C907: 220n; C_0603_1608Metric
D901: BAT54S; SOT-23
D902: APT2012SURCK red (OCP); LED_0805_2012Metric
D903: APT2012SYCK amber (DRV FLT); LED_0805_2012Metric
D904: BAT54WS; D_SOD-323
R901, R902, R903, R904, R905, R906, R907, R908, R913, R914: 4.7k; R_0603_1608Metric
R909: 10k; R_0603_1608Metric
R910: 22R; R_0603_1608Metric
R911, R912: 2.2k; R_0603_1608Metric
U901: SN74LVC00APWR; TSSOP-14_4.4x5mm_P0.65mm
U902, U903: SN74ALVC08PWR; TSSOP-14_4.4x5mm_P0.65mm
U904: SN74AUP1G74DCUR; VSSOP-8_2.3x2mm_P0.5mm

Connections:
+3.3V: C901.1, C902.1, C903.1, C904.1, D901.2 (K), R907.1, R908.1, R909.1, R911.1, R912.1, R913.2, R914.2, U901.14 (VCC), U902.14 (VCC), U903.14 (VCC), U904.2 (D), U904.7 (~PRE), U904.8 (VCC); also elsewhere on the board
/DRV_RST_IN: C907.1, R914.1, U903.12; also elsewhere on the board
/FAULT_RESET: C906.1, R913.1, U904.6 (~CLR); also elsewhere on the board
/Gate drive/DRV_RST_OUT: U903.11; also elsewhere on the board
/Gate drive/PWM_HS_1_GATED: U902.3; also elsewhere on the board
/Gate drive/PWM_HS_2_GATED: U902.8; also elsewhere on the board
/Gate drive/PWM_HS_3_GATED: U903.3; also elsewhere on the board
/Gate drive/PWM_LS_1_GATED: U902.6; also elsewhere on the board
/Gate drive/PWM_LS_2_GATED: U902.11; also elsewhere on the board
/Gate drive/PWM_LS_3_GATED: U903.6; also elsewhere on the board
/MCU/PWM_HS_1: R901.1, U901.1, U902.1; also elsewhere on the board
/MCU/PWM_HS_2: R903.1, U901.4, U902.9; also elsewhere on the board
/MCU/PWM_HS_3: R905.1, U901.9, U903.1; also elsewhere on the board
/MCU/PWM_LS_1: R902.1, U901.2, U902.5; also elsewhere on the board
/MCU/PWM_LS_2: R904.1, U901.5, U902.13; also elsewhere on the board
/MCU/PWM_LS_3: R906.1, U901.10, U903.5; also elsewhere on the board
/OC_LATCHED: U904.5 (Q); also elsewhere on the board
/Phase current sensing/OC_TRIP: R907.2, U901.13; also elsewhere on the board
/Supervisor and interlocks/DRV_FAULT_IN: D903.1 (K), R909.2, R910.1; also elsewhere on the board
/Supervisor and interlocks/FAULT_BKIN: C905.1, D901.3 (COM), D904.2 (A), R910.2; also elsewhere on the board
/Supervisor and interlocks/OC_LATCH_N: D902.1 (K), D904.1 (K), U903.13, U904.3 (~Q)
GND: C901.2, C902.2, C903.2, C904.2, C905.2, C906.2, C907.2, D901.1 (A), R901.2, R902.2, R903.2, R904.2, R905.2, R906.2, U901.7 (GND), U902.7 (GND), U903.7 (GND), U903.9, U903.10, U904.4 (GND); also elsewhere on the board
unnamed: D902.2 (A), R911.2
unnamed: D903.2 (A), R912.2
unnamed: R908.2, U901.12
unnamed: U901.3, U902.2, U902.4
unnamed: U901.6, U902.10, U902.12
unnamed: U901.8, U903.2, U903.4
unnamed: U901.11, U904.1 (C)

Notes on the sheet:
PWM overlap elimination (per phase: HS/LS pair gated by NAND of the pair)
Overcurrent latch + driver-fault conditioning + driver reset
Pulldowns hold gate-drive inputs low while MCU pins are Hi-Z during boot (as PALTA).
Ported from PALTA pcb_design/supervisor.sch (Monitor logic, rev 0.2) - SPEC.md 9.2 / DECISIONS.md D008 Logic (all 3.3 V): GATED_HS = HS AND NAND(HS,LS); GATED_LS = LS AND NAND(HS,LS) -> both low if HS,LS overlap OC latch: 74AUP1G74, D=1, CLK = NOT(OC_TRIP) (NAND U1D, spare input tied high via R8) Q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
U903 gate 3 is now SPARE (CR-1). Inputs tied low, output open. Available if a discharge / bus-live interlock needs a gate.
MJ-1: the 300 A overcurrent latch had NO path to TIM1_BKIN - it only reached the reset chain, so SPEC 9.2 was false as built. D904 pulls FAULT_BKIN low when OC_LATCH_N trips: 0.33 mA through R909 gives Vf ~0.28 V, so BKIN sits at ~0.31 V vs VIL 0.99 V. Reverse-biased when only a driver fault is pre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

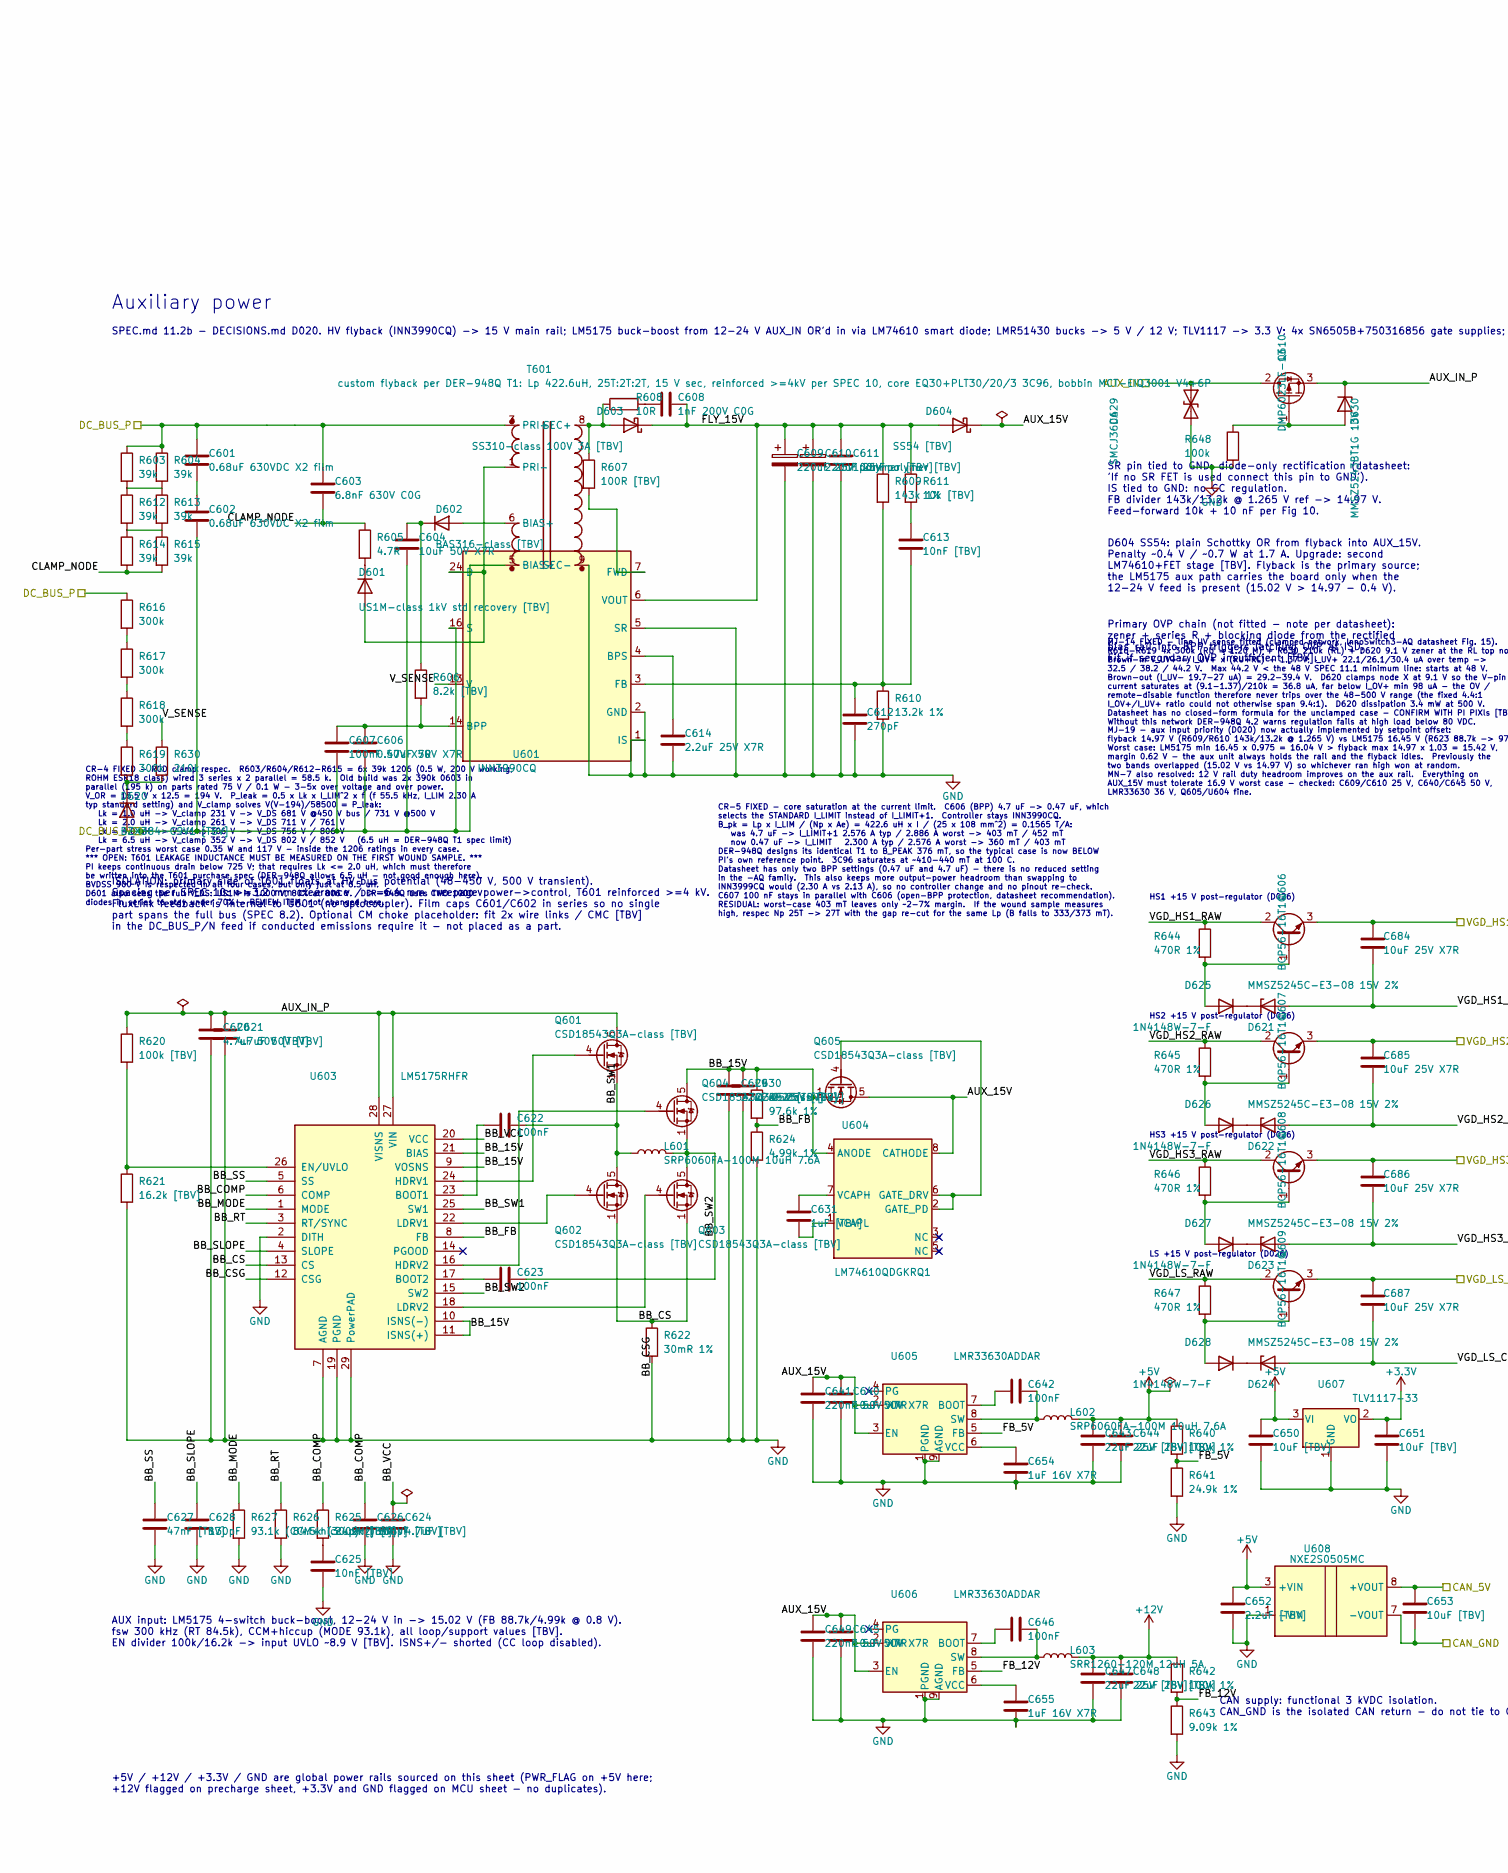
[picture p15: schematic aux_power.kicad_sch, MCU-C Integrated Inverter, part in row 1, column 1]

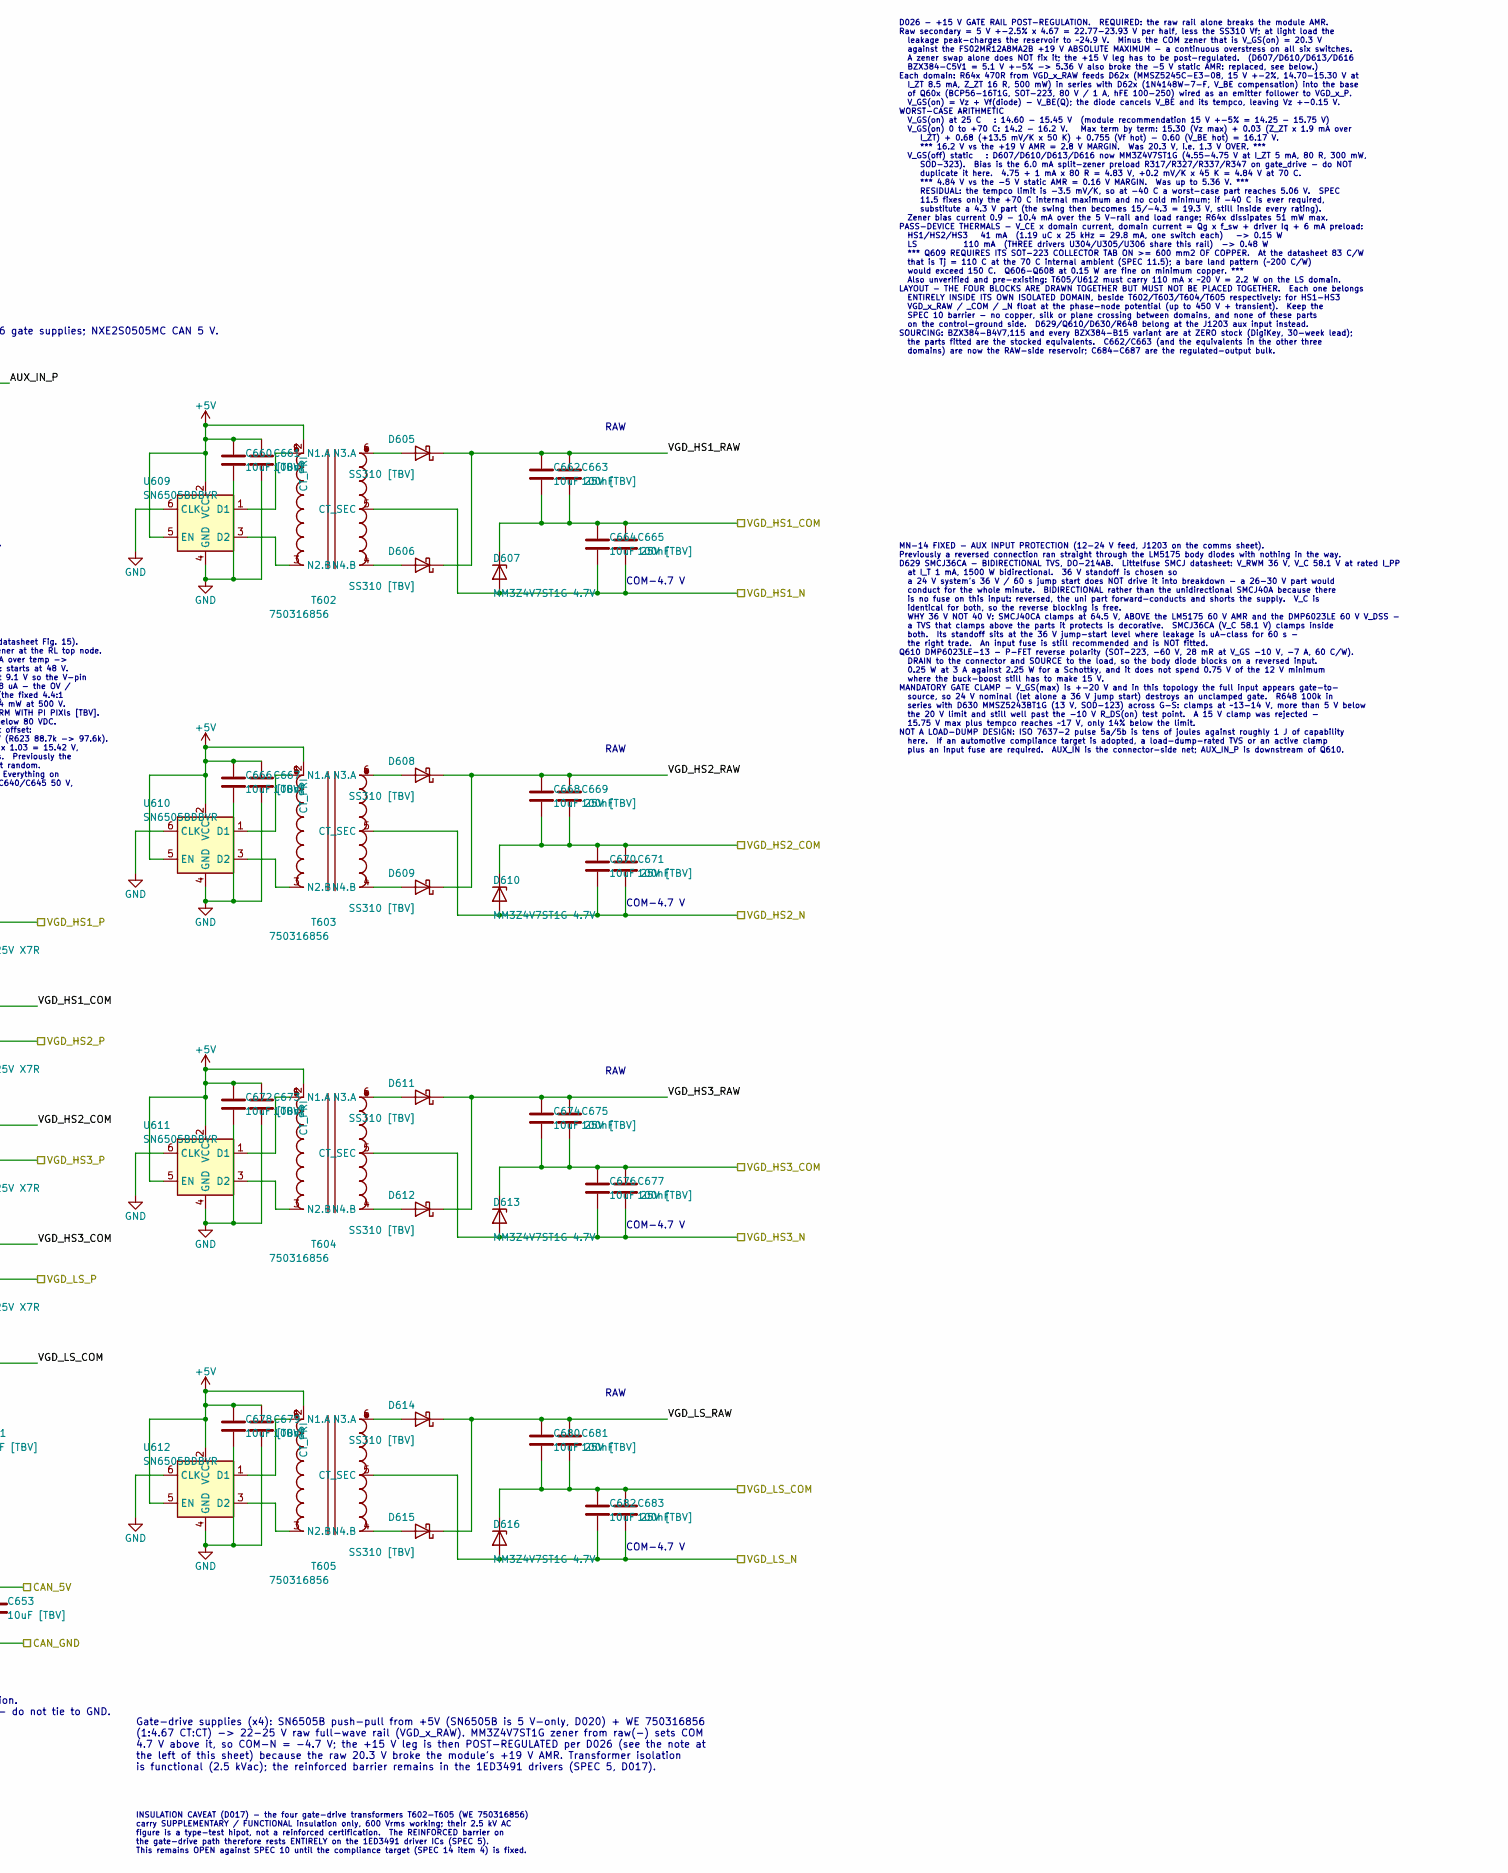
[picture p16: schematic aux_power.kicad_sch, MCU-C Integrated Inverter, part in row 1, column 2]

Parts:
C601, C602: 0.68uF 630VDC X2 film; C_Rect_L26.5mm_W10.5mm_P22.50mm_MKS4; Rating Radial box 26.5 x 16.5 x 10.5 mm, 22.5 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
C603: 6.8nF 630V C0G; C_1210_3225Metric; Rating TDK CGA5H4C0G2J682J115AE (DER-948Q clam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
C604, C640, C645: 10uF 50V X7R; C_1210_3225Metric
C606: 0.47uF 50V X7R; C_0805_2012Metric; Rating BPP: 0.47uF selects STANDARD ILIMIT (CR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
C607: 100nF 50V X7R; C_0805_2012Metric
C608: 1nF 200V C0G; C_0805_2012Metric
C609, C610: 220uF 25V polymer [TBV]; CP_Elec_8x10.5
C611, C622, C623, C642, C646, C661, C663, C665, C667, C669, C671, C673, C675, C677, C679, C681, C683: 100nF; C_0603_1608Metric
C612: 270pF; C_0603_1608Metric
C613, C625: 10nF [TBV]; C_0603_1608Metric
C614: 2.2uF 25V X7R; C_0805_2012Metric; Rating BPS: 0805 min per datasheet (>=1.5uF in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
C620, C621: 4.7uF 50V [TBV]; C_0805_2012Metric
C624: 4.7uF [TBV]; C_0603_1608Metric
C626: 100pF [TBV]; C_0603_1608Metric
C627: 47nF [TBV]; C_0603_1608Metric
C628: 130pF; C_0603_1608Metric
C629, C630, C643, C644, C647, C648: 22uF 25V [TBV]; C_1210_3225Metric
C631: 1uF [TBV]; C_0603_1608Metric
C641, C649: 220nF 50V X7R; C_0603_1608Metric
C650, C651, C653, C660, C666, C672, C678: 10uF [TBV]; C_0805_2012Metric
C652: 2.2uF [TBV]; C_0603_1608Metric
C654, C655: 1uF 16V X7R; C_0603_1608Metric
C662, C664, C668, C670, C674, C676, C680, C682: 10uF 25V [TBV]; C_0805_2012Metric
C684, C685, C686, C687: 10uF 25V X7R; C_0805_2012Metric
D601: US1M-class 1kV std recovery [TBV]; D_SMA
D602: BAS316-class [TBV]; D_SOD-323
D603: SS310-class 100V 3A [TBV]; D_SMC
D604: SS54 [TBV]; D_SMC
D605, D606, D608, D609, D611, D612, D614, D615: SS310 [TBV]; D_SMC
D607, D610, D613, D616: MM3Z4V7ST1G 4.7V; D_SOD-323
D620: BZX384-C9V1 [TBV]; D_SOD-323
D621, D622, D623, D624: MMSZ5245C-E3-08 15V 2%; D_SOD-123
D625, D626, D627, D628: 1N4148W-7-F; D_SOD-123
D629: SMCJ36CA; D_SMC
D630: MMSZ5243BT1G 13V; D_SOD-123
L601, L602: SRP6060FA-100M 10uH 7.6A; L_Bourns_SRP6060FA
L603: SRR1260-120M 12uH 5A; L_Bourns_SRR1260
Q601, Q602, Q603, Q604, Q605: CSD18543Q3A-class [TBV]; VSON-8_3.3x3.3mm_P0.65mm_NexFET
Q606, Q607, Q608, Q609: BCP56-16T1G; SOT-223-3_TabPin2
Q610: DMP6023LE-13; SOT-223-3_TabPin2
R603, R604, R612, R613, R614, R615: 39k; R_1206_3216Metric; Rating 0.5W 200V working (ROHM ESR18EZPJ393); Tolerance 5%
R605: 4.7R; R_1206_3216Metric; Rating 0.5W 200V working (ROHM ESR18EZPJ4R7)
R606: 8.2k [TBV]; R_0603_1608Metric
R607: 100R [TBV]; R_0603_1608Metric
R608: 10R; R_1206_3216Metric; Rating 0.5W 200V working (ROHM ESR18EZPJ100); 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
R609: 143k 1%; R_0603_1608Metric
R610: 13.2k 1%; R_0603_1608Metric
R611: 10k [TBV]; R_0603_1608Metric
R616, R617, R618, R619: 300k; R_1206_3216Metric; Tolerance 1%; Rating 0.5W 200V working (ROHM ESR18 class)
R620: 100k [TBV]; R_0603_1608Metric
R621: 16.2k [TBV]; R_0603_1608Metric
R622: 30mR 1%; R_2512_6332Metric
R623: 97.6k 1%; R_0603_1608Metric
R624: 4.99k 1%; R_0603_1608Metric
R625: 24.9k [TBV]; R_0603_1608Metric
R626: 84.5k (300kHz) [TBV]; R_0603_1608Metric
R627: 93.1k (CCM+hiccup) [TBV]; R_0603_1608Metric
R630: 210k; R_0603_1608Metric; Tolerance 1%; Rating 0.5W 200V working (ROHM ESR18EZPJ4R7)
R640, R642: 100k 1%; R_0603_1608Metric
R641: 24.9k 1%; R_0603_1608Metric
R643: 9.09k 1%; R_0603_1608Metric
R644, R645, R646, R647: 470R 1%; R_0603_1608Metric
R648: 100k; R_0603_1608Metric
T601: custom flyback per DER-948Q T1: Lp 422.6uH, 25T:2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; T_FLYBACK_EQ30
T602, T603, T604, T605: 750316856; WE_PPTI_750316856
U601: INN3990CQ; InSOP-24D
U603: LM5175RHFR; VQFN-28-1EP_4x5mm_P0.5mm_EP2.55x3.55mm
U604: LM74610QDGKRQ1; VSSOP-8_3x3mm_P0.65mm
U605, U606: LMR33630ADDAR; SOIC-8-1EP_3.9x4.9mm_P1.27mm_EP2.95x4.9mm_Mask2.71x3.4mm
U607: TLV1117-33; SOT-223-3_TabPin2
U608: NXE2S0505MC; Converter_DCDC_Murata_NXExSxxxxMC_SMD
U609, U610, U611, U612: SN6505BDBVR; SOT-23-6

Connections:
+3.3V: C651.1, U607.2 (VO); also elsewhere on the board
+5V: C643.1, C644.1, C650.1, C652.1, C660.1, C661.1, C666.1, C667.1, C672.1, C673.1, C678.1, C679.1, L602.2, R640.1, T602.2 (CT_PRI), T603.2 (CT_PRI), T604.2 (CT_PRI), T605.2 (CT_PRI), U607.3 (VI), U608.3 (+VIN), U609.2 (VCC), U609.5 (EN), U610.2 (VCC), U610.5 (EN), U611.2 (VCC), U611.5 (EN), U612.2 (VCC), U612.5 (EN); also elsewhere on the board
+12V: C647.1, C648.1, L603.2, R642.1; also elsewhere on the board
/AUX_IN: D629.1 (A1), Q610.2 (D); also elsewhere on the board
/Auxiliary power/AUX_15V: C640.1, C641.1, C645.1, C649.1, D604.1 (K), Q605.5 (D), U604.8 (CATHODE), U605.2 (VIN), U605.3 (EN), U606.2 (VIN), U606.3 (EN)
/Auxiliary power/AUX_IN_P: C620.1, C621.1, D630.1 (K), Q601.5 (D), Q610.3 (S), R620.1, U603.27 (VIN), U603.28 (VISNS)
/Auxiliary power/BB_15V: C629.1, C630.1, Q604.5 (D), Q605.1 (S), Q605.2 (S), Q605.3 (S), R623.1, U603.9 (VOSNS), U603.10 (ISNS(-)), U603.11 (ISNS(+)), U603.21 (BIAS), U604.4 (ANODE)
/Auxiliary power/BB_COMP: C626.1, R625.1, U603.6 (COMP)
/Auxiliary power/BB_CS: Q602.1 (S), Q602.2 (S), Q602.3 (S), Q603.1 (S), Q603.2 (S), Q603.3 (S), R622.1, U603.13 (CS)
/Auxiliary power/BB_FB: R623.2, R624.1, U603.8 (FB)
/Auxiliary power/BB_MODE: R627.1, U603.1 (MODE)
/Auxiliary power/BB_RT: R626.1, U603.3 (RT/SYNC)
/Auxiliary power/BB_SLOPE: C628.1, U603.4 (SLOPE)
/Auxiliary power/BB_SS: C627.1, U603.5 (SS)
/Auxiliary power/BB_SW1: C622.2, L601.1, Q601.1 (S), Q601.2 (S), Q601.3 (S), Q602.5 (D), U603.25 (SW1)
/Auxiliary power/BB_SW2: C623.2, L601.2, Q603.5 (D), Q604.1 (S), Q604.2 (S), Q604.3 (S), U603.15 (SW2)
/Auxiliary power/BB_VCC: C624.1, U603.20 (VCC)
/Auxiliary power/CLAMP_NODE: C603.2, R605.1, R614.2, R615.2
/Auxiliary power/DC_BUS_P: C601.1, C603.1, R603.1, R604.1, R616.1, T601.3 (PRI+); also elsewhere on the board
/Auxiliary power/FB_5V: R640.2, R641.1, U605.5 (FB)
/Auxiliary power/FB_12V: R642.2, R643.1, U606.5 (FB)
/Auxiliary power/FLY_15V: C608.2, C609.1, C610.1, C611.1, D603.1 (K), D604.2 (A), R609.1, R611.1, U601.6 (VOUT)
/Auxiliary power/VGD_HS1_RAW: C662.1, C663.1, D605.1 (K), D606.1 (K), Q606.2 (C), R644.1
/Auxiliary power/VGD_HS2_RAW: C668.1, C669.1, D608.1 (K), D609.1 (K), Q607.2 (C), R645.1
/Auxiliary power/VGD_HS3_RAW: C674.1, C675.1, D611.1 (K), D612.1 (K), Q608.2 (C), R646.1
/Auxiliary power/VGD_LS_RAW: C680.1, C681.1, D614.1 (K), D615.1 (K), Q609.2 (C), R647.1
/Auxiliary power/V_SENSE: R630.1, U601.13 (V)
/Precharge and contactor/DC_BUS_N: C602.2, C604.2, C606.2, C607.2, D620.2 (A), T601.5 (BIAS-), U601.16 (S), U601.17 (S), U601.18 (S), U601.19 (S); also elsewhere on the board
/VGD_HS1_COM: C662.2, C663.2, C664.1, C665.1, C684.2, D607.1 (K), D621.2 (A); also elsewhere on the board
/VGD_HS1_N: C664.2, C665.2, D607.2 (A), T602.5 (CT_SEC); also elsewhere on the board
/VGD_HS1_P: C684.1, Q606.3 (E); also elsewhere on the board
/VGD_HS2_COM: C668.2, C669.2, C670.1, C671.1, C685.2, D610.1 (K), D622.2 (A); also elsewhere on the board
/VGD_HS2_N: C670.2, C671.2, D610.2 (A), T603.5 (CT_SEC); also elsewhere on the board
/VGD_HS2_P: C685.1, Q607.3 (E); also elsewhere on the board
/VGD_HS3_COM: C674.2, C675.2, C676.1, C677.1, C686.2, D613.1 (K), D623.2 (A); also elsewhere on the board
/VGD_HS3_N: C676.2, C677.2, D613.2 (A), T604.5 (CT_SEC); also elsewhere on the board
/VGD_HS3_P: C686.1, Q608.3 (E); also elsewhere on the board
/VGD_LS_COM: C680.2, C681.2, C682.1, C683.1, C687.2, D616.1 (K), D624.2 (A); also elsewhere on the board
/VGD_LS_N: C682.2, C683.2, D616.2 (A), T605.5 (CT_SEC); also elsewhere on the board
/VGD_LS_P: C687.1, Q609.3 (E); also elsewhere on the board
GND: C609.2, C610.2, C611.2, C612.2, C614.2, C620.2, C621.2, C624.2, C625.2, C626.2, C627.2, C628.2, C629.2, C630.2, C640.2, C641.2, C643.2, C644.2, C645.2, C647.2, C648.2, C649.2, C650.2, C651.2, C652.2, C654.2, C655.2, C660.2, C661.2, C666.2, C667.2, C672.2, C673.2, C678.2, C679.2, D629.2 (A2), R610.2, R621.2, R622.2, R624.2, R626.2, R627.2, R641.2, R643.2, R648.2, T601.9 (SEC-), U601.1 (IS), U601.2 (GND), U601.5 (SR), U603.2 (DITH), U603.7 (AGND), U603.12 (CSG), U603.19 (PGND), U603.29 (PowerPAD), U605.1 (PGND), U605.9 (AGND), U606.1 (PGND), U606.9 (AGND), U607.1 (GND), U608.1 (-VIN), U609.4 (GND), U609.6 (CLK), U610.4 (GND), U610.6 (CLK), U611.4 (GND), U611.6 (CLK), U612.4 (GND), U612.6 (CLK); also elsewhere on the board
unnamed: C601.2, C602.1
unnamed: C608.1, R608.2
unnamed: C613.1, R611.2
unnamed: C625.1, R625.2
unnamed: D601.2 (A), T601.1 (PRI-), U601.24 (D)
unnamed: D601.1 (K), R605.2
unnamed: D602.2 (A), T601.6 (BIAS+)
unnamed: C604.1, D602.1 (K), R606.1
unnamed: D603.2 (A), R607.1, R608.1, T601.8 (SEC+)
unnamed: D605.2 (A), T602.6 (N3.A)
unnamed: D606.2 (A), T602.4 (N4.B)
unnamed: D608.2 (A), T603.6 (N3.A)
unnamed: D609.2 (A), T603.4 (N4.B)
unnamed: D611.2 (A), T604.6 (N3.A)
unnamed: D612.2 (A), T604.4 (N4.B)
unnamed: D614.2 (A), T605.6 (N3.A)
unnamed: D615.2 (A), T605.4 (N4.B)
unnamed: D620.1 (K), R619.2, R630.2
unnamed: D621.1 (K), D625.1 (K)
unnamed: D622.1 (K), D626.1 (K)
unnamed: D623.1 (K), D627.1 (K)
unnamed: D624.1 (K), D628.1 (K)
unnamed: D625.2 (A), Q606.1 (B), R644.2
unnamed: D626.2 (A), Q607.1 (B), R645.2
unnamed: D627.2 (A), Q608.1 (B), R646.2
unnamed: D628.2 (A), Q609.1 (B), R647.2
unnamed: D630.2 (A), Q610.1 (G), R648.1
unnamed: Q601.4 (G), U603.24 (HDRV1)
unnamed: Q602.4 (G), U603.22 (LDRV1)
unnamed: Q603.4 (G), U603.18 (LDRV2)
unnamed: Q604.4 (G), U603.16 (HDRV2)
unnamed: Q605.4 (G), U604.2 (GATE_PD), U604.6 (GATE_DRV)
unnamed: R603.2, R604.2, R612.1, R613.1
unnamed: R612.2, R613.2, R614.1, R615.1
unnamed: R616.2, R617.1
unnamed: R617.2, R618.1
unnamed: R618.2, R619.1
unnamed: T602.1 (N1.A), U609.1 (D1)
unnamed: T602.3 (N2.B), U609.3 (D2)
unnamed: T603.1 (N1.A), U610.1 (D1)
unnamed: T603.3 (N2.B), U610.3 (D2)
unnamed: T604.1 (N1.A), U611.1 (D1)
unnamed: T604.3 (N2.B), U611.3 (D2)
unnamed: T605.1 (N1.A), U612.1 (D1)
unnamed: T605.3 (N2.B), U612.3 (D2)
unnamed: C606.1, C607.1, R606.2, U601.14 (BPP)
unnamed: C614.1, U601.4 (BPS)
unnamed: C612.1, C613.2, R609.2, R610.1, U601.3 (FB)
unnamed: R607.2, U601.7 (FWD)
unnamed: C622.1, U603.23 (BOOT1)
unnamed: C623.1, U603.17 (BOOT2)
unnamed: R620.2, R621.1, U603.26 (EN/UVLO)
unnamed: C631.1, U604.7 (VCAPH)
unnamed: C631.2, U604.1 (VCAPL)
unnamed: C642.1, U605.7 (BOOT)
unnamed: C642.2, L602.1, U605.8 (SW)
unnamed: C654.1, U605.6 (VCC)
unnamed: C646.1, U606.7 (BOOT)
unnamed: C646.2, L603.1, U606.8 (SW)
unnamed: C655.1, U606.6 (VCC)

Notes on the sheet:
Auxiliary power
SPEC.md 11.2b - DECISIONS.md D020. HV flyback (INN3990CQ) -> 15 V main rail; LM5175 buck-boost from 12-24 V AUX_IN OR'd in via LM74610 smart diode; LMR51430 bucks -> 5 V / 12 V; TLV1117 -> 3.3 V; 4x SN6505B+750316856 gate supplies; NXE2S0505MC CAN 5 V.
ISOLATION: primary side of T601 floats at HV bus potential (48-450 V, 500 V transient). Spacing per SPEC 10: >=3.2 mm clearance / >=6.4 mm creepage power->control, T601 reinforced >=4 kV. FluxLink feedback is internal to U601 (no optocoupler). Film caps C601/C602 in series so no single part spans t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
SR pin tied to GND: diode-only rectification (datasheet: 'If no SR FET is used connect this pin to GND'). IS tied to GND: no CC regulation. FB divider 143k/13.2k @ 1.265 V ref -> 14.97 V. Feed-forward 10k + 10 nF per Fig 10.
D604 SS54: plain Schottky OR from flyback into AUX_15V. Penalty ~0.4 V / ~0.7 W at 1.7 A. Upgrade: second LM74610+FET stage [TBV]. Flyback is the primary source; the LM5175 aux path carries the board only when the 12-24 V feed is present (15.02 V > 14.97 - 0.4 V).
Primary OVP chain (not fitted - note per datasheet): zener + series R + blocking diode from the rectified bias rail into BPP triggers latching OVP at ISD. Fit if secondary OVP insufficient [TBV].
AUX input: LM5175 4-switch buck-boost, 12-24 V in -> 15.02 V (FB 88.7k/4.99k @ 0.8 V). fsw 300 kHz (RT 84.5k), CCM+hiccup (MODE 93.1k), all loop/support values [TBV]. EN divider 100k/16.2k -> input UVLO ~8.9 V [TBV]. ISNS+/- shorted (CC loop disabled).
Gate-drive supplies (x4): SN6505B push-pull from +5V (SN6505B is 5 V-only, D020) + WE 750316856 (1:4.67 CT:CT) -> 22-25 V raw full-wave rail (VGD_x_RAW). MM3Z4V7ST1G zener from raw(-) sets COM 4.7 V above it, so COM-N = -4.7 V; the +15 V leg is then POST-REGULATED per D026 (see the note at the left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
+5V / +12V / +3.3V / GND are global power rails sourced on this sheet (PWR_FLAG on +5V here; +12V flagged on precharge sheet, +3.3V and GND flagged on MCU sheet - no duplicates).
CAN supply: functional 3 kVDC isolation. CAN_GND is the isolated CAN return - do not tie to GND.
RAW
COM-4.7 V
MJ-14 FIXED - line UV sense fitted (clamped network, InnoSwitch3-AQ datasheet Fig. 15). R616-R619 4x 300k (RU = 1.20 M) + R630 210k (RL) + D620 9.1 V zener at the RL top node. Brown-in V_UV+ = I_UV+ x (RU+RL) + 1.37 V; I_UV+ 22.1/26.1/30.4 uA over temp -> 32.5 / 38.2 / 44.2 V. Max 44.2 V < the 48 V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
CR-4 FIXED - RCD clamp respec. R603/R604/R612-R615 = 6x 39k 1206 (0.5 W, 200 V working, ROHM ESR18 class) wired 3 series x 2 parallel = 58.5 k. Old build was 2x 390k 0603 in parallel (195 k) on parts rated 75 V / 0.1 W - 3-5x over voltage and over power. V_OR = 15.5 V x 12.5 = 194 V. P_leak = 0.5 x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
CR-5 FIXED - core saturation at the current limit. C606 (BPP) 4.7 uF -> 0.47 uF, which selects the STANDARD I_LIMIT instead of I_LIMIT+1. Controller stays INN3990CQ. B_pk = Lp x I_LIM / (Np x Ae) = 422.6 uH x I / (25 x 108 mm^2) = 0.1565 T/A: was 4.7 uF -> I_LIMIT+1 2.576 A typ / 2.886 A worst -> 4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
MJ-19 - aux input priority (D020) now actually implemented by setpoint offset: flyback 14.97 V (R609/R610 143k/13.2k @ 1.265 V) vs LM5175 16.45 V (R623 88.7k -> 97.6k). Worst case: LM5175 min 16.45 x 0.975 = 16.04 V > flyback max 14.97 x 1.03 = 15.42 V, margin 0.62 V - the aux unit always holds the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
INSULATION CAVEAT (D017) - the four gate-drive transformers T602-T605 (WE 750316856) carry SUPPLEMENTARY / FUNCTIONAL insulation only, 600 Vrms working; their 2.5 kV AC figure is a type-test hipot, not a reinforced certification. The REINFORCED barrier on the gate-drive path therefore rests ENTIREL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
HS1 +15 V post-regulator (D026)
HS2 +15 V post-regulator (D026)
HS3 +15 V post-regulator (D026)
LS +15 V post-regulator (D026)
D026 - +15 V GATE RAIL POST-REGULATION. REQUIRED: the raw rail alone breaks the module AMR. Raw secondary = 5 V +-2.5% x 4.67 = 22.77-23.93 V per half, less the SS310 Vf; at light load the leakage peak-charges the reservoir to ~24.9 V. Minus the COM zener that is V_GS(on) = 20.3 V against the FS02M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
MN-14 FIXED - AUX INPUT PROTECTION (12-24 V feed, J1203 on the comms sheet). Previously a reversed connection ran straight through the LM5175 body diodes with nothing in the way. D629 SMCJ36CA - BIDIRECTIONAL TVS, DO-214AB. Littelfuse SMCJ datasheet: V_RWM 36 V, V_C 58.1 V at rated I_PP at I_T 1 mA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
