aratzps/MCU-C/mcuc_inverter/mcuc_inverter.kicad_pcb

## KiCad design mcuc_inverter/mcuc_inverter.kicad_pcb (continued)

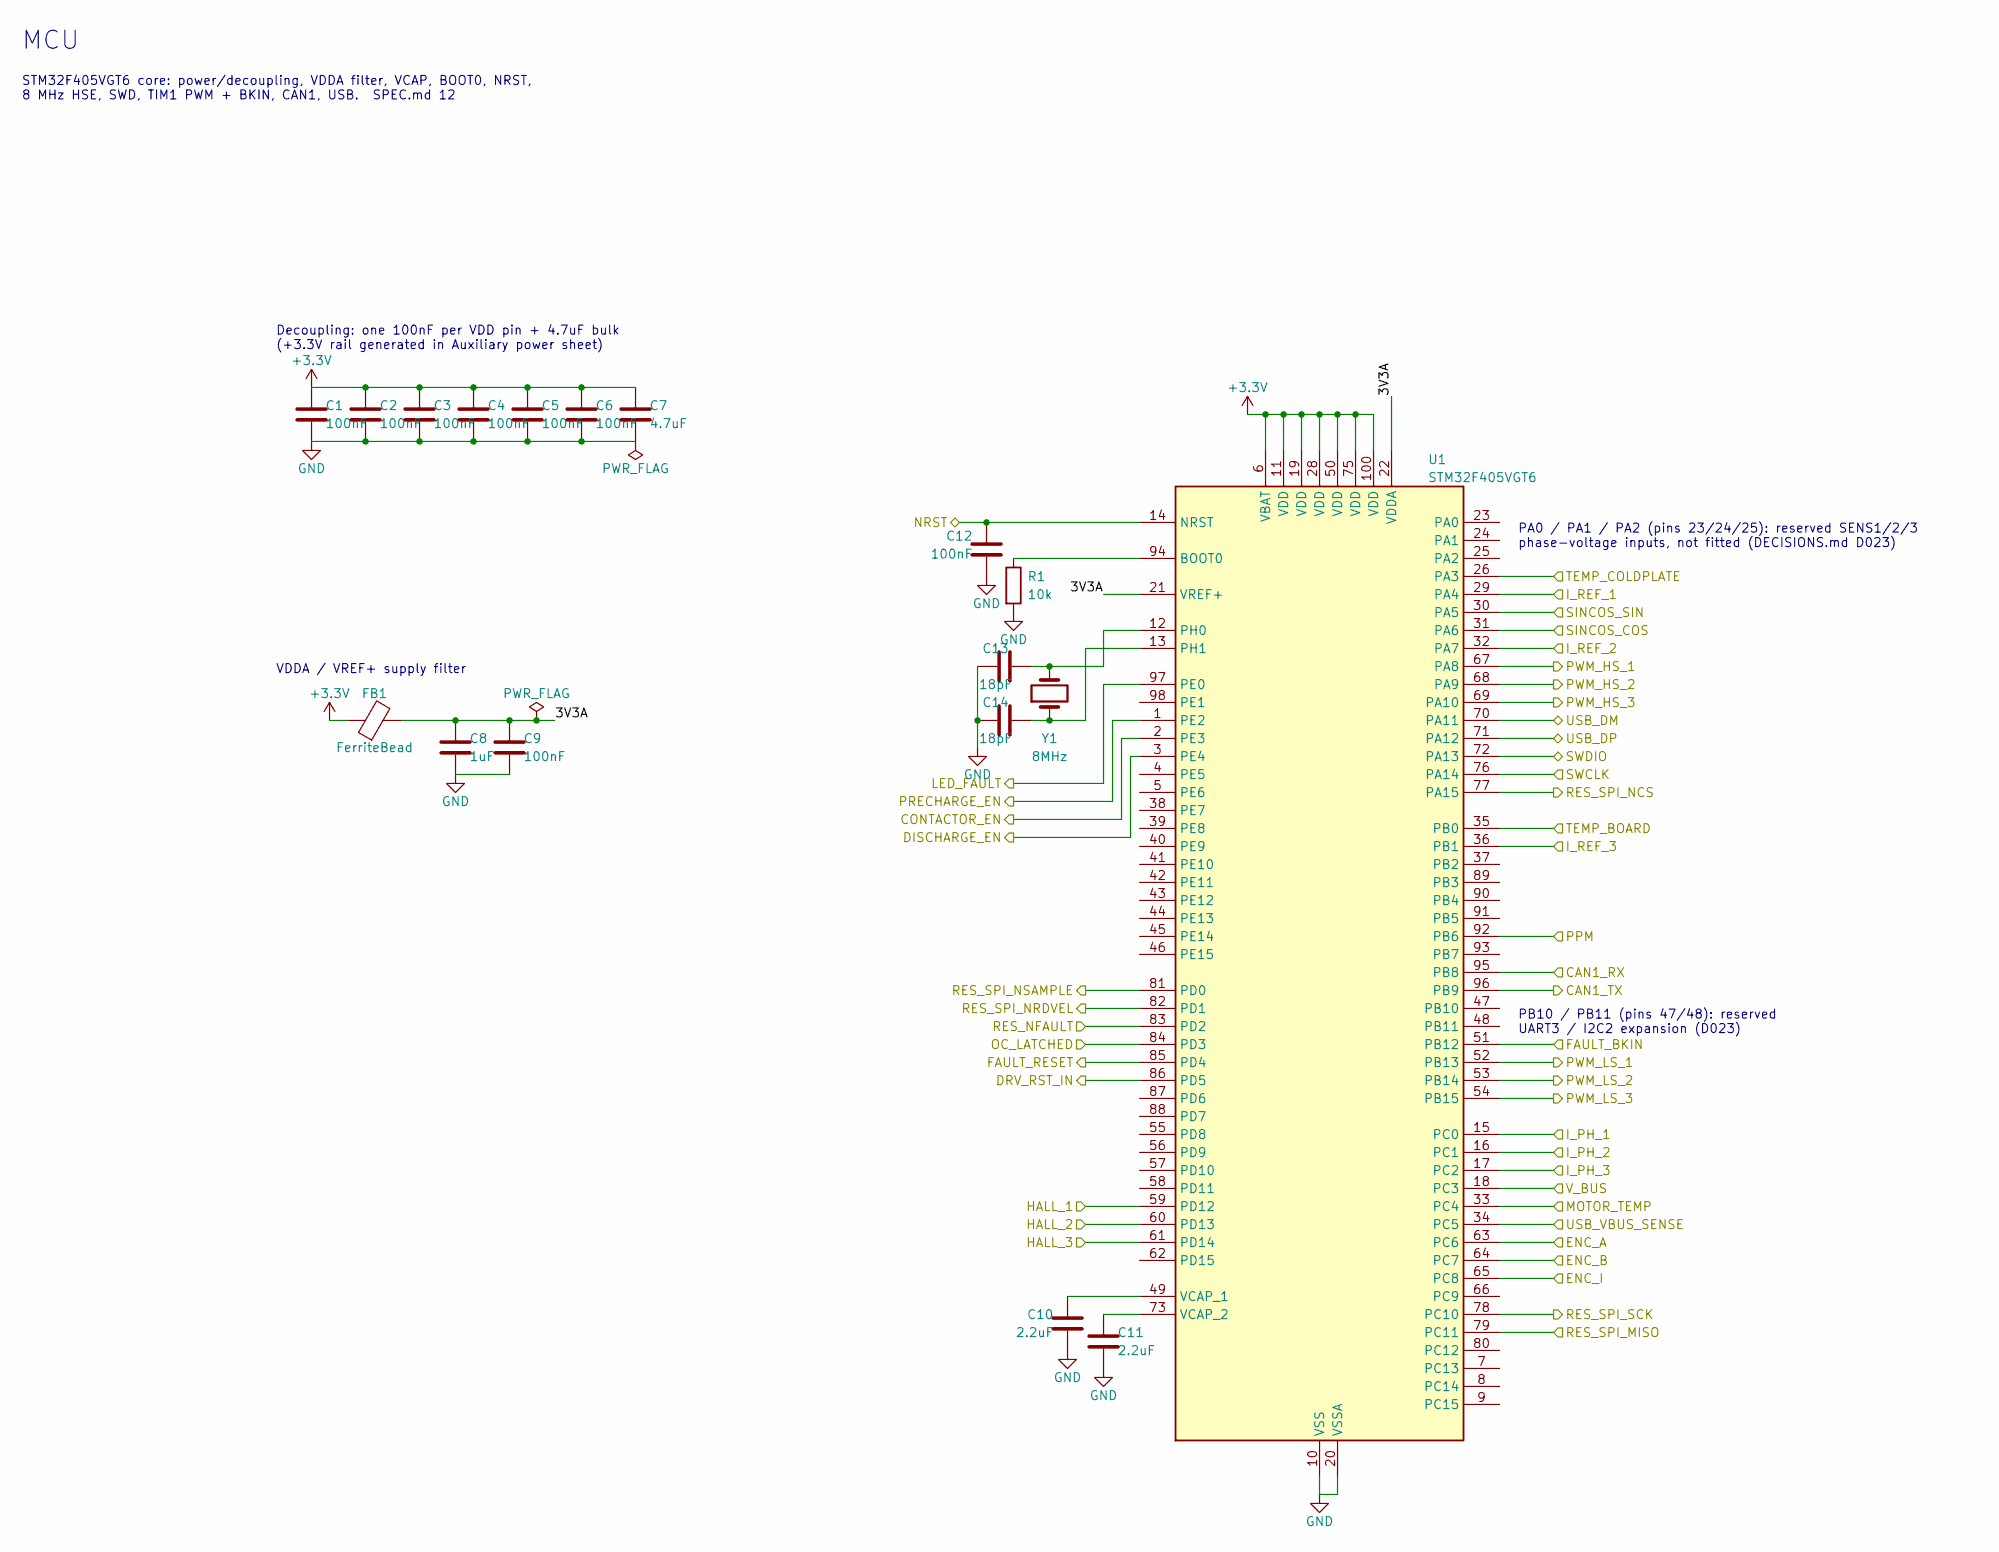
[picture p17: schematic mcu.kicad_sch, MCU-C Integrated Inverter]

Parts:
C1, C2, C3, C4, C5, C6, C9, C12: 100nF; C_0603_1608Metric
C7: 4.7uF; C_0805_2012Metric
C8: 1uF; C_0603_1608Metric
C10, C11: 2.2uF; C_0805_2012Metric
C13, C14: 18pF; C_0603_1608Metric
FB1: FerriteBead; L_0805_2012Metric
R1: 10k; R_0603_1608Metric
U1: STM32F405VGT6; LQFP-100_14x14mm_P0.5mm
Y1: 8MHz; Crystal_SMD_5032-2Pin_5.0x3.2mm

Connections:
+3.3V: C1.1, C2.1, C3.1, C4.1, C5.1, C6.1, C7.1, FB1.1, U1.6 (VBAT), U1.11 (VDD), U1.19 (VDD), U1.28 (VDD), U1.50 (VDD), U1.75 (VDD), U1.100 (VDD); also elsewhere on the board
/CAN1_RX: U1.95 (PB8); also elsewhere on the board
/CAN1_TX: U1.96 (PB9); also elsewhere on the board
/CONTACTOR_EN: U1.2 (PE3); also elsewhere on the board
/DISCHARGE_EN: U1.3 (PE4); also elsewhere on the board
/DRV_RST_IN: U1.86 (PD5); also elsewhere on the board
/ENC_A: U1.63 (PC6); also elsewhere on the board
/ENC_B: U1.64 (PC7); also elsewhere on the board
/ENC_I: U1.65 (PC8); also elsewhere on the board
/FAULT_RESET: U1.85 (PD4); also elsewhere on the board
/HALL_1: U1.59 (PD12); also elsewhere on the board
/HALL_2: U1.60 (PD13); also elsewhere on the board
/HALL_3: U1.61 (PD14); also elsewhere on the board
/I_PH_1: U1.15 (PC0); also elsewhere on the board
/I_PH_2: U1.16 (PC1); also elsewhere on the board
/I_PH_3: U1.17 (PC2); also elsewhere on the board
/I_REF_1: U1.29 (PA4); also elsewhere on the board
/I_REF_2: U1.32 (PA7); also elsewhere on the board
/I_REF_3: U1.36 (PB1); also elsewhere on the board
/LED_FAULT: U1.97 (PE0); also elsewhere on the board
/MCU/3V3A: C8.1, C9.1, FB1.2, U1.21 (VREF+), U1.22 (VDDA)
/MCU/PWM_HS_1: U1.67 (PA8); also elsewhere on the board
/MCU/PWM_HS_2: U1.68 (PA9); also elsewhere on the board
/MCU/PWM_HS_3: U1.69 (PA10); also elsewhere on the board
/MCU/PWM_LS_1: U1.52 (PB13); also elsewhere on the board
/MCU/PWM_LS_2: U1.53 (PB14); also elsewhere on the board
/MCU/PWM_LS_3: U1.54 (PB15); also elsewhere on the board
/MOTOR_TEMP: U1.33 (PC4); also elsewhere on the board
/NRST: C12.1, U1.14 (NRST); also elsewhere on the board
/OC_LATCHED: U1.84 (PD3); also elsewhere on the board
/PPM: U1.92 (PB6); also elsewhere on the board
/PRECHARGE_EN: U1.1 (PE2); also elsewhere on the board
/RES_NFAULT: U1.83 (PD2); also elsewhere on the board
/RES_SPI_MISO: U1.79 (PC11); also elsewhere on the board
/RES_SPI_NCS: U1.77 (PA15); also elsewhere on the board
/RES_SPI_NRDVEL: U1.82 (PD1); also elsewhere on the board
/RES_SPI_NSAMPLE: U1.81 (PD0); also elsewhere on the board
/RES_SPI_SCK: U1.78 (PC10); also elsewhere on the board
/SINCOS_COS: U1.31 (PA6); also elsewhere on the board
/SINCOS_SIN: U1.30 (PA5); also elsewhere on the board
/SWCLK: U1.76 (PA14); also elsewhere on the board
/SWDIO: U1.72 (PA13); also elsewhere on the board
/Supervisor and interlocks/FAULT_BKIN: U1.51 (PB12); also elsewhere on the board
/TEMP_BOARD: U1.35 (PB0); also elsewhere on the board
/TEMP_COLDPLATE: U1.26 (PA3); also elsewhere on the board
/USB_DM: U1.70 (PA11); also elsewhere on the board
/USB_DP: U1.71 (PA12); also elsewhere on the board
/USB_VBUS_SENSE: U1.34 (PC5); also elsewhere on the board
/V_BUS: U1.18 (PC3); also elsewhere on the board
GND: C1.2, C2.2, C3.2, C4.2, C5.2, C6.2, C7.2, C8.2, C9.2, C10.2, C11.2, C12.2, C13.1, C14.1, R1.2, U1.10 (VSS), U1.20 (VSSA), U1.27 (VSS), U1.74 (VSS), U1.99 (VSS); also elsewhere on the board
unnamed: R1.1, U1.94 (BOOT0)
unnamed: C13.2, U1.12 (PH0), Y1.2
unnamed: C14.2, U1.13 (PH1), Y1.1
unnamed: C10.1, U1.49 (VCAP_1)
unnamed: C11.1, U1.73 (VCAP_2)

Notes on the sheet:
MCU
STM32F405VGT6 core: power/decoupling, VDDA filter, VCAP, BOOT0, NRST, 8 MHz HSE, SWD, TIM1 PWM + BKIN, CAN1, USB. SPEC.md 12
Decoupling: one 100nF per VDD pin + 4.7uF bulk (+3.3V rail generated in Auxiliary power sheet)
VDDA / VREF+ supply filter
PA0 / PA1 / PA2 (pins 23/24/25): reserved SENS1/2/3 phase-voltage inputs, not fitted (DECISIONS.md D023)
PB10 / PB11 (pins 47/48): reserved UART3 / I2C2 expansion (D023)

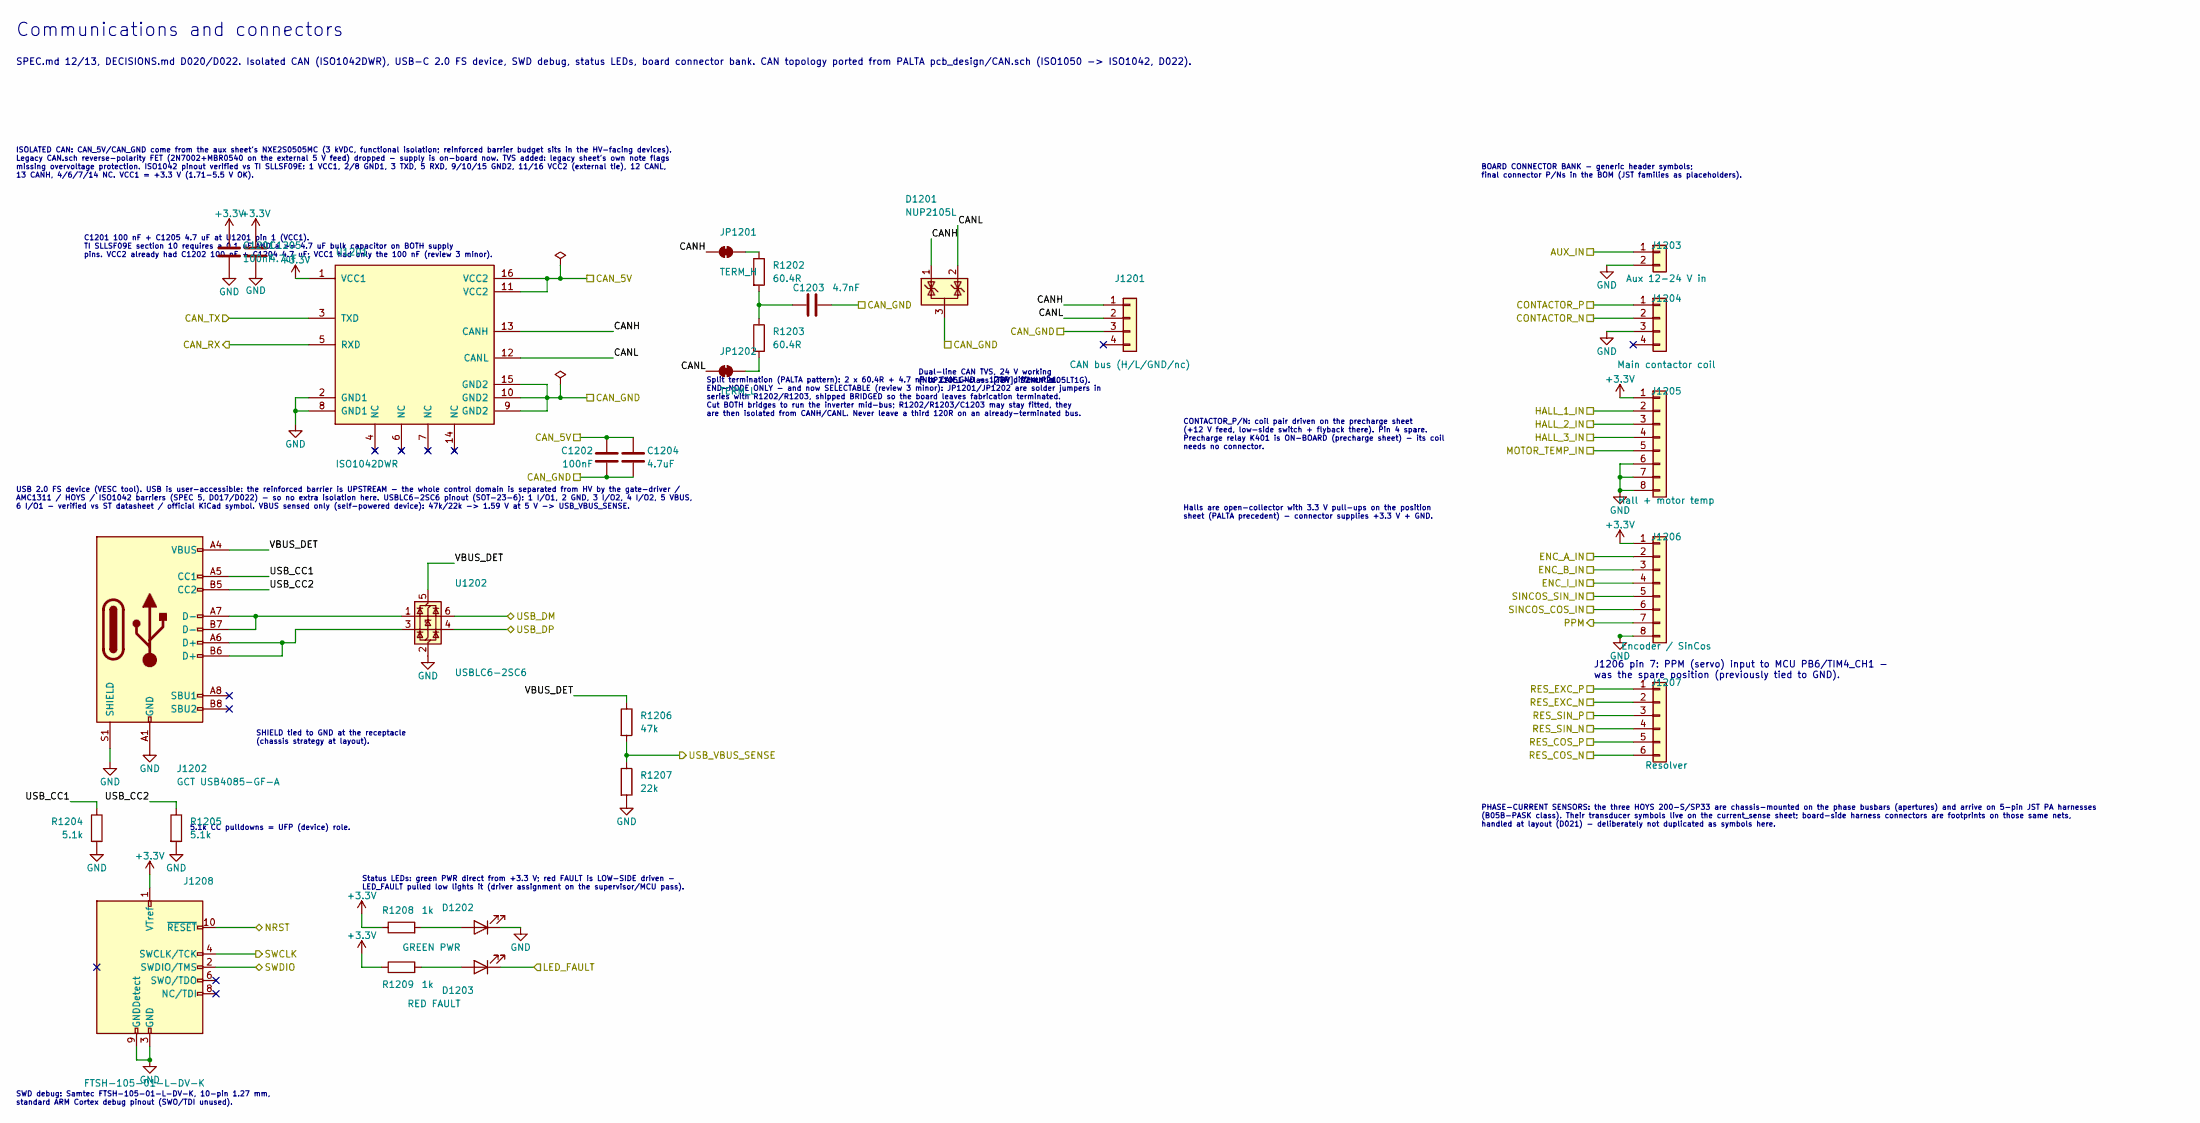
[picture p18: schematic comms.kicad_sch, MCU-C Integrated Inverter]

Parts:
C1201, C1202: 100nF; C_0603_1608Metric
C1203: 4.7nF; C_0603_1608Metric
C1204, C1205: 4.7uF; C_0805_2012Metric
D1201: NUP2105L; SOT-23
D1202: GREEN PWR; LED_0805_2012Metric
D1203: RED FAULT; LED_0805_2012Metric
J1201: CAN bus (H/L/GND/nc); JST_PH_B4B-PH-K_1x04_P2.00mm_Vertical
J1202: GCT USB4085-GF-A; USB_C_Receptacle_GCT_USB4085
J1203: Aux 12-24 V in; JST_VH_B2P-VH_1x02_P3.96mm_Vertical
J1204: Main contactor coil; JST_VH_B4P-VH_1x04_P3.96mm_Vertical
J1205: Hall + motor temp; JST_SH_SM08B-SRSS-TB_1x08-1MP_P1.00mm_Horizontal
J1206: Encoder / SinCos; JST_SH_SM08B-SRSS-TB_1x08-1MP_P1.00mm_Horizontal
J1207: Resolver; JST_SH_SM06B-SRSS-TB_1x06-1MP_P1.00mm_Horizontal
J1208: FTSH-105-01-L-DV-K; PinHeader_2x05_P1.27mm_Vertical_SMD
JP1201: TERM_H; SolderJumper-2_P1.3mm_Bridged_RoundedPad1.0x1.5mm
JP1202: TERM_L; SolderJumper-2_P1.3mm_Bridged_RoundedPad1.0x1.5mm
R1202, R1203: 60.4R; R_0603_1608Metric
R1204, R1205: 5.1k; R_0603_1608Metric
R1206: 47k; R_0603_1608Metric
R1207: 22k; R_0603_1608Metric
R1208, R1209: 1k; R_0603_1608Metric
U1201: ISO1042DWR; SOIC-16W_7.5x10.3mm_P1.27mm
U1202: USBLC6-2SC6; SOT-23-6

Connections:
+3.3V: C1201.1, C1205.1, J1205.1, J1206.1, J1208.1 (VTref), R1208.1, R1209.1, U1201.1 (VCC1); also elsewhere on the board
+12V: J1204.1; also elsewhere on the board
/AUX_IN: J1203.1; also elsewhere on the board
/CAN1_RX: U1201.5 (RXD); also elsewhere on the board
/CAN1_TX: U1201.3 (TXD); also elsewhere on the board
/CONTACTOR_N: J1204.2; also elsewhere on the board
/Communications/CANH: D1201.1 (K), J1201.1, JP1201.1 (A), U1201.13 (CANH)
/Communications/CANL: D1201.2 (K), J1201.2, JP1202.1 (A), U1201.12 (CANL)
/Communications/ENC_A_IN: J1206.2; also elsewhere on the board
/Communications/ENC_B_IN: J1206.3; also elsewhere on the board
/Communications/ENC_I_IN: J1206.4; also elsewhere on the board
/Communications/HALL_1_IN: J1205.2; also elsewhere on the board
/Communications/HALL_2_IN: J1205.3; also elsewhere on the board
/Communications/HALL_3_IN: J1205.4; also elsewhere on the board
/Communications/RES_COS_N: J1207.6; also elsewhere on the board
/Communications/RES_COS_P: J1207.5; also elsewhere on the board
/Communications/RES_EXC_N: J1207.2; also elsewhere on the board
/Communications/RES_EXC_P: J1207.1; also elsewhere on the board
/Communications/RES_SIN_N: J1207.4; also elsewhere on the board
/Communications/RES_SIN_P: J1207.3; also elsewhere on the board
/Communications/SINCOS_COS_IN: J1206.6; also elsewhere on the board
/Communications/SINCOS_SIN_IN: J1206.5; also elsewhere on the board
/Communications/USB_CC1: J1202.A5 (CC1), R1204.1
/Communications/USB_CC2: J1202.B5 (CC2), R1205.1
/Communications/VBUS_DET: J1202.A4 (VBUS), J1202.A9 (VBUS), J1202.B4 (VBUS), J1202.B9 (VBUS), R1206.1, U1202.5 (VBUS)
/LED_FAULT: D1203.1 (K); also elsewhere on the board
/MOTOR_TEMP: J1205.5; also elsewhere on the board
/NRST: J1208.10 (~RESET); also elsewhere on the board
/PPM: J1206.7; also elsewhere on the board
/SWCLK: J1208.4 (SWCLK/TCK); also elsewhere on the board
/SWDIO: J1208.2 (SWDIO/TMS); also elsewhere on the board
/USB_DM: U1202.6 (I/O1); also elsewhere on the board
/USB_DP: U1202.4 (I/O2); also elsewhere on the board
/USB_VBUS_SENSE: R1206.2, R1207.1; also elsewhere on the board
GND: C1201.2, C1205.2, D1202.1 (K), J1202.A1 (GND), J1202.A12 (GND), J1202.B1 (GND), J1202.B12 (GND), J1202.S1 (SHIELD), J1203.2, J1204.3, J1205.6, J1205.7, J1205.8, J1206.8, J1208.3 (GND), J1208.5 (GND), J1208.9 (GNDDetect), R1204.2, R1205.2, R1207.2, U1201.2 (GND1), U1201.8 (GND1), U1202.2 (GND); also elsewhere on the board
unnamed: C1203.1, R1202.2, R1203.1
unnamed: D1202.2 (A), R1208.2
unnamed: D1203.2 (A), R1209.2
unnamed: J1202.A6 (D+), J1202.B6 (D+), U1202.3 (I/O2)
unnamed: J1202.A7 (D-), J1202.B7 (D-), U1202.1 (I/O1)
unnamed: JP1201.2 (B), R1202.1
unnamed: JP1202.2 (B), R1203.2

Notes on the sheet:
Communications and connectors
SPEC.md 12/13, DECISIONS.md D020/D022. Isolated CAN (ISO1042DWR), USB-C 2.0 FS device, SWD debug, status LEDs, board connector bank. CAN topology ported from PALTA pcb_design/CAN.sch (ISO1050 -> ISO1042, D022).
ISOLATED CAN: CAN_5V/CAN_GND come from the aux sheet's NXE2S0505MC (3 kVDC, functional isolation; reinforced barrier budget sits in the HV-facing devices). Legacy CAN.sch reverse-polarity FET (2N7002+MBR0540 on the external 5 V feed) dropped - supply is on-board now. TVS added: legacy sheet's own n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
C1201 100 nF + C1205 4.7 uF at U1201 pin 1 (VCC1). TI SLLSF09E section 10 requires a 0.1 uF AND a >= 4.7 uF bulk capacitor on BOTH supply pins. VCC2 already had C1202 100 nF + C1204 4.7 uF; VCC1 had only the 100 nF (review 3 minor).
Split termination (PALTA pattern): 2 x 60.4R + 4.7 nF to CAN_GND = 120R differential. END-NODE ONLY - and now SELECTABLE (review 3 minor): JP1201/JP1202 are solder jumpers in series with R1202/R1203, shipped BRIDGED so the board leaves fabrication terminated. Cut BOTH bridges to run the inverter mi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
Dual-line CAN TVS, 24 V working (NUP2105L-class [TBV], SZNUP2105LT1G).
USB 2.0 FS device (VESC tool). USB is user-accessible: the reinforced barrier is UPSTREAM - the whole control domain is separated from HV by the gate-driver / AMC1311 / HOYS / ISO1042 barriers (SPEC 5, D017/D022) - so no extra isolation here. USBLC6-2SC6 pinout (SOT-23-6): 1 I/O1, 2 GND, 3 I/O2, 4 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
5.1k CC pulldowns = UFP (device) role.
SHIELD tied to GND at the receptacle (chassis strategy at layout).
SWD debug: Samtec FTSH-105-01-L-DV-K, 10-pin 1.27 mm, standard ARM Cortex debug pinout (SWO/TDI unused).
Status LEDs: green PWR direct from +3.3 V; red FAULT is LOW-SIDE driven - LED_FAULT pulled low lights it (driver assignment on the supervisor/MCU pass).
BOARD CONNECTOR BANK - generic header symbols; final connector P/Ns in the BOM (JST families as placeholders).
CONTACTOR_P/N: coil pair driven on the precharge sheet (+12 V feed, low-side switch + flyback there). Pin 4 spare. Precharge relay K401 is ON-BOARD (precharge sheet) - its coil needs no connector.
Halls are open-collector with 3.3 V pull-ups on the position sheet (PALTA precedent) - connector supplies +3.3 V + GND.
PHASE-CURRENT SENSORS: the three HOYS 200-S/SP33 are chassis-mounted on the phase busbars (apertures) and arrive on 5-pin JST PA harnesses (B05B-PASK class). Their transducer symbols live on the current_sense sheet; board-side harness connectors are footprints on those same nets, handled at layout 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
J1206 pin 7: PPM (servo) input to MCU PB6/TIM4_CH1 - was the spare position (previously tied to GND).

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
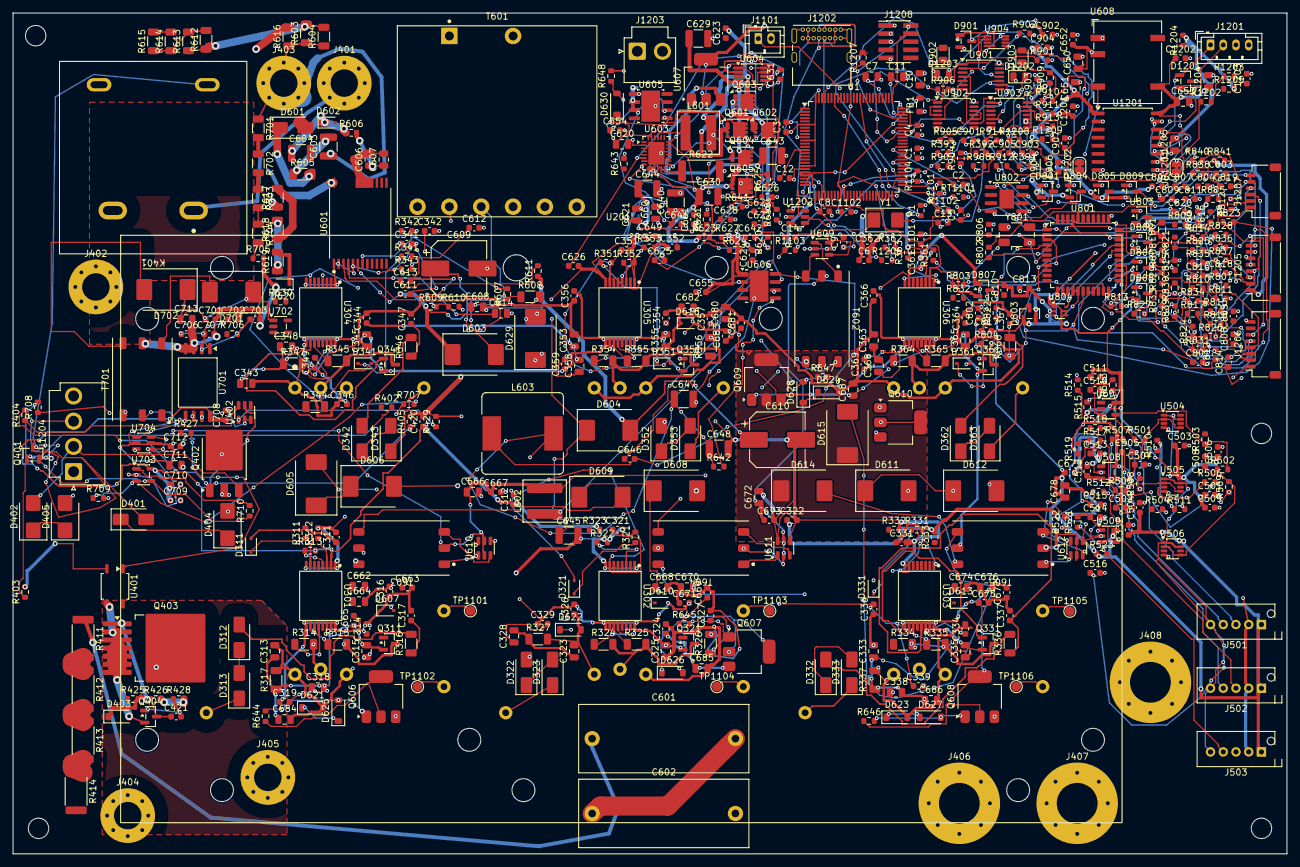
[picture p19: board mcuc_inverter.kicad_pcb from above]

Board: 4 copper layers, 200.0 x 132.0 mm, 564 parts (0 on the bottom side), 347 nets.

Other parts of the board:
MH1, MH2, MH3, MH4: MountingHole_3.2mm_M3
