aratzps/MCU-C/mcuc_dclink/mcuc_dclink.kicad_pcb

## KiCad design mcuc_dclink/mcuc_dclink.kicad_pcb (2026-08-14)

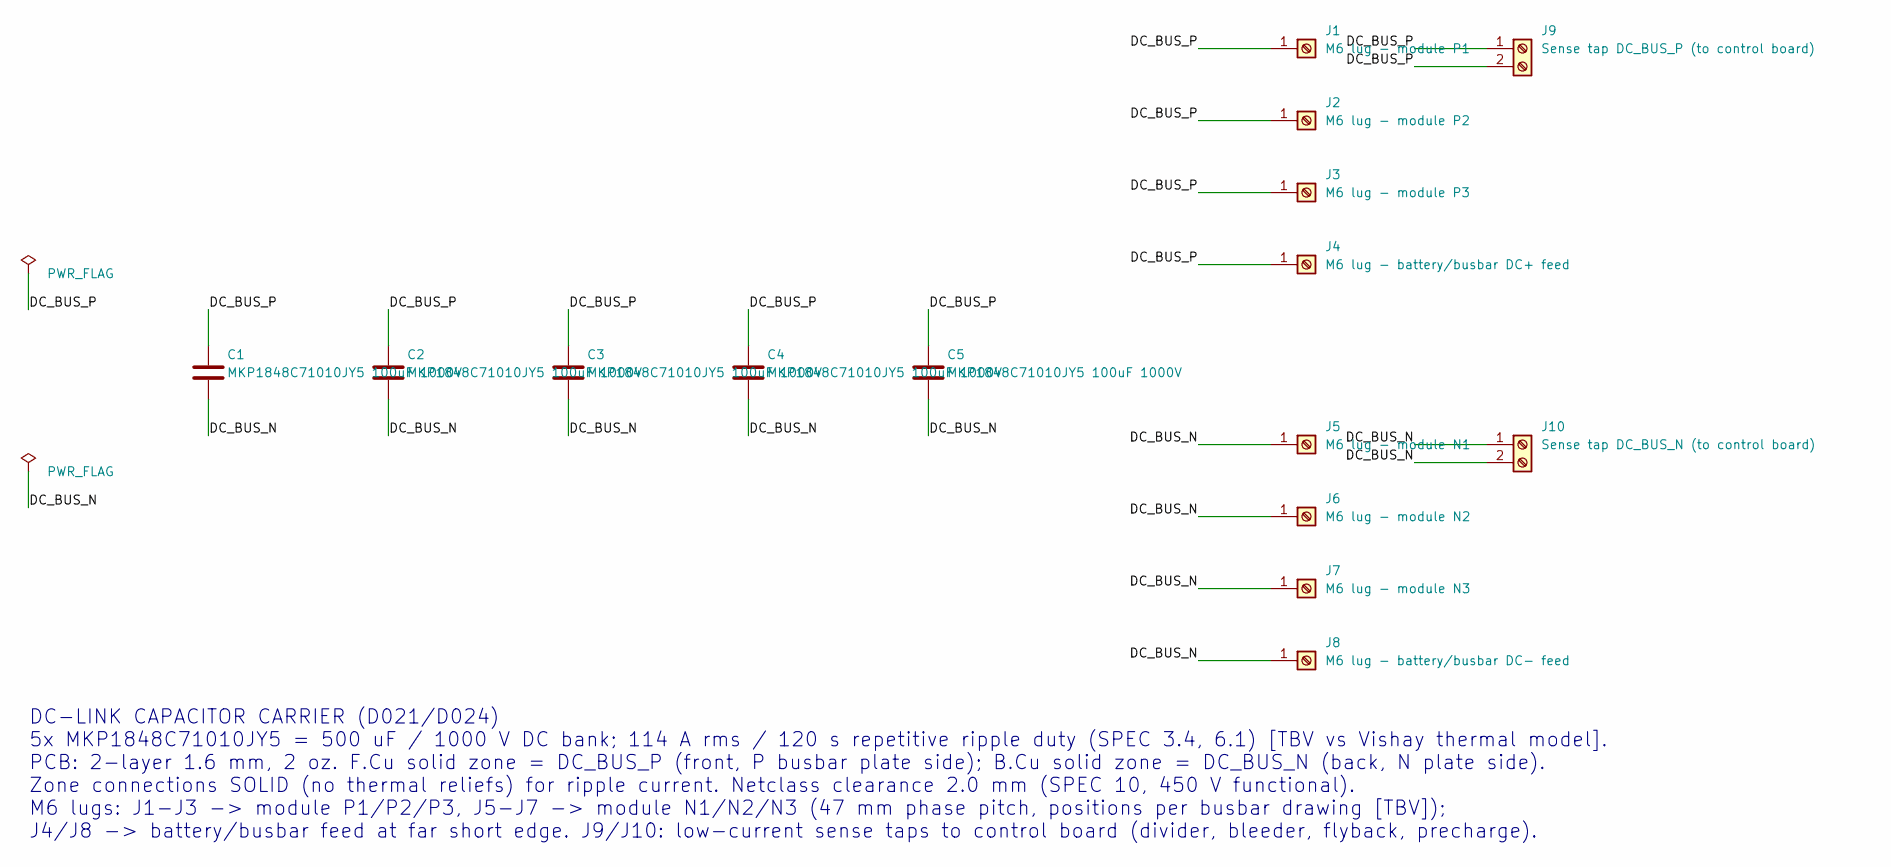
[picture p20: schematic mcuc_dclink.kicad_sch, MCU-C DC-Link Capacitor Carrier]

Parts:
C1, C2, C3, C4, C5: MKP1848C71010JY5 100uF 1000V; MKP1848C_6pin_52.5x20.3
J1: M6 lug - module P1; M6_LUG
J2: M6 lug - module P2; M6_LUG
J3: M6 lug - module P3; M6_LUG
J4: M6 lug - battery/busbar DC+ feed; M6_LUG
J5: M6 lug - module N1; M6_LUG
J6: M6 lug - module N2; M6_LUG
J7: M6 lug - module N3; M6_LUG
J8: M6 lug - battery/busbar DC- feed; M6_LUG
J9: Sense tap DC_BUS_P (to control board); TAP_FASTON_2xD1.5
J10: Sense tap DC_BUS_N (to control board); TAP_FASTON_2xD1.5

Connections:
/DC_BUS_N: C1.2, C2.2, C3.2, C4.2, C5.2, J5.1, J6.1, J7.1, J8.1, J10.1, J10.2
/DC_BUS_P: C1.1, C2.1, C3.1, C4.1, C5.1, J1.1, J2.1, J3.1, J4.1, J9.1, J9.2

Notes on the sheet:
DC-LINK CAPACITOR CARRIER (D021/D024) 5x MKP1848C71010JY5 = 500 uF / 1000 V DC bank; 114 A rms / 120 s repetitive ripple duty (SPEC 3.4, 6.1) [TBV vs Vishay thermal model]. PCB: 2-layer 1.6 mm, 2 oz. F.Cu solid zone = DC_BUS_P (front, P busbar plate side); B.Cu solid zone = DC_BUS_N (back, N plate 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

Board: 2 copper layers, 22 parts (4 on the bottom side), 2 nets, no tracks yet.

Other parts of the board:
FID1, FID2, FID3: Fiducial; Fiducial_1mm_Mask2mm
H1, H2, H3, H4: M4 mounting hole; MountingHole_4.3mm_M4
