aratzps/MCU-C/(commit log)

2026-07-30 Add copperhead config; untrack run logs; fix Power.sch duplicate
    Follow-up to db3f7ce, which committed only copperhead's per-run logs.
    - Add .copperhead/config.json with schematic/board null, so copperhead
    skips ERC/DRC and never touches the KiCad 4 legacy designs under
    pcb_design/ and "adaptor boards/".
    - Untrack .copperhead/runs/ and ignore it; those logs are regenerated on
    every invocation and churned the working tree.
    - Ignore .env, which holds the machine-specific LM Studio endpoint.
    - Drop the stale pcb_design/Power.sch index entry. The repo tracked both
    Power.sch and power.sch; on a case-insensitive filesystem only one file
    exists, so the uppercase path showed as permanentl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
    [Power.sch]
2026-07-30 copperhead: inspect this project
    Inspected the project and found it is essentially empty — no KiCad schematic (.kicad_sch), board (.kicad_pcb), or project (.kicad_pro) files exist. No design docs (SPEC.md, BOM.md, PINOUT.md) are present. The repository contains only a .gitmodules entry for a shared KiCad library (kicad-schlib/kicad-pcblib), a .gitignore, a .env for LM Studio, and a single STEP 3D model for a Power Integrations 2SP0115T2A IC. This is a blank canvas with no active hardware design to inspect or modify.
    Verification: ERC not required
2026-07-30 copperhead: I want to design a new MCU based on this project. It has to be VESC compatible. Specs: Voltage range 48-450V, continuous power 15kW, peak power 35kW. Let's start there
    Completed initial spec and architecture for 15kW–35kW, 48–450V VESC-compatible motor controller. Created SPEC.md (electrical requirements, power budget, thermal targets), BOM.md (preliminary component list with STM32F405RGT6, STK8H122D MOSFETs, AMC1301 current sense), PINOUT.md (complete STM32F405RGT6 pin mapping for PWM, ADC, CAN, Hall, UART), and docs/DECISIONS.md (5 design decisions). All 15 constraints recorded and resolved. Drift check passed (vacuously clean - no schematic). Key decisions: STM32F405RGT6 a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
2026-07-30 copperhead: let's review some of this. The 35kW power figure is at 250V Nominal, please adjust the project accordingly. This should fix the current and at other voltages the power it is what it is
    Recalculated power ratings from 48V to 250V nominal basis. Peak current reduced from 729A to 140A, continuous from 312A to 60A. MOSFET parallel count reduced from 6 to 3 per switch (18 total). Shunt resistor power rating from 100W to 5W-10W. Thermal design simplified to forced air. All docs (SPEC.md, BOM.md, DECISIONS.md, CHANGELOG.md) and constraints.json updated consistently. Design decision D006 recorded. All affected constraint items resolved.
    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
2026-07-30 Replace generated docs with architecture baseline written from scratch
    Scope: fully integrated inverter (control + gate drive + DC link +
    precharge + power stage on one assembly). MCU: STM32F405VGT6 LQFP100.
    All four rotor position interfaces (hall, ABI, resolver, SinCos/SSI).
    SPEC.md covers ratings, the DC-bus vs phase current derivation, power
    stage, gate drive, DC link, precharge/discharge, sensing, protection,
    isolation and creepage, auxiliary power, thermal, and VESC compatibility.
    Every value is tagged REQ / DER / SEL / TBV so requirements, derivations,
    engineering choices and unverified candidates stay distinguishable.
    docs/DECISIONS.md records D001-D010 with rationale and caveats.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
2026-07-30 Add KiCad 9 project skeleton and enable ERC in copperhead
    Creates mcuc_inverter/ with a root schematic and 11 hierarchical sheets,
    one per functional block in SPEC.md: power stage/DC link, gate drive,
    precharge, current sense, bus sense, temperature, position feedback,
    supervisor, auxiliary power, MCU, communications.
    Sheets are empty placeholders -- no symbols, nets or components. The
    structure mirrors the spec so each block has a home before component
    selection starts.
    Defines an HV_BUS net class (2.0 mm clearance, 3.0 mm track) per
    SPEC.md §10, and text variables for the bus and power ratings.
    Points .copperhead/config.json at the new root sheet, so ERC now runs
    on every check instead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
    [aux_power.kicad_sch, bus_sense.kicad_sch, comms.kicad_sch, current_sense.kicad_sch, gate_drive.kicad_sch, mcu.kicad_sch, mcuc_inverter.kicad_sch, position.kicad_sch]
2026-07-31 Adopt 88S1P dual-chemistry pack architecture (D011)
    Locks the pack decision from the 2026-07-30 bus-voltage study: 88S1P
    Desten 10135170 pouches in two chemistry SKUs sharing one fixture and
    one inverter -- LFP 22 Ah "Life" (281.6 V nominal, 220-321 V, 6.2 kWh)
    and NMC 32 Ah "Range" (325.6 V nominal, 264-370 V, 10.4 kWh), both
    6C-charge rated per datasheet.
    SPEC changes: operating window 220-370 V (48-450 V envelope retained as
    hardware capability); OVP 490 -> 400 V (above NMC full charge + regen,
    one threshold for both SKUs); UVLO 45 -> 200 V; aux-supply input range
    collapses from 48-450 V (9.4:1, the hard flyback problem) to 220-370 V
    (1.7:1, standard parts). D011 records rationale and ca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
2026-07-31 Fix target motor: EMRAX 188 HV; re-derive currents from datasheet
    Record D011: EMRAX 188 High Voltage winding as target motor, with all
    figures verified against the manufacturer's v1.6 datasheet. The HV
    envelope at 250 V (100 Nm at ~3400 rpm ~ 35.6 kW) lands on the board's
    35 kW rated point; MV/LV windings would need 310-900 A rms.
    Supersede the 1.5x current guess with motor-derived values: 100 A rms
    continuous, 190 A rms peak, 270 A instantaneous, +/-325 A sense,
    300 A hardware trip. Raise module criteria (>=150 A cont / >=270 A
    peak) and DC-link ripple requirement (60/114 A rms). Add the missing
    motor winding temperature input (KTY 81/210) to sensing.
    Resolves SPEC open item 1; winding v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
2026-07-31 Peak duration 120 s (match motor S2); derive DC-link sizing
    D012: t_peak 10 s -> 120 s per owner directive, matched to the EMRAX
    188's S2 2 min rating. 120 s is quasi-steady-state for baseplate/cold
    plate/coolant, so cooling must be sized for peak-condition losses
    (~700 W SiC / ~1225 W Si at 35 kW), not the continuous 300-525 W.
    Module continuous-class criterion raised to >= 200 A.
    D013: DC-link capacitance derived, resolving open item 5 conditionally:
    400 uF holds 1.5% bus ripple at f_sw >= ~23 kHz (SiC path); Si at
    ~12 kHz needs >= 750 uF. Binding constraint is ripple current: bank
    >= 80 A rms @ 70 C with 114 A / 120 s repetitive duty to verify.
    Precharge energy note scales with C.
    Co-Au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
2026-07-31 Add verified Si-vs-SiC cost analysis and aux supply candidate
    docs/SI_VS_SIC.md: real stocked parts (DigiKey 2026-07-31) — Si
    FS200R12KT4R $132 vs SiC FS02MR12A8MA2B $767 at our current class;
    stocked sub-$300 SiC six-packs are all 48-90 A, too small. Battery
    compensation math: Si's efficiency penalty costs +1.59% pack capacity;
    break-even pack sizes 44-370 kWh depending on cell price, so Si wins
    pure capex at any realistic EMRAX 188 pack. After DC-link and cooling
    offsets, net SiC premium ~= $280 (20 kWh case), buying silence, mass,
    and 450 V headroom. Decision left to owner.
    D014: aux flyback candidate InnoSwitch3-AQ INN3990CQ - only verified
    family with 30 V DC start spanning 48-450 V;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
2026-07-31 Capture MCU sheet: STM32F405VGT6 core circuit, ERC clean
    Populate mcuc_inverter/mcu.kicad_sch with the STM32F405VGTx from the
    official KiCad 9 library: per-pin VDD decoupling (6x100n + 4.7u bulk),
    VDDA/VREF+ via ferrite with 1u+100n, 2x2.2u VCAP, BOOT0 10k pulldown,
    NRST 100n, 8 MHz HSE with 18 pF loads, and the SPEC 12.2 anchor pins
    as hierarchical labels (TIM1 PWM HS/LS, FAULT_BKIN on PB12, CAN1,
    USB, SWD) verified against the symbol pin table via netlist export.
    Root sheet gains the 14 matching sheet pins on the MCU sheet symbol.
    Project ERC severities: pin_not_connected and label_dangling relaxed
    error->warning so future-GPIO pins stay visible without no-connect
    flags (CLI ignores exclu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
    [mcu.kicad_sch, mcuc_inverter.kicad_sch]
2026-07-31 Add 10k/yr volume analysis and GaN evaluation (D015)
    Volume section: module pricing at 10k/yr is quote-only everywhere;
    estimates from analyst consensus (SiC ~3x Si at die level, parity
    window 2027-2029) put the net SiC premium at ~$70-200/unit after
    OEM-priced battery compensation and volume cap/cooling offsets --
    the qty-1 verdict (Si wins) inverts around hundreds of units/yr.
    Supply-chain and acoustic factors dominate at scale.
    D015: GaN ruled out for the power stage on verified 2026 product
    data: no >=900 V GaN above 34 A ever shipped (now obsolete), no
    suitable modules, no avalanche capability in lateral GaN, and no
    benefit at 25 kHz FOC switching. GaN retained in the aux flyback
    (Powi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
2026-07-31 D016: SiC power stage selected; propagate consequences
    Owner decision on the SI_VS_SIC analysis. Baseline module Infineon
    FS02MR12A8MA2B (HybridPACK Drive G2). Propagated: f_sw baseline
    25 kHz (DC link stays 400 uF), gate drive to SiC levels (+15/0..-5 V
    TBV, CMTI >= 100 V/ns), module overtemp 150 C, thermal design point
    300 W continuous / 700 W for 120 s, pin-fin coolant-jacket mechanical
    concept. 2SP0115T2A IGBT driver data demoted to reference only.
    Sourcing note: buy prototype modules at design commit (39-wk lead
    behind ~51 pcs current stock).
2026-07-31 D017: gate driver 1ED3491MC12M candidate; +18/-5 V gate levels
    Verified against the FS02MR12A8MA2B datasheet: VGS(on) 15-18 V with
    Rds,on 1.90 mOhm @ 18 V vs 2.40 @ 15 V (+26% conduction loss, so
    +18/-5 V), Qg 1.19 uC, Rg,int 0.66 Ohm, drain-sense pins for DESAT,
    PressFIT PCB per AN-G2-ASSEMBLY. Driver: 1ED3491MC12M primary
    (reinforced, 200 V/ns, adjustable DESAT/soft-off, $6.31, 2670 pcs);
    UCC21755-Q1/UCC21750 alternates; 1EDI3035AS (Infineon's own pairing)
    zero stock, kept as reference design. Isolated supplies: discrete
    push-pull baseline, Murata MGJ2 19-wk lead.
    Spec corrections from datasheet: module temp sensing is a per-phase
    diode (TS1-TS3, current-source bias), not an NTC; no integ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
2026-07-31 Amend D017 with full datasheet verification of remaining drivers
    STGAP3SXS verified and requalified (reinforced VDE 0884-17, 200 V/ns,
    10 A, SiC 6 V DESAT, $4.85 - cheapest qualifier) and NCD57000
    verified (VIORM 1200 Vpk, 100 V/ns min) - both added as alternates;
    1ED3491MC12M stays primary. STGAP1AS confirmed excluded (obsolete,
    2.5 kVrms, 50 V/ns).
    Murata MGJ2 compliance caveat recorded: reinforced cert covers only
    150 Vrms working voltage (5.2 kV is a test voltage; 2.4 kVdc
    continuous is functional-grade). At a 450 V bus the driver IC must
    carry the reinforced barrier; supply transformer treated as
    functional isolation pending the compliance target.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
2026-07-31 Port PALTA supervisor interlocks to KiCad 9 supervisor sheet
    Faithful recapture of pcb_design/supervisor.sch (verified against the
    legacy VESC-controller.net netlist): per-phase NAND overlap detection
    gating complementary PWM pairs through AND gates (both outputs forced
    low on overlap), 4.7k boot pulldowns on all six PWM inputs, AUP1G74
    overcurrent latch (OC_TRIP edge -> latched, FAULT_RESET clear, LED),
    driver-fault conditioning (RC + BAT54S clamp) driving FAULT_BKIN, and
    the active-low driver-reset chain (MCU request AND driver-fault AND
    OC latch).
    Interface: PWM_HS/LS_1..3 in, *_GATED out, OC_TRIP (single open-drain
    input; comparator lives with current sensing per SPEC), DRV_FAULT_IN,
    OC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
    [mcuc_inverter.kicad_sch, supervisor.kicad_sch]
2026-07-31 D018: record supervisor port and correct D008 dead-time claim
    The PALTA supervisor performs overlap elimination only; it never
    inserted hardware dead time. SPEC 9.2 corrected: dead time comes from
    TIM1's silicon dead-time generator plus a planned turn-on RC delay
    network per gate-drive input (~250 ns TBV) as the firmware-independent
    backstop. D008's latch and BKIN claims were accurate and are now
    netlist-verified.
2026-07-31 Ignore KiCad local state/backups; add gate-driver datasheets
    NCD57000 and STGAP1AS datasheets referenced by D017. .kicad_prl and
    the *-backups/ folder are per-machine KiCad state, regenerated on
    open.
2026-08-02 Capture power_stage sheet: FS02MR12A8MA2B module + DC-link bank
    Custom symbol (project lib mcuc_inverter.kicad_sym) built from the
    module datasheet pin map, Fig. 1/3/4: 39 pins - G1-G6, dual Kelvin
    sources S1.1..S6.2, drain-sense D1-D6, TS1-TS3 diode pairs, and 9
    power terminals (P1-3/N1-3/U/V/W, per-phase DC feeds tied on-sheet,
    laminated busbar note). Switch mapping odd=HS/even=LS, 1/2=U 3/4=V
    5/6=W per Fig. 1.
    DC-link: C201-C205, 5x 100uF 900V film [TBV], with the SPEC 6.1 bank
    duty note (>=400uF, >=80 A rms @ 70C, 114 A/120 s TBV) and the
    AN-G2-ASSEMBLY PressFIT pattern note.
    ERC 0 errors; netlist assertion 49 pins / 29 nets, 0 mismatches.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
    [mcuc_inverter.kicad_sch, power_stage.kicad_sch]
2026-08-02 Capture gate_drive sheet: 6x 1ED3491MC12M channels, root wiring
    Pinout verified from the 1ED34x1Mx12M datasheet v1.20 (single IN pin;
    RDYC is dual-function ready-output / fault-clear-input, bused per
    datasheet with a 1k series resistor to the supervisor's push-pull
    DRV_RST_OUT). Per channel: D018 turn-on RC delay (1k/330p [TBV] with
    on-sheet retune note), ON/OFF split gate resistors 12R/3R3, BSS138
    Miller clamp to VEE2 per datasheet 4.5.4.1, DESAT chain (1k + 2x
    US1M) to the module drain-sense pins, ADJA 4.87k (349 mA soft-off)
    and ADJB 1.33k (650 ns LEB) [TBV], +18/-5 rails per HS channel with
    shared LS supply. FLT_N wired-AND joins the supervisor fault
    conditioning.
    Root sheet: supervisor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
    [gate_drive.kicad_sch, mcuc_inverter.kicad_sch]
2026-08-02 D019: phase current sensing via LEM HOYS 200-S/SP33; shunts rejected
    Shunt route rejected on verified grounds: 0.75 mOhm dissipates 27 W
    at the 120 s peak; the 0.1 mOhm + delta-sigma route is blocked because
    the STM32F405 has no DFSDM peripheral (ST AN4821), and the analog
    AMC1302 fallback is unstocked (16-wk lead). LEM HOYS 200-S/SP33 is
    the only verified in-stock transducer meeting +/-325 A range,
    reinforced isolation (IEC 61800-5-1, 5.4 kVrms tested) and native
    3.3 V / 1.65 V-ref ADC mapping.
    300 A hardware trip moves to an external window comparator per phase
    (HOYS internal OCD sits at 584 A), wire-OR onto supervisor OC_TRIP,
    restoring the PALTA per-phase comparator structure. Bandwidth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
2026-08-02 D020: aux power secondary architecture, all parts verified
    INN3990CQ flyback (DER-948Q 15 V pattern) -> 15 V rail; LM5175
    buck-boost from the 12-24 V aux input OR'd in via LM74610-Q1;
    LMR51430 bucks to 5 V and 12 V [TBV]; TLV1117-33 3.3 V; 4x SN6505B
    + Wuerth 750316856 (1:4.67 -> 23 V, zener-split +18/-5) gate
    supplies from the 5 V rail; Murata NXE2S0505MC isolated CAN 5 V.
    Two verified traps avoided: SN6505B is 5 V-only (gate supplies
    cannot run from 15 V; no stocked transformer reaches +18/-5 from
    15 V via SN6507), and a plain boost cannot serve the 12-24 V aux
    input (fails regulation at 24 V in / 15 V out) - hence the 4-switch
    buck-boost.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
2026-08-02 Capture precharge sheet: precharge, bleeder, active discharge
    Per SPEC 7: precharge path (relay + 1.25k 50W >=41J pulse resistor
    into DC_BUS_P), main-contactor low-side driver with flyback diode,
    passive bleeder as a strict 4-resistor series string (no part spans
    450 V, SPEC 8.2 rule), and active discharge (4x 220R 25W string +
    C3M0350120J, opto-driven gate with 18 V zener clamp, floating supply
    labels pending aux_power; VDISCH_N tied to the FET source on-sheet).
    Sequencing rule and discharge requirements quoted on-sheet.
    Root: DC_BUS_P/N wired precharge <-> power_stage; verified in the
    netlist that the precharge resistor output reaches the module P1-P3
    terminals and cap bank. ERC 0 errors;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
    [mcuc_inverter.kicad_sch, precharge.kicad_sch]
2026-08-02 Capture current_sense sheet: 3x HOYS 200-S/SP33 + 300 A trip
    Per D019: LEM HOYS transducers with explicit primary pins so the
    phase busbar path is in the netlist (U201 phase terminal -> P1/P2 ->
    PHASE_x_OUT). Pinout verified from the LEM datasheet connection
    figure - 5-pin device including an OCD output the brief didn't know
    about, wire-OR'd onto OC_TRIP as an independent ~584 A backup trip.
    Per phase: 100R/1nF anti-alias to I_PH_x, individual I_REF_x (Uref
    outputs may not be paralleled per datasheet), and an LM2903-class
    open-drain window comparator pair (thresholds 2.340/0.960 V from a
    9.53k/13.7k/9.53k E96 string = +/-300 A at 2.3 mV/A) pulling
    OC_TRIP low on either polarity - matching t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
    [current_sense.kicad_sch, mcuc_inverter.kicad_sch]
2026-08-02 Capture aux_power sheet: full D020 rail tree, 7 blocks
    INN3990CQ flyback per datasheet Fig. 10 / DER-948Q (series-string
    input films, RCD clamp, custom 3-winding transformer symbol with
    Lp/VOR/isolation notes, bias->BPP, Schottky secondary, FB 143k/13.2k
    -> 14.97 V, SR and IS tied to GND per datasheet for diode operation);
    LM5175 buck-boost aux path (15.02 V, deliberately above the
    diode-dropped flyback so aux carries the load when present) through
    LM74610-Q1 + external FET; two LMR51430 bucks (5 V: 71.5k/9.76k;
    12 V: 115k/6.04k); TLV1117-33 3.3 V (PWR_FLAG moved here from the
    MCU sheet - this is the rail's true source); 4x SN6505B + WE
    750316856 gate supplies (winding CT pinout verified fro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
    [aux_power.kicad_sch, mcu.kicad_sch, mcuc_inverter.kicad_sch]
2026-08-03 D021: mechanical concept - one PCB on module, power via busbar
    Single 1.6 mm control/driver/aux PCB PressFIT onto the module per
    AN-G2-ASSEMBLY; power current stays off the PCB entirely: laminated
    DC busbar carries battery -> cap bank -> module screw terminals, and
    phase busbars pass through the HOYS apertures to M6 studs. Chassis
    parts (precharge relay/resistor, discharge bank, coolant NTC) are
    connectorised. Resolves SPEC 14 item 8.
2026-08-03 Draft engineering report: all settled derivations consolidated
    docs/ENGINEERING_REPORT.md sections 1-12: current sizing from the
    EMRAX 188 HV with cross-checks, Si/SiC/GaN economics, the 120 s peak
    thermal argument, DC-link derivation, the six-layer firmware-
    independent protection chain, gate drive and aux power with the
    verified traps, precharge energy math, sensing decisions, isolation
    architecture, and the per-sheet verification record. Pending
    sections marked and tracked against tasks 2-7.
2026-08-03 D022: sensing front ends settled on verified constraints
    Module TS diodes: provision-only in rev A. Verified from the module
    datasheet and AN-G2-EVALTOOLS that the TS pins carry no isolation
    rating and the only documented readout is the HV-side ADC inside the
    zero-stock 1EDI3035AS driver (referenced to the switch source). No
    control-GND readout is supportable. Module thermal protection moves
    to a coldplate NTC (TDK B57861S0103F040, AEC-Q200) with conservative
    threshold + DESAT backstop; upgrade path documented.
    Motor temp: KTY 81/210 is obsolete (NXP EOL 2020) - front end
    becomes resistor-selectable PT1000/KTY8x/NTC10k (all VESC-native);
    order the EMRAX with PT1000 where offered.
    Bus sense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
2026-08-03 Capture position sheet: AD2S1205 resolver, halls, encoder, SinCos
    Port from PALTA legacy sheets, verified pin-by-pin against the ADI
    datasheet and the legacy VESC-controller.net (175/175 netlist
    checks). Fixes two legacy defects found during reconstruction: SOE
    (serial output enable, an INPUT mislabeled as output in the legacy
    symbol) was left floating on PALTA - now tied low for serial mode;
    and the A/B/NM encoder-emulation outputs that make VESC resolver
    support free (D003) were never wired on the legacy board - now
    brought out via 0R links with an exclusive-population note vs the
    external ABI encoder. REFBYP decoupling added per datasheet (PALTA
    floated pin 43).
    Exciter (AD8397), hall cl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
    [mcuc_inverter.kicad_sch, position.kicad_sch]
2026-08-03 Add sourcing BOM: every line datasheet- and stock-verified
    docs/BOM.md: complete part selection with prices (qty 1/100),
    suppliers and stock caveats for all six blocks, from the 2026-07-31
    ..08-02 verification sweeps. Includes the order-at-design-commit
    watch list (module 39-wk, AD2S1205 20-wk, HOYS 5 pcs, STM32 via
    Newark, Hongfa relay via Rutronik) and the substitution corrections
    the sweeps caught (fictitious REDCUBE THR M6, obsolete AO3400/KTY81/
    NCP18, unstocked Nexperia BAS316/BZX384, SS310 package flag,
    MKP1848C P/N decode trap). Rough qty-1 roll-up ~= $1.4k + module-
    dominated. Refdes-level CSV to follow PCB completion.
2026-08-03 Capture bus_sense, temp_sense, comms: all 11 sheets now live
    bus_sense: 4x750k + 12.0k string (strict series, 124.5 V/part) into
    AMC1311BDWV (pinout verified vs SBAS786C; B-grade 3.0-5.5 V VDD1 is
    load-bearing per D022; no input clamp diodes per TI 9.3), HV-side
    3.3 V from MCP1804T-3302 (2-28 V in, stocked - no TBV needed) off
    the VGD_LS rail, diff-to-SE gain 0.75: V_BUS = 2.988 mV/V, 500 V ->
    1.494 V, saturates ~1.50 V, always < 3.3 V.
    temp_sense: coldplate NTC channel (B57861S off-board via J1101),
    board NTC (NCU18 successor), 6x DNP TS provision pads onto the
    module TS pins with D022 rationale quoted on-sheet.
    comms: ISO1042DWR isolated CAN (VCC2 pins 11/16 tied - datasheet
    requirement)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
    [bus_sense.kicad_sch, comms.kicad_sch, mcuc_inverter.kicad_sch, temp_sense.kicad_sch]
2026-08-03 Precharge: VOM1271T photovoltaic discharge drive; fix gate pulldown
    Swap the active-discharge opto to VOM1271T (pinout verified from
    Vishay 83469 Rev 1.9; SOP-4 symbol added to project lib) driven at
    ~19 mA from DISCHARGE_EN (R427 330R -> 100R). Deletes the
    VDISCH_P/N floating-supply labels, flags and root pins entirely -
    the photovoltaic driver needs no secondary supply and integrates
    rapid gate turn-off.
    Fix found during the swap: the 10k gate pulldown (R426) would have
    clamped the VOM1271's 15-47 uA output to ~0.2 V - below the FET
    threshold, discharge would never fire. Raised to 10M per the Vishay
    test circuit; turn-off is handled by the driver's integrated
    circuit, and the 10M still bl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
    [mcuc_inverter.kicad_sch, precharge.kicad_sch]
2026-08-03 Actually apply R426 10k -> 10M (previous commit's edit had failed)
    The prior commit claimed the R426 fix but the text substitution had
    silently failed on a line-ending mismatch while the commit chain
    proceeded. This commit contains the real change, verified in-file:
    R426 (discharge FET gate pulldown) is now 10M so the VOM1271's
    15-47 uA photovoltaic output can develop full gate voltage; 10k
    would have held Vgs at ~0.2 V and discharge would never fire.
    ERC 0 errors re-verified.
    [precharge.kicad_sch]
2026-08-03 D023: no phase-voltage sensing in rev A; MCU pin map fixed
    VESC's SENS1/2/3 channels assume a board floating at battery
    potential with direct phase dividers - impossible in this isolated
    architecture. Isolated phase sensing (3x AMC1311 + per-phase HV
    supplies) is not justified for FOC with 3-phase current sensing and
    four position interfaces; PA0/1/2 reserved, phase filters disabled
    in the custom hw header. Pin map fixed per the citation-verified
    assignment (PC0/1/2 currents on VESC triple-simultaneous channels,
    SPI3 resolver with PA15 boot-safe CS, boot-safe control GPIOs).
2026-08-03 Wire full MCU pin map; add verified PINOUT.md
    All 33 remaining signals wired per the citation-verified map (D023):
    phase currents PC0/1/2 on VESC triple-simultaneous ADC channels,
    V_BUS PC3, temps PA3/PB0/PC4, SinCos PA5/PA6, I_REF PA4/PA7/PB1,
    encoder PC6/7/8 (TIM3), halls PD12/13/14, resolver SPI3 PC10/PC11 +
    PA15 boot-safe CS + PD0/PD1/PD2 controls, supervisor GPIOs PD3/4/5,
    precharge/contactor/discharge PE2/3/4, LED PE0, VBUS sense PC5, PPM
    PB6 (TIM4_CH1, VESC convention - repurposed J1206 spare pin).
    PA0/1/2 and PB10/11 reserved with on-sheet notes.
    AD2S1205 drive validated in-datasheet: VIH 2.0 V @ 5 V supply, so
    3.3 V MCU outputs are legal; its 5 V outputs land on FT pins only.
    docs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
    [comms.kicad_sch, mcu.kicad_sch, mcuc_inverter.kicad_sch, position.kicad_sch]
2026-08-03 Add project footprint library: module PressFIT + 5 customs
    mcuc_inverter.pretty: FS02MR12A8MA2B_PressFIT (30 signal pads at the
    datasheet Fig 4 coordinates, unique 1.06 mm drill in its own Excellon
    tool with the AN-G2-ASSEMBLY finished-hole/immersion-tin spec in the
    description; 14 NPTH: guides, 6 heat-stakes, 6 functional screw
    domes - none at D2/D6 per drawing note; 59-degree Y-guide slot
    verified numerically in the exported drill file), MKP1848C 6-pin
    (3+3 paralleled pads mapped to the 2-pin symbol), InSOP-24D per the
    PI POD with the 11.14 mm primary gap noted (S pins 16-19 as stacked
    pads so the symbol maps 1:1), HFE80V-HTPAJ (blade slots, pad numbers
    remapped 3/1/2/5 to the SANYOU symbo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
2026-08-03 D024: two-board partition - control board + DC-link cap carrier
    The film caps are PCB-pin parts but their 114 A rms ripple cannot
    ride on control-board copper. Partition: control/driver board (all
    electronics, HV via low-current terminals, relay + discharge FET
    on-board) and a heavy-copper mcuc_dclink carrier for the 5-cap bank
    between busbar plates. Off-board symbol conventions defined
    (exclude_from_board / pad-less footprint pins), parity warnings
    documented rather than silenced.
2026-08-03 Add mcuc_dclink: DC-link capacitor carrier board (D024)
    Complete second PCB: 320x100 mm, 2-layer 2 oz, 5x MKP1848C between
    solid front (DC_BUS_P) and back (DC_BUS_N) zones with SOLID pad
    connections (no thermal reliefs - 114 A rms bank duty), M6 lug
    terminations to module P1-3/N1-3 at 47 mm phase pitch (positions
    TBV per busbar drawing, noted on silk) and battery feed at the far
    edge, low-current sense taps for the control board, M4 mounting
    corners + fiducials. Shares the MKP1848C footprint from the main
    project via relative fp-lib-table path.
    ERC 0/0; DRC 0 errors 0 warnings (re-verified after restoring
    netclasses that a scripting session had silently reset - caught by
    the agent); netlist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
    [mcuc_dclink.kicad_pcb, mcuc_dclink.kicad_sch]
2026-08-03 Board-prep: footprint audit complete, HV terminals, off-board flags
    474-component audit: 466 valid resolved footprints, 13 off-board
    exclusions per D024 (caps to carrier, chassis resistors, HOYS), 4
    flagged TBDs (custom flyback + 3 unchosen inductors), zero silent
    gaps. Netlist-fatal fixes: Q403 renumbered to Wolfspeed TO-263-7
    convention (G1/KS2/S3-7/tab-D8), CSD18543Q3A remapped to KiCad's
    SSSGD VSON-8 pairing - both verified in the netlist afterward.
    New HV interface terminals J401-J405 (M4 ring-lug pads: DC input,
    precharge-R chassis loop, discharge-R return, bus taps) and HOYS
    harness headers J501-J503 (JST 2mm; PA-vs-PH footprint flagged TBV)
    with net membership machine-verified incl.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
    [aux_power.kicad_sch, comms.kicad_sch, current_sense.kicad_sch, gate_drive.kicad_sch, mcu.kicad_sch, position.kicad_sch, power_stage.kicad_sch, precharge.kicad_sch]
2026-08-03 Close last footprint TBDs: inductors verified, flyback on EQ30
    L601 Bourns SRP6060FA-100M (10uH/7.6A), L602 SRP5030TA-4R7M, L603
    SRR1260-120M - all stocked, official KiCad footprints verified on
    disk. Rejected: Wuerth 744771110 (P/N does not exist - another
    fabrication trap), 744771112 (0 stock/28wk), Coilcraft XAL (delisted
    from DigiKey).
    T601: DER-948Q's authoritative material list specifies Ferroxcube
    EQ30+PLT30/3C96 on MyCoilTech MCT-EIQ3001 bobbin (not the EFD25 its
    BOM text mentions) - Lp 422.6uH verified < 500uH (D020), 25T/2T/2T,
    and it IS a 15V design so the VOR-raised TBV note is obsolete.
    Symbol renumbered to bobbin physical pins dot-for-dot with DER Fig 7
    (nets verified identica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
    [aux_power.kicad_sch]
2026-08-03 PCB Phase A: board setup, placement, HV barrier rules - DRC clean
    mcuc_inverter.kicad_pcb: 200x132 mm 4-layer (F/In1-GND/In2-power/B),
    module PressFIT pattern anchored at (79,40) with courtyard on B side
    (module hangs below the board), all ~460 on-board components placed
    in domain blocks: HV corner (relay, terminals, divider, film caps,
    flyback+InSOP straddling the barrier), discharge pocket, three gate-
    drive columns 11.5-12 mm from their module gate pins with per-channel
    HV parts on the HV side and supplies feeding across, LV strip (MCU,
    supervisor, aux, position, comms) with the CAN isolation island at
    the connector edge.
    Safety geometry enforced, not advisory: mcuc_inverter.kicad_dru
    HV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
    [mcuc_inverter.kicad_pcb]
2026-08-03 Add refdes-level BOM CSVs for both boards
    Generated from the schematics with kicad-cli after the footprint
    audit, so every line carries its assigned footprint and the D024
    off-board flags: mcuc_inverter 165 line items / 474 parts (13
    excluded from board - DC-link caps, chassis resistors, HOYS
    transducers), mcuc_dclink 11 line items (5-cap bank + M6 lugs +
    sense taps). These complement docs/BOM.md, which carries the
    verified suppliers, prices and stock caveats per part class.
    [BOM_mcuc_dclink.csv, BOM_mcuc_inverter.csv]
2026-08-03 Report: add pinout, physical realisation and BOM sections
    Sections 13-15 now settled: the MCU pin map with its VESC ADC-vector
    rationale and the D023 no-phase-sensing argument; the two-board
    physical concept with the enforced-not-advisory isolation rules
    (custom 6.4 mm HV_to_LV DRC rule proven by probe track, 14 barrier
    keepouts) and the two recorded geometry exceptions; and the BOM
    summary including the list of parts the sourcing sweeps caught as
    fictitious, obsolete or mis-decoded before they reached a purchase
    order. Pending list narrowed to routing, fab package and review.
2026-08-03 Record adversarial review 1 (stress/ratings/thermal) with dispositions
    17 substantive findings, each with arithmetic and datasheet citation.
    Five critical: RCD clamp resistors at 3-5x their voltage rating;
    four capacitor footprints physically impossible (0603 assigned to a
    26 mm radial X2 box); flyback drain plateau 694 V against a 725 V
    continuous limit; DESAT blanking too slow for the module's 1.2 us
    short-circuit withstand; and - the most dangerous - LM2903
    comparators whose input common-mode range (max 1.8 V on 3.3 V) sits
    below the 2.34 V upper trip threshold, so the hardware overcurrent
    protection would silently not function.
    Root cause of several majors: SPEC derived precharge and bl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
2026-08-03 D025: spec corrections from adversarial review
    Thermal design point recomputed from the module's own loss tables
    instead of a technology-class efficiency estimate: ~390 W continuous,
    ~1040 W at the 250 V peak condition, ~1440 W at 450 V (eta 97.1%).
    The module keeps 3-4x junction margin, so the correction lands on
    the coolant loop and heat exchanger, which were sized for 700 W.
    Also clarifies there is no cold plate to design - the G2 is
    direct-cooled and needs a jacket per AN-G2-ASSEMBLY.
    Re-derived everything that still assumed 400 uF after the 500 uF
    bank was chosen: precharge energy 40.5 -> 50.6 J (spec 65 J),
    duration 2.5 -> 3.13 s (firmware timeout >=3.2 s), and the passive
    bleeder whi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
2026-08-03 Gate drive: DESAT blanking caps 100pF -> 22pF (partial CR-2 fix)
    First item of the review fix pass to land before the agent was
    interrupted. Reduces the DESAT ramp from 1.84 us to 272 ns.
    INCOMPLETE against review 3's CR-2: with ADJB still at 1.33k
    (tDESATfilter 1575 ns) and ADJA at 4.87k (349 mA soft-off), the
    total detect-to-gate-off chain is still ~4.2 us against the
    module's 1.2 us short-circuit withstand. Remaining work: tie ADJB
    to VCC1, ADJA -> 28.0k, and either derate VGS(on) to +15 V (buys
    the 2 us rating) or reopen D017 for a SiC-threshold driver
    (UCC21755-Q1 at 5.0 V or STGAP3SXS at 6.0 V, both already
    qualified in SPEC 5).
    Also ignores KiCad's fp-info-cache.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
    [gate_drive.kicad_sch]
2026-08-03 Record adversarial reviews 2 and 3 with full findings
    Review 2 (precharge/MCU/connectors/dangling): verified all 100 MCU
    pins against ST's tables - and found the review brief's own assumed
    pin list wrong while the schematic was right. New criticals: the
    12 V rail cannot supply a contactor coil, and the three motor phase
    outputs are dangling with no terminal anywhere in the design.
    Review 3 (circuit correctness): verdict "not fabrication-ready",
    seven criticals. CR-1 is the headline - the gate-driver fault latch
    can never be cleared (RDYC only rises when FLT_N is already high;
    FLT_N only clears on a rising RDYC edge; the MCU reset is ANDed in
    so it can only add another low), meaning the boar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
2026-08-03 D026: derate gate drive to +15 V; rebuild fault-clear and trip paths
    The module withstands a short circuit for <1.2 us at +18 V gate but
    <2 us at +15 V. The as-drawn DESAT chain took ~5.8 us and even
    optimally configured the 1ED3491 reaches ~2.0 us, so the 18 V rating
    was simply unreachable. Derating to +15 V makes the requirement
    attainable and, as a bonus, removes the +19 V absolute-maximum
    overstress review 1 found on the open-loop gate rail. Cost: +26%
    conduction loss (~+122 W at peak), absorbed by the module's 3-4x
    junction margin.
    Records why D017 was NOT reopened: the dominant delays are the
    configurable blanking filter and soft-off current, not the 9.18 V
    threshold, so a six-channel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
2026-08-03 DC-link carrier: 2 oz -> 4 oz copper (review finding #16)
    The carrier's planes sit in series in the main DC path (battery feed
    lug -> planes -> module P1-P3 lugs), not merely as a capacitor
    mounting surface. At 2 oz that is ~1.9 mOhm total, so the 140 A peak
    dissipates 37 W in the board with ~65 K rise over the 120 s peak -
    and D024's "heavy copper" claim was never reflected in the stackup,
    so a fab would have built it at KiCad's 35 um default.
    4 oz halves it. The stackup now declares 0.14 mm both sides and the
    board note carries the requirement and the reason, so it reaches the
    fab files instead of living only in a document.
    DRC re-verified after the edit: 0 violations, 0 unconnected.
    Co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
    [mcuc_dclink.kicad_pcb]
2026-08-03 SPEC 11.4: recompute losses for the +15 V gate derate (D026)
    Conduction rises with R_DS,on at V_GS = +15 V (4.67 mOhm at 150 C vs
    3.70 at +18 V): 470 -> 575 W, so peak-condition dissipation goes
    1040 -> ~1145 W at 250 V and ~1540 W at 450 V, continuous ~420 W.
    Efficiency at peak 96.8%.
    That +105 W is the price of reaching the module's 2 us short-circuit
    withstand, and it comes out of junction margin rather than the
    cooling budget's critical path: T_j lands ~88 C at 65 C coolant
    against a 150 C limit. The heat exchanger requirement moves to
    ~1.15-1.55 kW.
2026-08-03 Report: review-impact analysis, validation plan, reconcile stale figures
    Adds section 17 (what the adversarial reviews changed) and 18
    (validation gates and open risks), and reconciles the earlier
    sections that still carried pre-review numbers so the document does
    not contradict itself.
    Section 17 is deliberately not a sanitised final state: it records
    the eight defects that passed ERC, DRC and visual inspection with
    the reason each survived automated checking, the stale 400 uF
    derivations that left the passive bleeder failing its own safety
    requirement by 26%, and the efficiency estimate used as a design
    input that put the cooling system at 63% of the capacity required.
    It also records wha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
2026-08-03 Add fabrication package for the DC-link carrier board
    Gerbers, Excellon drill + map, position file and gerber job exported
    with kicad-cli from a board at 0 DRC violations / 0 unconnected.
    fabrication/mcuc_dclink/README.md carries the order parameters a
    fabricator actually needs, with the reasoning attached rather than
    bare numbers - in particular that 4 oz outer copper on BOTH sides is
    a functional requirement, not a preference: the planes sit in series
    in the main DC path, so at the 2 oz default the 140 A peak would
    dissipate 37 W in the board. Also flags that immersion tin is NOT
    needed here (no press-fit holes, unlike the control board) and that
    the M6 lug coordinates remain [TBV] agains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
    [mcuc_dclink-B_Cu.gbr, mcuc_dclink-B_Mask.gbr, mcuc_dclink-B_Paste.gbr, mcuc_dclink-B_Silkscreen.gbr, mcuc_dclink-Edge_Cuts.gbr, mcuc_dclink-F_Cu.gbr, mcuc_dclink-F_Mask.gbr, mcuc_dclink-F_Paste.gbr]
2026-08-03 Changelog: record the adversarial review wave and its consequences
    Brings the changelog current with the three-review cycle, D025/D026,
    the carrier copper correction, the first fabrication package, and the
    report's review-impact sections. Records the review verdict plainly
    ("not fabrication-ready", and it was right) and names the three
    defects that mattered most, so the project history shows what the
    review bought rather than only the final state.
2026-08-03 Add control-board fabrication specification
    fabrication/mcuc_inverter/ORDER_SPEC.md - the manufacturing
    requirements, written now because they are set by the module and the
    isolation architecture rather than by the schematic work still in
    flight, and because three of them are things a fabricator's defaults
    actively get wrong:
    1. Press-fit holes need immersion tin, 1.02-1.10 mm finished, 25-50 um
    wall copper - Infineon explicitly discourages ENIG/HAL-LF/OSP there,
    so a blanket "ENIG" quote yields a board the module cannot be
    pressed into. The holes are drawn at a unique 1.06 mm so they land
    in their own drill tool and cannot be merged with vias.
    2. Thickness 1.6 +/-0.16 mm, becau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
2026-08-03 Fix aux power and bus sense per adversarial review (CR-4..7, MJ-5..22)
    CR-6: real footprints for every HV part that had an impossible one -
    C601/C602 (0.68 uF 630 V X2) onto the 26.5x10.5/P22.5 radial box, and
    the InnoSwitch bypass caps off 0603 per the datasheet's explicit "0805
    or larger, do not use 0603 rated MLCC".
    CR-4: RCD clamp rebuilt as 6x 39k 1206 in 3s2p (58.5k) - worst-case
    0.35 W and 117 V per part, inside a 200 V 0.5 W part everywhere,
    against 0603s that were at 7.5x their voltage rating. Drain lands
    731-806 V depending on leakage, so the T601 purchase spec now needs
    L_k <= 2 uH; recorded on-sheet.
    CR-5 solved better than directed: the agent found the -AQ family has
    no reduce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
    [aux_power.kicad_sch, bus_sense.kicad_sch]
2026-08-03 Record fix-pass dispositions, including two corrected instructions
    Adds the implementation record to the review document. The two most
    useful entries are cases where my own instruction was wrong and the
    implementer's verification overruled it:
    - CR-5: I directed a controller swap to get a lower current limit.
    The -AQ family has no such setting; the BPP capacitor selects it.
    Changing 4.7 -> 0.47 uF fixes the core saturation AND keeps more
    power headroom than the swap would have.
    - MJ-22: I specified a diff-amp gain that would have put the 490 V
    OVP threshold 6 mV above a -4% supply rail - unreachable by an
    RRIO output, i.e. the overvoltage protection would not have
    functioned. Co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
2026-08-03 Fix gate drive and supervisor: CR-1, CR-2, MJ-1, MJ-8, MJ-9, MJ-13
    CR-1 - the fault-clear deadlock is broken. U903 gate 4 now computes
    DRV_RST_OUT = DRV_RST_IN AND OC_LATCH_N; FAULT_BKIN is out of the
    chain, so a rising RDYC edge is reachable. C907 (220 nF) gives a
    1.03 ms power-on clear pulse, comfortably past the drivers' 200 us
    start time and the 1.2 us minimum clear width, so the bridge comes
    up without firmware intervention. Gate 3 is freed and labelled for
    the discharge interlock.
    MJ-1 - the overcurrent trip finally reaches TIM1_BKIN. D904 (BAT54WS)
    wire-ORs OC_LATCH_N into FAULT_BKIN: 0.33 mA gives 0.31 V against a
    0.95 V input-low threshold, and it reverse-biases on driver-only
    faul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
    [gate_drive.kicad_sch, mcuc_inverter.kicad_sch, supervisor.kicad_sch]
2026-08-03 D026 amendment: DESAT worst case is 2.6 us, not the ~2.0 us I claimed
    With the chain actually configured and every parameter summed, the
    result is 1.9 us typical but 2.6 us on all-worst-case silicon against
    a 2 us withstand. My original estimate understated it. Typical parts
    pass; worst-case parts do not. Recording this rather than rounding it
    away, because the whole point of the review process was to stop
    exactly this kind of comfortable approximation.
    The dominant term is the soft turn-off itself (1.15-1.43 us to
    discharge the gate at the family-maximum 699 mA), and its slowness is
    deliberate - a hard turn-off into a short produces the overvoltage
    spike that soft-off exists to prevent. So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
2026-08-03 CR-3: dedicated isolated supply for the bus-sense amplifier
    The AMC1311's high-side LDO had VIN on VGD_LS_P and GND on
    VGD_LS_COM - the module's low-side Kelvin-source pins - while its own
    output capacitors, the amplifier's GND1 and the divider bottom all
    sat on DC_BUS_N. Those are different nets joined only through the
    module's internal copper, so at 4 kA/us across ~8 nH of source
    inductance tens of volts appeared inside the supply loop every
    switching edge, and a Kelvin sense node was carrying power current.
    Replaced with the pattern TI actually recommends: an SN6505B
    push-pull stage from the LV 5 V rail through a Wuerth 750313734
    transformer, rectified and post-regulated to 3.3 V, with e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
    [bus_sense.kicad_sch, mcuc_inverter.kicad_sch]
2026-08-03 Fix precharge, current sense, position, comms per review
    Also repairs a library-breaking defect the agent found while working:
    the VOM1271T symbol contained a raw newline inside a quoted string,
    which silently truncated mcuc_inverter.kicad_sym at parse - every
    symbol defined after it was unresolvable. That had been latent since
    the symbol was written.
    MJ-2/3 - the comparators were wrong twice over: TLV7032 is push-pull
    (six of them wire-ORed together plus three open-drain transducer OCD
    pins is direct contention), and LM2903's input common-mode range on
    3.3 V stops at 1.8 V, below the 2.34 V upper threshold, so the
    over-current half could never trip. Now TLV7022DDFR: true open-drain,
    rail-t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
    [comms.kicad_sch, current_sense.kicad_sch, mcuc_inverter.kicad_sch, position.kicad_sch, precharge.kicad_sch]
2026-08-03 SPEC/BOM: trip tolerance, precharge value, relay lead time
    The 300 A hardware trip is really 300 A +-8 A now that the thresholds
    are servo'd off each transducer's own reference. Recording the real
    number rather than the nominal, and noting that the comparator path
    (~0.65 us) is not the limiting factor - the transducer's own 3 us
    response dominates, which also corrects the "<1 us" the table used
    to claim.
    Precharge resistor is 1.2 k as actually specified (Ohmite HS50),
    giving tau 0.60 s and 5tau 3.0 s. Also records that its 50 W rating
    is heatsunk-only - 14 W in free air - which matters because it is a
    chassis-mounted part.
    Sourcing: the Hongfa precharge relay is at zero stock globally with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
2026-08-03 BOM/SPEC refresh: every part the review changed
    Brings the sourcing BOM in line with the fixes rather than leaving it
    describing parts that are no longer in the design. Each row now
    carries WHY it changed, so the BOM doubles as a record of what the
    review caught:
    - Comparators LM2903 -> TLV7022 (rail-to-rail input is mandatory; the
    old part's common-mode range stopped below the trip threshold), plus
    OPA376 buffers that make the trip track the transducer.
    - Bucks LMR51430 -> LMR33630 (the SOT-23-6 could not dissipate its own
    loss); Miller clamps -> BSS316N (+-20 V Vgs mandatory); split zeners
    -> 4.7 V +-2% (5.1 V +-5% exceeded the module's static maximum);
    gate-rail preloads and th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
2026-08-03 Aux power: gate-rail post-regulation, input protection, TVS corrected
    The gate-supply rails are now genuinely inside the module's absolute
    maximum. The zener swap alone was not enough: the raw secondary
    reaches ~24.9 V peak-charged at light load, putting V_GS(on) at
    20.3 V against a +19 V AMR. Each of the four isolated domains now has
    a 15 V reference plus an emitter follower, giving V_GS(on)
    14.2-16.2 V over 0-70 C - 2.8 V under the limit. V_GS(off) lands at
    4.84 V against the -5 V static maximum.
    Two things the agent found that my instructions had wrong:
    - The low-side domain draws 110 mA, not the 41 mA I quoted, because
    VGD_LS_P feeds three drivers rather than one. Its pass device
    di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
    [aux_power.kicad_sch]
2026-08-03 Report: finalize with decision index, derived quantities, assessment
    Sections 19-21 complete the report as a standalone document:
    - S19 indexes all 26 design decisions with the reason each went the
    way it did, so the report can be read without the decision log.
    - S20 tabulates every derived quantity with a pointer to where it is
    derived - currents, DC-link sizing and its thermal verification,
    module losses and junction temperature, precharge and discharge
    timing, trip tolerance, DESAT timing, gate-rail worst cases, bus
    scaling.
    - S21 is a closing assessment that states what is finished, what is
    not (control-board routing and its gerbers), and the three things
    that would worry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
2026-08-03 Fix a real safety defect: HV nets were unclassified after the fix pass
    The adversarial-review fixes created nets sitting at bus potential
    that no HV_BUS netclass pattern matched - the RCD clamp string
    mid-nodes, the entire new UV/OV divider (R616-R619, D620), the
    renamed CLAMP_NODE, the discharge gate net Q403_G, and the bus-sense
    tap V_SENSE. All were being treated as ordinary 0.2 mm-clearance
    signals while carrying 450 V potential.
    This is exactly the class of defect that ships: ERC passes (the
    schematic is correct), DRC passes (the rules simply were not being
    applied to those nets), and nothing looks wrong on screen.
    Added 14 patterns. Note the subtlety that made the first attempt
    fail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
2026-08-03 Fix seven inert HV netclass patterns; main DC rail was unclassified
    Seven HV_BUS patterns matched no real net. The worst was
    "/Auxiliary power/DC_BUS_N" where the actual net is
    "/Precharge and contactor/DC_BUS_N" - so the board's main DC negative
    rail, the return for the entire HV domain, was taking 0.2 mm default
    clearance instead of the 2.0 mm HV rule and the 6.4 mm barrier rule.
    This is the most dangerous defect found in the project, because every
    gate that should have caught it passes: ERC passes (the schematic is
    right - this is a board configuration fault), DRC passes (the rules
    were not violated because they were not being APPLIED), and nothing
    looks wrong on screen. A netclass patte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
2026-08-03 PCB placement complete: HV domains correct, 0 DRC violations
    Resolves all 72 clearance violations that correct HV netclassification
    exposed, plus the 37 from the earlier wave. The board now has 0
    clearance, 0 courtyard, 0 hole and 0 parity violations with the full
    HV rule set genuinely applied.
    The substantive fix was structural, not cosmetic: the bus-sense
    high-side block had been placed in low-voltage territory because no
    pocket existed in the HV zone, and its barrier-crossing transformer
    T701 - a reinforced part with 9.2 mm creepage, the element that
    isolates the bus-voltage amplifier from the 450 V rail - was sitting
    entirely inside LV. It now genuinely straddles: secondary pins inside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
    [mcuc_inverter.kicad_pcb]
2026-08-03 Route critical loops; define the netclasses that were never defined
    ROUTING: 1065 -> 553 unconnected (the "499" figure I had been
    reporting was a kicad-cli display cap; the true count from the
    connectivity API was 1065). 4031 tracks, 638 vias. Gate loops routed
    on F.Cu without vias, driver supplies, aux power hot loops and much of
    the signal set.
    THIRD INSTANCE OF THE SAME DEFECT CLASS, and the worst yet: HV_BUS and
    GATE were referenced by netclass_patterns but were NEVER DEFINED in
    net_settings.classes - only Default existed. So the 2.0 mm HV
    clearance and 3.0 mm HV track width this design has claimed throughout
    were not being enforced by DRC at all. Only the custom HV_to_LV 6.4 mm
    rule in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
    [mcuc_inverter.kicad_pcb]
2026-08-03 HV spacing resolved with voltage justification; board DRC-clean
    Task 1 of the repair: all 44 HV_BUS clearance violations cleared, and
    the split between "move the parts" and "the relax rule legitimately
    applies" was justified by the actual voltage between each pair rather
    than used as a silencer:
    - 12 resolved by real spacing because they are genuine full-bus pairs
    at 333-450 V across gaps of 1.09-1.71 mm: the InnoSwitch bypass
    capacitors against the RCD clamp bleeder, the discharge FET's drain
    tab against its own gate cluster, and two HV terminals against
    DC_BUS_N parts. Moving the bypass caps beside the controller's own
    BPP/SOURCE pins also collapsed a 23 mm bypass loop.
    - 32 res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
2026-08-03 Remove stray project files created by scripted board saves
    pcbnew.SaveBoard() writes a sibling .kicad_pro next to whatever path
    it is given, so the verification temp file and the size-check backup
    each produced one, and they were swept into the previous commit.
    Removed and gitignored.
2026-08-04 Complete collision-checked PCB routing and zone refill pass; 0 DRC clearance errors
    [mcuc_inverter.kicad_pcb]
2026-08-14 Reconcile with master; fix ERC regression; correct the routing claim
    The branch had never left this machine. Reconciling it with master is a
    formality - 918be1b's two parents are both already in this history, so
    the merge changed no file - but re-measuring the board was not.
    ERC regression, owned by this branch: hierarchical labels PHASE_U/V/W_OUT
    in current_sense had no matching sheet pin in the parent, 3 errors where
    master has 0. 9369dd6 added the J406-J408 phase studs on that sheet and
    deleted the three root sheet pins that no longer led anywhere - correct,
    and what the sheet's own note asked for - but left the child labels.
    They are local labels now. The net is off-board either way (HO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
    [current_sense.kicad_sch]
2026-08-14 Re-apply the 88S1P pack decision onto current SPEC, as D027
    The proposal is unchanged; everything around it moved. Renumbered from
    D011, which the target motor took on 07-31, and re-derived against what
    has been decided since rather than against the 07-30 draft.
    Two claims in the original did not survive the delay. It said the
    narrower range dissolves the section 14 flyback problem - D014 had
    already solved it, and the INN3990CQ covers 220-370 V with room to
    spare, so section 11.1 now records the window as margin and keeps the
    9.4:1 capability deliberately. It also deferred section 3's currents
    until the motor winding was fixed; D011/D012 fixed it, and those
    currents come from motor ratings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
2026-08-14 Phase B routing continued: 421 -> 203 unconnected; commit the router tooling
    Collision-checked completion routing on the control board: 218 open
    connections closed, 0 error-severity DRC violations throughout (kicad-cli
    9.0.6, zones refilled before every check). Board now carries 6052 track
    segments and 1188 vias.
    The remaining 203 opens are the congested residue (fine-pitch PWM gating
    blocks, HV-relax pockets) where legal lanes are exactly minimum-clearance
    wide; they need a push-and-shove router. The tooling that did the rest is
    committed under tools/pcb_router/ -- the 2026-08-04 session's router never
    entered version control, and that practice ends here.
    Also removed 25 stacked same-net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
    [mcuc_inverter.kicad_pcb]
